paraspective/MAGI-v2/hardware/cad/README.md

# MAGI Quadruped 3D Print Models

3D manufacturing design files for the physical chassis of the 12-DOF quadruped.

---

## Assembly CAD File

* **[MAGI.3mf](file:///home/aki/Downloads/MAGI/model%20&miscellenious/MAGI.3mf/)**: Master 3D Manufacturing Format project. Contains print tray layouts, settings, and parts list for the full assembly including:
  * Central electronics enclosure (mounting plates for Raspberry Pi 4 and ESP32)
  * Battery compartment and chassis frames
  * 3-DOF leg links: Coxa (hip rotation), Femur (upper leg), and Tibia (lower leg)
  * Servomotor joint brackets scaled for MG996R standard servos
