paraspective/MAGI-v2/media/README.md

# 🎬 MAGI Media & Demonstrations

This directory contains media recordings and demonstration videos of the MAGI Quadruped Robot.

---

## 📹 Videos

* **`NERV_video_MAGI.mp4`**: Demonstration showing the Eva-inspired boot sequences, system telemetry, and physical gait coordination loops.
