paraspective/MAGI-v2/docs/research/README.md

# 🔬 Theoretical Foundations & Architectural Whitepapers

This directory contains research whitepapers and theoretical derivations of the MAGI quadruped robotics architecture.

---

## 📑 Documents

1. **[`MAGI_ Complete Architectural Context.pdf`](MAGI_%20Complete%20Architectural%20Context.pdf)**
   - Complete technical specification of the multi-process ZeroMQ operating system, core pinning strategies, POSIX shared memory ring buffers, and node lifecycle finite-state machines.

2. **[`MAGI_Project_Final__.pdf`](MAGI_Project_Final__.pdf)**
   - Comprehensive project report covering the problem formulation, mechanical linkage stress calculations, agricultural requirements, and experimental testing.

3. **[`leg_FK_IK_math_and_python.pdf`](leg_FK_IK_math_and_python.pdf)**
   - Analytical derivation of the 3-DOF forward and inverse kinematics equations, geometric transformations, and Python reference implementation.
