paraspective/MAGI-v2/archive/urdf_iterations/URDF_initial/debug/extraction_report.md

# Extraction Report: MAGI_Assembly_URDF v1

**Exported:** 2026-08-22T17:00:06.268843
**Exporter:** v3.1.0

## Summary

| Metric | Value |
|---|---|
| Occurrences | 28 |
| Subassemblies | 0 |
| Leaf components | 28 |
| Joints (total) | 27 |
| As-built joints | 0 |
| Regular joints | 27 |
| Max nesting depth | 0 |

## Assembly Hierarchy

```
[MAGI_Assembly_URDF]  (design root)
  ├── HQpod_Coxal_Left_v2  (265.7g)
  ├── HQpod_Coxal_Left_v2  (265.7g)
  ├── HQpod_Coxal_Right_v2  (265.9g)
  ├── HQpod_Coxal_Right_v2  (265.9g)
  ├── HQpod_Coxal_Right_v2  (265.9g)
  ├── HQpod_Femur  (175.9g)
  ├── HQpod_Femur  (175.9g)
  ├── HQpod_Femur  (175.9g)
  ├── HQpod_Femur  (175.9g)
  ├── HQpod_Tibia_Left  (0.0g)
  ├── HQpod_Tibia_Left  (0.0g)
  ├── HQpod_Tibia_Right  (0.0g)
  ├── HQpod_Tibia_Right  (0.0g)
  ├── HexapodV3Mid  (430.7g)
  ├── HexapodV3Top  (1329.1g)
  ├── MG996R_servo  (240.1g)
  ├── MG996R_servo  (240.1g)
  ├── MG996R_servo  (240.1g)
  ├── MG996R_servo  (240.1g)
  ├── MG996R_servo  (240.1g)
  ├── MG996R_servo  (240.1g)
  ├── MG996R_servo  (240.1g)
  ├── MG996R_servo  (240.1g)
  ├── MG996R_servo  (240.1g)
  ├── MG996R_servo  (240.1g)
  ├── MG996R_servo  (240.1g)
  ├── MG996R_servo  (240.1g)
  ├── base_link  (461.4g)
```

## Occurrences

### Depth 0

#### 🔧 COMPONENT: `HQpod_Coxal_Left_v2`

| Property | Value |
|---|---|
| Full path | `HQpod_Coxal_Left_v2 v2:2` |
| Component name | HQpod_Coxal_Left_v2 v2 |
| Depth | 0 |
| Path segments | HQpod_Coxal_Left_v2 |
| **Transforms** | |
| Global position (m) | (-0.404878, 0.654014, 0.791767) |
| Global position (mm) | (-404.88, 654.01, 791.77) |
| Local transform (m) | (-0.404878, 0.654014, 0.791767) |
| Assembly context depth | 0 |
| transform2 (m) | (-0.404878, 0.654014, 0.791767) |
| **Physical** | |
| Mass | 0.265679 kg (265.679 g) |
| Volume | 3.384446e-05 m³ |
| Density | 7850.0 kg/m³ |
| Surface area | 1.688216e-02 m² |
| Body count | 1 |
| CoM (component-local, m) | (0.654519, 0.530483, 0.143259) |
| CoM (global, m) | (0.249641, 1.184497, 0.935026) |
| CoM (global, mm) | (249.64, 1184.50, 935.03) |
| **Inertia at origin (kg·m²)** | |
| Ixx, Iyy, Izz | 8.034032e-02, 1.193965e-01, 1.887933e-01 |
| Ixy, Ixz, Iyz | -9.225148e-02, -2.491133e-02, -2.019216e-02 |
| **Inertia at CoM (kg·m²)** | |
| Ixx, Iyy, Izz | 1.224354e-04, 1.284590e-04, 2.124719e-04 |
| Ixy, Ixz, Iyz | -4.781184e-06, 2.049328e-07, -1.526211e-06 |
| Bounding box (m) | 0.0612 × 0.0743 × 0.0288 |
| Bounding box (mm) | 61.20 × 74.25 × 28.79 |
| **Material & Appearance** | |
| Material | Steel |
| Appearance | Steel_Satin |
| Color (RGB 0-1) | (0.627, 0.627, 0.627) |
| Color (RGB 0-255) | (160, 160, 160) |

#### 🔧 COMPONENT: `HQpod_Coxal_Left_v2`

| Property | Value |
|---|---|
| Full path | `HQpod_Coxal_Left_v2 v2:3` |
| Component name | HQpod_Coxal_Left_v2 v2 |
| Depth | 0 |
| Path segments | HQpod_Coxal_Left_v2 |
| **Transforms** | |
| Global position (m) | (0.781262, 1.371194, 0.791767) |
| Global position (mm) | (781.26, 1371.19, 791.77) |
| Local transform (m) | (0.781262, 1.371194, 0.791767) |
| Assembly context depth | 0 |
| transform2 (m) | (0.781262, 1.371194, 0.791767) |
| **Physical** | |
| Mass | 0.265679 kg (265.679 g) |
| Volume | 3.384446e-05 m³ |
| Density | 7850.0 kg/m³ |
| Surface area | 1.688216e-02 m² |
| Body count | 1 |
| CoM (component-local, m) | (0.654519, 0.530483, 0.143259) |
| CoM (global, m) | (1.435781, 1.901677, 0.935026) |
| CoM (global, mm) | (1435.78, 1901.68, 935.03) |
| **Inertia at origin (kg·m²)** | |
| Ixx, Iyy, Izz | 8.034032e-02, 1.193965e-01, 1.887933e-01 |
| Ixy, Ixz, Iyz | -9.225148e-02, -2.491133e-02, -2.019216e-02 |
| **Inertia at CoM (kg·m²)** | |
| Ixx, Iyy, Izz | 1.224354e-04, 1.284590e-04, 2.124719e-04 |
| Ixy, Ixz, Iyz | -4.781184e-06, 2.049328e-07, -1.526211e-06 |
| Bounding box (m) | 0.0612 × 0.0743 × 0.0288 |
| Bounding box (mm) | 61.20 × 74.25 × 28.79 |
| **Material & Appearance** | |
| Material | Steel |
| Appearance | Steel_Satin |
| Color (RGB 0-1) | (0.627, 0.627, 0.627) |
| Color (RGB 0-255) | (160, 160, 160) |

#### 🔧 COMPONENT: `HQpod_Coxal_Right_v2`

| Property | Value |
|---|---|
| Full path | `HQpod_Coxal_Right_v2 v2:1` |
| Component name | HQpod_Coxal_Right_v2 v2 |
| Depth | 0 |
| Path segments | HQpod_Coxal_Right_v2 |
| **Transforms** | |
| Global position (m) | (0.451506, 1.303633, 0.793772) |
| Global position (mm) | (451.51, 1303.63, 793.77) |
| Local transform (m) | (0.451506, 1.303633, 0.793772) |
| Assembly context depth | 0 |
| transform2 (m) | (0.451506, 1.303633, 0.793772) |
| **Physical** | |
| Mass | 0.265916 kg (265.916 g) |
| Volume | 3.387469e-05 m³ |
| Density | 7850.0 kg/m³ |
| Surface area | 1.687297e-02 m² |
| Body count | 1 |
| CoM (component-local, m) | (0.656485, -0.209995, 0.143258) |
| CoM (global, m) | (1.107991, 1.093638, 0.937030) |
| CoM (global, mm) | (1107.99, 1093.64, 937.03) |
| **Inertia at origin (kg·m²)** | |
| Ixx, Iyy, Izz | 1.730728e-02, 1.201908e-01, 1.265447e-01 |
| Ixy, Ixz, Iyz | 3.666486e-02, -2.500879e-02, 8.001501e-03 |
| **Inertia at CoM (kg·m²)** | |
| Ixx, Iyy, Izz | 1.236173e-04, 1.306979e-04, 2.156704e-04 |
| Ixy, Ixz, Iyz | 6.091416e-06, -2.158245e-07, 1.833670e-06 |
| Bounding box (m) | 0.0612 × 0.0743 × 0.0288 |
| Bounding box (mm) | 61.20 × 74.25 × 28.79 |
| **Material & Appearance** | |
| Material | Steel |
| Appearance | Steel_Satin |
| Color (RGB 0-1) | (0.627, 0.627, 0.627) |
| Color (RGB 0-255) | (160, 160, 160) |

#### 🔧 COMPONENT: `HQpod_Coxal_Right_v2`

| Property | Value |
|---|---|
| Full path | `HQpod_Coxal_Right_v2 v2:2` |
| Component name | HQpod_Coxal_Right_v2 v2 |
| Depth | 0 |
| Path segments | HQpod_Coxal_Right_v2 |
| **Transforms** | |
| Global position (m) | (0.551768, 0.878564, 0.793126) |
| Global position (mm) | (551.77, 878.56, 793.13) |
| Local transform (m) | (0.551768, 0.878564, 0.793126) |
| Assembly context depth | 0 |
| transform2 (m) | (0.551768, 0.878564, 0.793126) |
| **Physical** | |
| Mass | 0.265916 kg (265.916 g) |
| Volume | 3.387469e-05 m³ |
| Density | 7850.0 kg/m³ |
| Surface area | 1.687297e-02 m² |
| Body count | 1 |
| CoM (component-local, m) | (0.656485, -0.209995, 0.143258) |
| CoM (global, m) | (1.208253, 0.668570, 0.936384) |
| CoM (global, mm) | (1208.25, 668.57, 936.38) |
| **Inertia at origin (kg·m²)** | |
| Ixx, Iyy, Izz | 1.730728e-02, 1.201908e-01, 1.265447e-01 |
| Ixy, Ixz, Iyz | 3.666486e-02, -2.500879e-02, 8.001501e-03 |
| **Inertia at CoM (kg·m²)** | |
| Ixx, Iyy, Izz | 1.236173e-04, 1.306979e-04, 2.156704e-04 |
| Ixy, Ixz, Iyz | 6.091416e-06, -2.158245e-07, 1.833670e-06 |
| Bounding box (m) | 0.0612 × 0.0743 × 0.0288 |
| Bounding box (mm) | 61.20 × 74.25 × 28.79 |
| **Material & Appearance** | |
| Material | Steel |
| Appearance | Steel_Satin |
| Color (RGB 0-1) | (0.627, 0.627, 0.627) |
| Color (RGB 0-255) | (160, 160, 160) |

#### 🔧 COMPONENT: `HQpod_Coxal_Right_v2`

| Property | Value |
|---|---|
| Full path | `HQpod_Coxal_Right_v2 v2:3` |
| Component name | HQpod_Coxal_Right_v2 v2 |
| Depth | 0 |
| Path segments | HQpod_Coxal_Right_v2 |
| **Transforms** | |
| Global position (m) | (-0.175460, 1.146328, 0.793126) |
| Global position (mm) | (-175.46, 1146.33, 793.13) |
| Local transform (m) | (-0.175460, 1.146328, 0.793126) |
| Assembly context depth | 0 |
| transform2 (m) | (-0.175460, 1.146328, 0.793126) |
| **Physical** | |
| Mass | 0.265916 kg (265.916 g) |
| Volume | 3.387469e-05 m³ |
| Density | 7850.0 kg/m³ |
| Surface area | 1.687297e-02 m² |
| Body count | 1 |
| CoM (component-local, m) | (0.656485, -0.209995, 0.143258) |
| CoM (global, m) | (0.481025, 0.936334, 0.936384) |
| CoM (global, mm) | (481.02, 936.33, 936.38) |
| **Inertia at origin (kg·m²)** | |
| Ixx, Iyy, Izz | 1.730728e-02, 1.201908e-01, 1.265447e-01 |
| Ixy, Ixz, Iyz | 3.666486e-02, -2.500879e-02, 8.001501e-03 |
| **Inertia at CoM (kg·m²)** | |
| Ixx, Iyy, Izz | 1.236173e-04, 1.306979e-04, 2.156704e-04 |
| Ixy, Ixz, Iyz | 6.091416e-06, -2.158245e-07, 1.833670e-06 |
| Bounding box (m) | 0.0612 × 0.0743 × 0.0288 |
| Bounding box (mm) | 61.20 × 74.25 × 28.79 |
| **Material & Appearance** | |
| Material | Steel |
| Appearance | Steel_Satin |
| Color (RGB 0-1) | (0.627, 0.627, 0.627) |
| Color (RGB 0-255) | (160, 160, 160) |

#### 🔧 COMPONENT: `HQpod_Femur`

| Property | Value |
|---|---|
| Full path | `HQpod_Femur v3:1` |
| Component name | HQpod_Femur v3 |
| Depth | 0 |
| Path segments | HQpod_Femur |
| **Transforms** | |
| Global position (m) | (0.397256, 0.479610, 0.829249) |
| Global position (mm) | (397.26, 479.61, 829.25) |
| Local transform (m) | (0.397256, 0.479610, 0.829249) |
| Assembly context depth | 0 |
| transform2 (m) | (0.397256, 0.479610, 0.829249) |
| **Physical** | |
| Mass | 0.175899 kg (175.899 g) |
| Volume | 2.240754e-05 m³ |
| Density | 7850.0 kg/m³ |
| Surface area | 1.302929e-02 m² |
| Body count | 1 |
| CoM (component-local, m) | (-0.322334, 0.640897, 0.531177) |
| CoM (global, m) | (0.074922, 1.120507, 1.360426) |
| CoM (global, mm) | (74.92, 1120.51, 1360.43) |
| **Inertia at origin (kg·m²)** | |
| Ixx, Iyy, Izz | 1.219842e-01, 6.806643e-02, 9.060316e-02 |
| Ixy, Ixz, Iyz | 3.633776e-02, 3.011686e-02, -5.988123e-02 |
| **Inertia at CoM (kg·m²)** | |
| Ixx, Iyy, Izz | 1.041289e-04, 1.608826e-04, 7.700635e-05 |
| Ixy, Ixz, Iyz | -1.829894e-08, 1.747986e-08, 1.882122e-08 |
| Bounding box (m) | 0.0850 × 0.0260 × 0.0561 |
| Bounding box (mm) | 85.00 × 26.00 × 56.10 |
| **Material & Appearance** | |
| Material | Steel |
| Appearance | Steel_Satin |
| Color (RGB 0-1) | (0.627, 0.627, 0.627) |
| Color (RGB 0-255) | (160, 160, 160) |

#### 🔧 COMPONENT: `HQpod_Femur`

| Property | Value |
|---|---|
| Full path | `HQpod_Femur v3:2` |
| Component name | HQpod_Femur v3 |
| Depth | 0 |
| Path segments | HQpod_Femur |
| **Transforms** | |
| Global position (m) | (-0.080593, 1.488554, -0.603287) |
| Global position (mm) | (-80.59, 1488.55, -603.29) |
| Local transform (m) | (-0.080593, 1.488554, -0.603287) |
| Assembly context depth | 0 |
| transform2 (m) | (-0.080593, 1.488554, -0.603287) |
| **Physical** | |
| Mass | 0.175899 kg (175.899 g) |
| Volume | 2.240754e-05 m³ |
| Density | 7850.0 kg/m³ |
| Surface area | 1.302929e-02 m² |
| Body count | 1 |
| CoM (component-local, m) | (-0.322334, 0.640897, 0.531177) |
| CoM (global, m) | (-0.402928, 2.129450, -0.072110) |
| CoM (global, mm) | (-402.93, 2129.45, -72.11) |
| **Inertia at origin (kg·m²)** | |
| Ixx, Iyy, Izz | 1.219842e-01, 6.806643e-02, 9.060316e-02 |
| Ixy, Ixz, Iyz | 3.633776e-02, 3.011686e-02, -5.988123e-02 |
| **Inertia at CoM (kg·m²)** | |
| Ixx, Iyy, Izz | 1.041289e-04, 1.608826e-04, 7.700635e-05 |
| Ixy, Ixz, Iyz | -1.829894e-08, 1.747986e-08, 1.882122e-08 |
| Bounding box (m) | 0.0850 × 0.0260 × 0.0561 |
| Bounding box (mm) | 85.00 × 26.00 × 56.10 |
| **Material & Appearance** | |
| Material | Steel |
| Appearance | Steel_Satin |
| Color (RGB 0-1) | (0.627, 0.627, 0.627) |
| Color (RGB 0-255) | (160, 160, 160) |

#### 🔧 COMPONENT: `HQpod_Femur`

| Property | Value |
|---|---|
| Full path | `HQpod_Femur v3:3` |
| Component name | HQpod_Femur v3 |
| Depth | 0 |
| Path segments | HQpod_Femur |
| **Transforms** | |
| Global position (m) | (0.384606, 0.091160, 0.506403) |
| Global position (mm) | (384.61, 91.16, 506.40) |
| Local transform (m) | (0.384606, 0.091160, 0.506403) |
| Assembly context depth | 0 |
| transform2 (m) | (0.384606, 0.091160, 0.506403) |
| **Physical** | |
| Mass | 0.175899 kg (175.899 g) |
| Volume | 2.240754e-05 m³ |
| Density | 7850.0 kg/m³ |
| Surface area | 1.302929e-02 m² |
| Body count | 1 |
| CoM (component-local, m) | (-0.322334, 0.640897, 0.531177) |
| CoM (global, m) | (0.062272, 0.732057, 1.037580) |
| CoM (global, mm) | (62.27, 732.06, 1037.58) |
| **Inertia at origin (kg·m²)** | |
| Ixx, Iyy, Izz | 1.219842e-01, 6.806643e-02, 9.060316e-02 |
| Ixy, Ixz, Iyz | 3.633776e-02, 3.011686e-02, -5.988123e-02 |
| **Inertia at CoM (kg·m²)** | |
| Ixx, Iyy, Izz | 1.041289e-04, 1.608826e-04, 7.700635e-05 |
| Ixy, Ixz, Iyz | -1.829894e-08, 1.747986e-08, 1.882122e-08 |
| Bounding box (m) | 0.0850 × 0.0260 × 0.0561 |
| Bounding box (mm) | 85.00 × 26.00 × 56.10 |
| **Material & Appearance** | |
| Material | Steel |
| Appearance | Steel_Satin |
| Color (RGB 0-1) | (0.627, 0.627, 0.627) |
| Color (RGB 0-255) | (160, 160, 160) |

#### 🔧 COMPONENT: `HQpod_Femur`

| Property | Value |
|---|---|
| Full path | `HQpod_Femur v3:4` |
| Component name | HQpod_Femur v3 |
| Depth | 0 |
| Path segments | HQpod_Femur |
| **Transforms** | |
| Global position (m) | (-0.008310, 1.933742, 0.506368) |
| Global position (mm) | (-8.31, 1933.74, 506.37) |
| Local transform (m) | (-0.008310, 1.933742, 0.506368) |
| Assembly context depth | 0 |
| transform2 (m) | (-0.008310, 1.933742, 0.506368) |
| **Physical** | |
| Mass | 0.175899 kg (175.899 g) |
| Volume | 2.240754e-05 m³ |
| Density | 7850.0 kg/m³ |
| Surface area | 1.302929e-02 m² |
| Body count | 1 |
| CoM (component-local, m) | (-0.322334, 0.640897, 0.531177) |
| CoM (global, m) | (-0.330644, 2.574639, 1.037545) |
| CoM (global, mm) | (-330.64, 2574.64, 1037.55) |
| **Inertia at origin (kg·m²)** | |
| Ixx, Iyy, Izz | 1.219842e-01, 6.806643e-02, 9.060316e-02 |
| Ixy, Ixz, Iyz | 3.633776e-02, 3.011686e-02, -5.988123e-02 |
| **Inertia at CoM (kg·m²)** | |
| Ixx, Iyy, Izz | 1.041289e-04, 1.608826e-04, 7.700635e-05 |
| Ixy, Ixz, Iyz | -1.829894e-08, 1.747986e-08, 1.882122e-08 |
| Bounding box (m) | 0.0850 × 0.0260 × 0.0561 |
| Bounding box (mm) | 85.00 × 26.00 × 56.10 |
| **Material & Appearance** | |
| Material | Steel |
| Appearance | Steel_Satin |
| Color (RGB 0-1) | (0.627, 0.627, 0.627) |
| Color (RGB 0-255) | (160, 160, 160) |

#### 🔧 COMPONENT: `HQpod_Tibia_Left`

| Property | Value |
|---|---|
| Full path | `HQpod_Tibia_Left v3:1` |
| Component name | HQpod_Tibia_Left v3 |
| Depth | 0 |
| Path segments | HQpod_Tibia_Left |
| **Transforms** | |
| Global position (m) | (0.078693, 0.964779, 0.673691) |
| Global position (mm) | (78.69, 964.78, 673.69) |
| Local transform (m) | (0.078693, 0.964779, 0.673691) |
| Assembly context depth | 0 |
| transform2 (m) | (0.078693, 0.964779, 0.673691) |
| **Physical** | |
| Mass | 0.000000 kg (0.000 g) |
| Volume | 0.000000e+00 m³ |
| Density | 0.0 kg/m³ |
| Surface area | 1.569374e-02 m² |
| Body count | 1 |
| CoM (component-local, m) | (0.000000, 0.000000, 0.000000) |
| CoM (global, m) | (0.078693, 0.964779, 0.673691) |
| CoM (global, mm) | (78.69, 964.78, 673.69) |
| **Inertia at origin (kg·m²)** | |
| Ixx, Iyy, Izz | 0.000000e+00, 0.000000e+00, 0.000000e+00 |
| Ixy, Ixz, Iyz | 0.000000e+00, 0.000000e+00, 0.000000e+00 |
| **Inertia at CoM (kg·m²)** | |
| Ixx, Iyy, Izz | 0.000000e+00, 0.000000e+00, 0.000000e+00 |
| Ixy, Ixz, Iyz | 0.000000e+00, 0.000000e+00, 0.000000e+00 |
| Bounding box (m) | 0.1103 × 0.1045 × 0.0288 |
| Bounding box (mm) | 110.30 × 104.49 × 28.79 |
| **Material & Appearance** | |
| Material | Steel |
| Appearance | Steel_Satin |
| Color (RGB 0-1) | (0.627, 0.627, 0.627) |
| Color (RGB 0-255) | (160, 160, 160) |

#### 🔧 COMPONENT: `HQpod_Tibia_Left`

| Property | Value |
|---|---|
| Full path | `HQpod_Tibia_Left v3:2` |
| Component name | HQpod_Tibia_Left v3 |
| Depth | 0 |
| Path segments | HQpod_Tibia_Left |
| **Transforms** | |
| Global position (m) | (0.297362, 1.061010, 0.673593) |
| Global position (mm) | (297.36, 1061.01, 673.59) |
| Local transform (m) | (0.297362, 1.061010, 0.673593) |
| Assembly context depth | 0 |
| transform2 (m) | (0.297362, 1.061010, 0.673593) |
| **Physical** | |
| Mass | 0.000000 kg (0.000 g) |
| Volume | 0.000000e+00 m³ |
| Density | 0.0 kg/m³ |
| Surface area | 1.569374e-02 m² |
| Body count | 1 |
| CoM (component-local, m) | (0.000000, 0.000000, 0.000000) |
| CoM (global, m) | (0.297362, 1.061010, 0.673593) |
| CoM (global, mm) | (297.36, 1061.01, 673.59) |
| **Inertia at origin (kg·m²)** | |
| Ixx, Iyy, Izz | 0.000000e+00, 0.000000e+00, 0.000000e+00 |
| Ixy, Ixz, Iyz | 0.000000e+00, 0.000000e+00, 0.000000e+00 |
| **Inertia at CoM (kg·m²)** | |
| Ixx, Iyy, Izz | 0.000000e+00, 0.000000e+00, 0.000000e+00 |
| Ixy, Ixz, Iyz | 0.000000e+00, 0.000000e+00, 0.000000e+00 |
| Bounding box (m) | 0.1103 × 0.1045 × 0.0288 |
| Bounding box (mm) | 110.30 × 104.49 × 28.79 |
| **Material & Appearance** | |
| Material | Steel |
| Appearance | Steel_Satin |
| Color (RGB 0-1) | (0.627, 0.627, 0.627) |
| Color (RGB 0-255) | (160, 160, 160) |

#### 🔧 COMPONENT: `HQpod_Tibia_Right`

| Property | Value |
|---|---|
| Full path | `HQpod_Tibia_Right v4:1` |
| Component name | HQpod_Tibia_Right v4 |
| Depth | 0 |
| Path segments | HQpod_Tibia_Right |
| **Transforms** | |
| Global position (m) | (0.681661, 0.752503, 0.909144) |
| Global position (mm) | (681.66, 752.50, 909.14) |
| Local transform (m) | (0.681661, 0.752503, 0.909144) |
| Assembly context depth | 0 |
| transform2 (m) | (0.681661, 0.752503, 0.909144) |
| **Physical** | |
| Mass | 0.000000 kg (0.000 g) |
| Volume | 0.000000e+00 m³ |
| Density | 0.0 kg/m³ |
| Surface area | 1.565780e-02 m² |
| Body count | 1 |
| CoM (component-local, m) | (0.000000, 0.000000, 0.000000) |
| CoM (global, m) | (0.681661, 0.752503, 0.909144) |
| CoM (global, mm) | (681.66, 752.50, 909.14) |
| **Inertia at origin (kg·m²)** | |
| Ixx, Iyy, Izz | 0.000000e+00, 0.000000e+00, 0.000000e+00 |
| Ixy, Ixz, Iyz | 0.000000e+00, 0.000000e+00, 0.000000e+00 |
| **Inertia at CoM (kg·m²)** | |
| Ixx, Iyy, Izz | 0.000000e+00, 0.000000e+00, 0.000000e+00 |
| Ixy, Ixz, Iyz | 0.000000e+00, 0.000000e+00, 0.000000e+00 |
| Bounding box (m) | 0.1103 × 0.1045 × 0.0288 |
| Bounding box (mm) | 110.30 × 104.49 × 28.79 |
| **Material & Appearance** | |
| Material | Steel |
| Appearance | Steel_Satin |
| Color (RGB 0-1) | (0.627, 0.627, 0.627) |
| Color (RGB 0-255) | (160, 160, 160) |

#### 🔧 COMPONENT: `HQpod_Tibia_Right`

| Property | Value |
|---|---|
| Full path | `HQpod_Tibia_Right v4:2` |
| Component name | HQpod_Tibia_Right v4 |
| Depth | 0 |
| Path segments | HQpod_Tibia_Right |
| **Transforms** | |
| Global position (m) | (-0.305643, 1.272667, 0.908881) |
| Global position (mm) | (-305.64, 1272.67, 908.88) |
| Local transform (m) | (-0.305643, 1.272667, 0.908881) |
| Assembly context depth | 0 |
| transform2 (m) | (-0.305643, 1.272667, 0.908881) |
| **Physical** | |
| Mass | 0.000000 kg (0.000 g) |
| Volume | 0.000000e+00 m³ |
| Density | 0.0 kg/m³ |
| Surface area | 1.565780e-02 m² |
| Body count | 1 |
| CoM (component-local, m) | (0.000000, 0.000000, 0.000000) |
| CoM (global, m) | (-0.305643, 1.272667, 0.908881) |
| CoM (global, mm) | (-305.64, 1272.67, 908.88) |
| **Inertia at origin (kg·m²)** | |
| Ixx, Iyy, Izz | 0.000000e+00, 0.000000e+00, 0.000000e+00 |
| Ixy, Ixz, Iyz | 0.000000e+00, 0.000000e+00, 0.000000e+00 |
| **Inertia at CoM (kg·m²)** | |
| Ixx, Iyy, Izz | 0.000000e+00, 0.000000e+00, 0.000000e+00 |
| Ixy, Ixz, Iyz | 0.000000e+00, 0.000000e+00, 0.000000e+00 |
| Bounding box (m) | 0.1103 × 0.1045 × 0.0288 |
| Bounding box (mm) | 110.30 × 104.49 × 28.79 |
| **Material & Appearance** | |
| Material | Steel |
| Appearance | Steel_Satin |
| Color (RGB 0-1) | (0.627, 0.627, 0.627) |
| Color (RGB 0-255) | (160, 160, 160) |

#### 🔧 COMPONENT: `HexapodV3Mid`

| Property | Value |
|---|---|
| Full path | `HexapodV3Mid v5:1` |
| Component name | HexapodV3Mid v5 |
| Depth | 0 |
| Path segments | HexapodV3Mid |
| **Transforms** | |
| Global position (m) | (0.113207, 1.351156, -0.242000) |
| Global position (mm) | (113.21, 1351.16, -242.00) |
| Local transform (m) | (0.113207, 1.351156, -0.242000) |
| Assembly context depth | 0 |
| transform2 (m) | (0.113207, 1.351156, -0.242000) |
| **Physical** | |
| Mass | 0.430715 kg (430.715 g) |
| Volume | 5.486815e-05 m³ |
| Density | 7850.0 kg/m³ |
| Surface area | 4.293367e-02 m² |
| Body count | 1 |
| CoM (component-local, m) | (0.056935, -0.338657, 0.392833) |
| CoM (global, m) | (0.170142, 1.012498, 0.150833) |
| CoM (global, mm) | (170.14, 1012.50, 150.83) |
| **Inertia at origin (kg·m²)** | |
| Ixx, Iyy, Izz | 1.162344e-01, 6.948798e-02, 5.277708e-02 |
| Ixy, Ixz, Iyz | 8.305790e-03, -9.600812e-03, 5.730056e-02 |
| **Inertia at CoM (kg·m²)** | |
| Ixx, Iyy, Izz | 3.691505e-04, 1.624727e-03, 1.982639e-03 |
| Ixy, Ixz, Iyz | 9.189307e-07, 3.260568e-05, 1.642784e-08 |
| Bounding box (m) | 0.2205 × 0.1193 × 0.0250 |
| Bounding box (mm) | 220.46 × 119.29 × 25.00 |
| **Material & Appearance** | |
| Material | Steel |
| Appearance | Steel_Satin |
| Color (RGB 0-1) | (0.627, 0.627, 0.627) |
| Color (RGB 0-255) | (160, 160, 160) |

#### 🔧 COMPONENT: `HexapodV3Top`

| Property | Value |
|---|---|
| Full path | `HexapodV3Top v3:1` |
| Component name | HexapodV3Top v3 |
| Depth | 0 |
| Path segments | HexapodV3Top |
| **Transforms** | |
| Global position (m) | (0.038772, -1.500410, -0.089852) |
| Global position (mm) | (38.77, -1500.41, -89.85) |
| Local transform (m) | (0.038772, -1.500410, -0.089852) |
| Assembly context depth | 0 |
| transform2 (m) | (0.038772, -1.500410, -0.089852) |
| **Physical** | |
| Mass | 1.329055 kg (1329.055 g) |
| Volume | 1.693064e-04 m³ |
| Density | 7850.0 kg/m³ |
| Surface area | 8.391715e-02 m² |
| Body count | 1 |
| CoM (component-local, m) | (0.148577, 2.513000, 0.237965) |
| CoM (global, m) | (0.187350, 1.012589, 0.148113) |
| CoM (global, mm) | (187.35, 1012.59, 148.11) |
| **Inertia at origin (kg·m²)** | |
| Ixx, Iyy, Izz | 8.474005e+00, 1.110737e-01, 8.434363e+00 |
| Ixy, Ixz, Iyz | -4.962347e-01, -4.698214e-02, -7.947849e-01 |
| **Inertia at CoM (kg·m²)** | |
| Ixx, Iyy, Izz | 5.538158e-03, 6.473322e-03, 1.181787e-02 |
| Ixy, Ixz, Iyz | 1.518249e-06, 8.338057e-06, -5.310300e-07 |
| Bounding box (m) | 0.2400 × 0.1974 × 0.0288 |
| Bounding box (mm) | 240.00 × 197.41 × 28.79 |
| **Material & Appearance** | |
| Material | Steel |
| Appearance | Steel_Satin |
| Color (RGB 0-1) | (0.627, 0.627, 0.627) |
| Color (RGB 0-255) | (160, 160, 160) |

#### 🔧 COMPONENT: `MG996R_servo`

| Property | Value |
|---|---|
| Full path | `MG996R_servo v1:1` |
| Component name | MG996R_servo v1 |
| Depth | 0 |
| Path segments | MG996R_servo |
| **Transforms** | |
| Global position (m) | (0.093697, 0.936976, 0.121750) |
| Global position (mm) | (93.70, 936.98, 121.75) |
| Local transform (m) | (0.093697, 0.936976, 0.121750) |
| Assembly context depth | 0 |
| transform2 (m) | (0.093697, 0.936976, 0.121750) |
| **Physical** | |
| Mass | 0.240073 kg (240.073 g) |
| Volume | 3.058254e-05 m³ |
| Density | 7850.0 kg/m³ |
| Surface area | 7.545639e-03 m² |
| Body count | 2 |
| CoM (component-local, m) | (0.020183, 0.019509, 0.000018) |
| CoM (global, m) | (0.113880, 0.956485, 0.121768) |
| CoM (global, mm) | (113.88, 956.49, 121.77) |
| **Inertia at origin (kg·m²)** | |
| Ixx, Iyy, Izz | 1.274550e-04, 1.382840e-04, 2.503359e-04 |
| Ixy, Ixz, Iyz | -9.390388e-05, -3.854612e-08, -1.701040e-07 |
| **Inertia at CoM (kg·m²)** | |
| Ixx, Iyy, Izz | 3.608015e-05, 4.048873e-05, 6.116593e-05 |
| Ixy, Ixz, Iyz | 6.266312e-07, 4.838323e-08, -8.607661e-08 |
| Bounding box (m) | 0.0533 × 0.0435 × 0.0200 |
| Bounding box (mm) | 53.30 × 43.49 × 20.00 |
| **Material & Appearance** | |
| Material | Steel |
| Appearance | Opaque_76_76_76 |
| Color (RGB 0-1) | (0.298, 0.298, 0.298) |
| Color (RGB 0-255) | (76, 76, 76) |
| **Per-body breakdown** | |
| Body 0: Body1 | mass=237.031g, material=Steel, inertia_src=api |
| Body 1: Body2 | mass=3.041g, material=Steel, inertia_src=api |

#### 🔧 COMPONENT: `MG996R_servo`

| Property | Value |
|---|---|
| Full path | `MG996R_servo v1:10` |
| Component name | MG996R_servo v1 |
| Depth | 0 |
| Path segments | MG996R_servo |
| **Transforms** | |
| Global position (m) | (0.321864, 0.867988, 0.103058) |
| Global position (mm) | (321.86, 867.99, 103.06) |
| Local transform (m) | (0.321864, 0.867988, 0.103058) |
| Assembly context depth | 0 |
| transform2 (m) | (0.321864, 0.867988, 0.103058) |
| **Physical** | |
| Mass | 0.240073 kg (240.073 g) |
| Volume | 3.058254e-05 m³ |
| Density | 7850.0 kg/m³ |
| Surface area | 7.545639e-03 m² |
| Body count | 2 |
| CoM (component-local, m) | (0.020183, 0.019509, 0.000018) |
| CoM (global, m) | (0.342047, 0.887498, 0.103076) |
| CoM (global, mm) | (342.05, 887.50, 103.08) |
| **Inertia at origin (kg·m²)** | |
| Ixx, Iyy, Izz | 1.274550e-04, 1.382840e-04, 2.503359e-04 |
| Ixy, Ixz, Iyz | -9.390388e-05, -3.854612e-08, -1.701040e-07 |
| **Inertia at CoM (kg·m²)** | |
| Ixx, Iyy, Izz | 3.608015e-05, 4.048873e-05, 6.116593e-05 |
| Ixy, Ixz, Iyz | 6.266312e-07, 4.838323e-08, -8.607661e-08 |
| Bounding box (m) | 0.0533 × 0.0435 × 0.0200 |
| Bounding box (mm) | 53.30 × 43.49 × 20.00 |
| **Material & Appearance** | |
| Material | Steel |
| Appearance | Opaque_76_76_76 |
| Color (RGB 0-1) | (0.298, 0.298, 0.298) |
| Color (RGB 0-255) | (76, 76, 76) |
| **Per-body breakdown** | |
| Body 0: Body1 | mass=237.031g, material=Steel, inertia_src=api |
| Body 1: Body2 | mass=3.041g, material=Steel, inertia_src=api |

#### 🔧 COMPONENT: `MG996R_servo`

| Property | Value |
|---|---|
| Full path | `MG996R_servo v1:11` |
| Component name | MG996R_servo v1 |
| Depth | 0 |
| Path segments | MG996R_servo |
| **Transforms** | |
| Global position (m) | (0.054432, 1.156914, 0.103023) |
| Global position (mm) | (54.43, 1156.91, 103.02) |
| Local transform (m) | (0.054432, 1.156914, 0.103023) |
| Assembly context depth | 0 |
| transform2 (m) | (0.054432, 1.156914, 0.103023) |
| **Physical** | |
| Mass | 0.240073 kg (240.073 g) |
| Volume | 3.058254e-05 m³ |
| Density | 7850.0 kg/m³ |
| Surface area | 7.545639e-03 m² |
| Body count | 2 |
| CoM (component-local, m) | (0.020183, 0.019509, 0.000018) |
| CoM (global, m) | (0.074615, 1.176424, 0.103041) |
| CoM (global, mm) | (74.62, 1176.42, 103.04) |
| **Inertia at origin (kg·m²)** | |
| Ixx, Iyy, Izz | 1.274550e-04, 1.382840e-04, 2.503359e-04 |
| Ixy, Ixz, Iyz | -9.390388e-05, -3.854612e-08, -1.701040e-07 |
| **Inertia at CoM (kg·m²)** | |
| Ixx, Iyy, Izz | 3.608015e-05, 4.048873e-05, 6.116593e-05 |
| Ixy, Ixz, Iyz | 6.266312e-07, 4.838323e-08, -8.607661e-08 |
| Bounding box (m) | 0.0533 × 0.0435 × 0.0200 |
| Bounding box (mm) | 53.30 × 43.49 × 20.00 |
| **Material & Appearance** | |
| Material | Steel |
| Appearance | Opaque_76_76_76 |
| Color (RGB 0-1) | (0.298, 0.298, 0.298) |
| Color (RGB 0-255) | (76, 76, 76) |
| **Per-body breakdown** | |
| Body 0: Body1 | mass=237.031g, material=Steel, inertia_src=api |
| Body 1: Body2 | mass=3.041g, material=Steel, inertia_src=api |

#### 🔧 COMPONENT: `MG996R_servo`

| Property | Value |
|---|---|
| Full path | `MG996R_servo v1:12` |
| Component name | MG996R_servo v1 |
| Depth | 0 |
| Path segments | MG996R_servo |
| **Transforms** | |
| Global position (m) | (0.084555, 1.128003, 0.116664) |
| Global position (mm) | (84.55, 1128.00, 116.66) |
| Local transform (m) | (0.084555, 1.128003, 0.116664) |
| Assembly context depth | 0 |
| transform2 (m) | (0.084555, 1.128003, 0.116664) |
| **Physical** | |
| Mass | 0.240073 kg (240.073 g) |
| Volume | 3.058254e-05 m³ |
| Density | 7850.0 kg/m³ |
| Surface area | 7.545639e-03 m² |
| Body count | 2 |
| CoM (component-local, m) | (0.020183, 0.019509, 0.000018) |
| CoM (global, m) | (0.104738, 1.147512, 0.116682) |
| CoM (global, mm) | (104.74, 1147.51, 116.68) |
| **Inertia at origin (kg·m²)** | |
| Ixx, Iyy, Izz | 1.274550e-04, 1.382840e-04, 2.503359e-04 |
| Ixy, Ixz, Iyz | -9.390388e-05, -3.854612e-08, -1.701040e-07 |
| **Inertia at CoM (kg·m²)** | |
| Ixx, Iyy, Izz | 3.608015e-05, 4.048873e-05, 6.116593e-05 |
| Ixy, Ixz, Iyz | 6.266312e-07, 4.838323e-08, -8.607661e-08 |
| Bounding box (m) | 0.0533 × 0.0435 × 0.0200 |
| Bounding box (mm) | 53.30 × 43.49 × 20.00 |
| **Material & Appearance** | |
| Material | Steel |
| Appearance | Opaque_76_76_76 |
| Color (RGB 0-1) | (0.298, 0.298, 0.298) |
| Color (RGB 0-255) | (76, 76, 76) |
| **Per-body breakdown** | |
| Body 0: Body1 | mass=237.031g, material=Steel, inertia_src=api |
| Body 1: Body2 | mass=3.041g, material=Steel, inertia_src=api |

#### 🔧 COMPONENT: `MG996R_servo`

| Property | Value |
|---|---|
| Full path | `MG996R_servo v1:13` |
| Component name | MG996R_servo v1 |
| Depth | 0 |
| Path segments | MG996R_servo |
| **Transforms** | |
| Global position (m) | (0.093512, 1.088137, 0.121104) |
| Global position (mm) | (93.51, 1088.14, 121.10) |
| Local transform (m) | (0.093512, 1.088137, 0.121104) |
| Assembly context depth | 0 |
| transform2 (m) | (0.093512, 1.088137, 0.121104) |
| **Physical** | |
| Mass | 0.240073 kg (240.073 g) |
| Volume | 3.058254e-05 m³ |
| Density | 7850.0 kg/m³ |
| Surface area | 7.545639e-03 m² |
| Body count | 2 |
| CoM (component-local, m) | (0.020183, 0.019509, 0.000018) |
| CoM (global, m) | (0.113695, 1.107646, 0.121122) |
| CoM (global, mm) | (113.69, 1107.65, 121.12) |
| **Inertia at origin (kg·m²)** | |
| Ixx, Iyy, Izz | 1.274550e-04, 1.382840e-04, 2.503359e-04 |
| Ixy, Ixz, Iyz | -9.390388e-05, -3.854612e-08, -1.701040e-07 |
| **Inertia at CoM (kg·m²)** | |
| Ixx, Iyy, Izz | 3.608015e-05, 4.048873e-05, 6.116593e-05 |
| Ixy, Ixz, Iyz | 6.266312e-07, 4.838323e-08, -8.607661e-08 |
| Bounding box (m) | 0.0533 × 0.0435 × 0.0200 |
| Bounding box (mm) | 53.30 × 43.49 × 20.00 |
| **Material & Appearance** | |
| Material | Steel |
| Appearance | Opaque_76_76_76 |
| Color (RGB 0-1) | (0.298, 0.298, 0.298) |
| Color (RGB 0-255) | (76, 76, 76) |
| **Per-body breakdown** | |
| Body 0: Body1 | mass=237.031g, material=Steel, inertia_src=api |
| Body 1: Body2 | mass=3.041g, material=Steel, inertia_src=api |

#### 🔧 COMPONENT: `MG996R_servo`

| Property | Value |
|---|---|
| Full path | `MG996R_servo v1:2` |
| Component name | MG996R_servo v1 |
| Depth | 0 |
| Path segments | MG996R_servo |
| **Transforms** | |
| Global position (m) | (0.085017, 0.897030, 0.117344) |
| Global position (mm) | (85.02, 897.03, 117.34) |
| Local transform (m) | (0.085017, 0.897030, 0.117344) |
| Assembly context depth | 0 |
| transform2 (m) | (0.085017, 0.897030, 0.117344) |
| **Physical** | |
| Mass | 0.240073 kg (240.073 g) |
| Volume | 3.058254e-05 m³ |
| Density | 7850.0 kg/m³ |
| Surface area | 7.545639e-03 m² |
| Body count | 2 |
| CoM (component-local, m) | (0.020183, 0.019509, 0.000018) |
| CoM (global, m) | (0.105200, 0.916539, 0.117362) |
| CoM (global, mm) | (105.20, 916.54, 117.36) |
| **Inertia at origin (kg·m²)** | |
| Ixx, Iyy, Izz | 1.274550e-04, 1.382840e-04, 2.503359e-04 |
| Ixy, Ixz, Iyz | -9.390388e-05, -3.854612e-08, -1.701040e-07 |
| **Inertia at CoM (kg·m²)** | |
| Ixx, Iyy, Izz | 3.608015e-05, 4.048873e-05, 6.116593e-05 |
| Ixy, Ixz, Iyz | 6.266312e-07, 4.838323e-08, -8.607661e-08 |
| Bounding box (m) | 0.0533 × 0.0435 × 0.0200 |
| Bounding box (mm) | 53.30 × 43.49 × 20.00 |
| **Material & Appearance** | |
| Material | Steel |
| Appearance | Opaque_76_76_76 |
| Color (RGB 0-1) | (0.298, 0.298, 0.298) |
| Color (RGB 0-255) | (76, 76, 76) |
| **Per-body breakdown** | |
| Body 0: Body1 | mass=237.031g, material=Steel, inertia_src=api |
| Body 1: Body2 | mass=3.041g, material=Steel, inertia_src=api |

#### 🔧 COMPONENT: `MG996R_servo`

| Property | Value |
|---|---|
| Full path | `MG996R_servo v1:3` |
| Component name | MG996R_servo v1 |
| Depth | 0 |
| Path segments | MG996R_servo |
| **Transforms** | |
| Global position (m) | (0.055129, 0.868019, 0.103529) |
| Global position (mm) | (55.13, 868.02, 103.53) |
| Local transform (m) | (0.055129, 0.868019, 0.103529) |
| Assembly context depth | 0 |
| transform2 (m) | (0.055129, 0.868019, 0.103529) |
| **Physical** | |
| Mass | 0.240073 kg (240.073 g) |
| Volume | 3.058254e-05 m³ |
| Density | 7850.0 kg/m³ |
| Surface area | 7.545639e-03 m² |
| Body count | 2 |
| CoM (component-local, m) | (0.020183, 0.019509, 0.000018) |
| CoM (global, m) | (0.075312, 0.887528, 0.103547) |
| CoM (global, mm) | (75.31, 887.53, 103.55) |
| **Inertia at origin (kg·m²)** | |
| Ixx, Iyy, Izz | 1.274550e-04, 1.382840e-04, 2.503359e-04 |
| Ixy, Ixz, Iyz | -9.390388e-05, -3.854612e-08, -1.701040e-07 |
| **Inertia at CoM (kg·m²)** | |
| Ixx, Iyy, Izz | 3.608015e-05, 4.048873e-05, 6.116593e-05 |
| Ixy, Ixz, Iyz | 6.266312e-07, 4.838323e-08, -8.607661e-08 |
| Bounding box (m) | 0.0533 × 0.0435 × 0.0200 |
| Bounding box (mm) | 53.30 × 43.49 × 20.00 |
| **Material & Appearance** | |
| Material | Steel |
| Appearance | Opaque_76_76_76 |
| Color (RGB 0-1) | (0.298, 0.298, 0.298) |
| Color (RGB 0-255) | (76, 76, 76) |
| **Per-body breakdown** | |
| Body 0: Body1 | mass=237.031g, material=Steel, inertia_src=api |
| Body 1: Body2 | mass=3.041g, material=Steel, inertia_src=api |

#### 🔧 COMPONENT: `MG996R_servo`

| Property | Value |
|---|---|
| Full path | `MG996R_servo v1:4` |
| Component name | MG996R_servo v1 |
| Depth | 0 |
| Path segments | MG996R_servo |
| **Transforms** | |
| Global position (m) | (0.282688, 1.088232, 0.121750) |
| Global position (mm) | (282.69, 1088.23, 121.75) |
| Local transform (m) | (0.282688, 1.088232, 0.121750) |
| Assembly context depth | 0 |
| transform2 (m) | (0.282688, 1.088232, 0.121750) |
| **Physical** | |
| Mass | 0.240073 kg (240.073 g) |
| Volume | 3.058254e-05 m³ |
| Density | 7850.0 kg/m³ |
| Surface area | 7.545639e-03 m² |
| Body count | 2 |
| CoM (component-local, m) | (0.020183, 0.019509, 0.000018) |
| CoM (global, m) | (0.302871, 1.107741, 0.121768) |
| CoM (global, mm) | (302.87, 1107.74, 121.77) |
| **Inertia at origin (kg·m²)** | |
| Ixx, Iyy, Izz | 1.274550e-04, 1.382840e-04, 2.503359e-04 |
| Ixy, Ixz, Iyz | -9.390388e-05, -3.854612e-08, -1.701040e-07 |
| **Inertia at CoM (kg·m²)** | |
| Ixx, Iyy, Izz | 3.608015e-05, 4.048873e-05, 6.116593e-05 |
| Ixy, Ixz, Iyz | 6.266312e-07, 4.838323e-08, -8.607661e-08 |
| Bounding box (m) | 0.0533 × 0.0435 × 0.0200 |
| Bounding box (mm) | 53.30 × 43.49 × 20.00 |
| **Material & Appearance** | |
| Material | Steel |
| Appearance | Opaque_76_76_76 |
| Color (RGB 0-1) | (0.298, 0.298, 0.298) |
| Color (RGB 0-255) | (76, 76, 76) |
| **Per-body breakdown** | |
| Body 0: Body1 | mass=237.031g, material=Steel, inertia_src=api |
| Body 1: Body2 | mass=3.041g, material=Steel, inertia_src=api |

#### 🔧 COMPONENT: `MG996R_servo`

| Property | Value |
|---|---|
| Full path | `MG996R_servo v1:6` |
| Component name | MG996R_servo v1 |
| Depth | 0 |
| Path segments | MG996R_servo |
| **Transforms** | |
| Global position (m) | (0.291039, 1.128759, 0.117246) |
| Global position (mm) | (291.04, 1128.76, 117.25) |
| Local transform (m) | (0.291039, 1.128759, 0.117246) |
| Assembly context depth | 0 |
| transform2 (m) | (0.291039, 1.128759, 0.117246) |
| **Physical** | |
| Mass | 0.240073 kg (240.073 g) |
| Volume | 3.058254e-05 m³ |
| Density | 7850.0 kg/m³ |
| Surface area | 7.545639e-03 m² |
| Body count | 2 |
| CoM (component-local, m) | (0.020183, 0.019509, 0.000018) |
| CoM (global, m) | (0.311222, 1.148268, 0.117264) |
| CoM (global, mm) | (311.22, 1148.27, 117.26) |
| **Inertia at origin (kg·m²)** | |
| Ixx, Iyy, Izz | 1.274550e-04, 1.382840e-04, 2.503359e-04 |
| Ixy, Ixz, Iyz | -9.390388e-05, -3.854612e-08, -1.701040e-07 |
| **Inertia at CoM (kg·m²)** | |
| Ixx, Iyy, Izz | 3.608015e-05, 4.048873e-05, 6.116593e-05 |
| Ixy, Ixz, Iyz | 6.266312e-07, 4.838323e-08, -8.607661e-08 |
| Bounding box (m) | 0.0533 × 0.0435 × 0.0200 |
| Bounding box (mm) | 53.30 × 43.49 × 20.00 |
| **Material & Appearance** | |
| Material | Steel |
| Appearance | Opaque_76_76_76 |
| Color (RGB 0-1) | (0.298, 0.298, 0.298) |
| Color (RGB 0-255) | (76, 76, 76) |
| **Per-body breakdown** | |
| Body 0: Body1 | mass=237.031g, material=Steel, inertia_src=api |
| Body 1: Body2 | mass=3.041g, material=Steel, inertia_src=api |

#### 🔧 COMPONENT: `MG996R_servo`

| Property | Value |
|---|---|
| Full path | `MG996R_servo v1:7` |
| Component name | MG996R_servo v1 |
| Depth | 0 |
| Path segments | MG996R_servo |
| **Transforms** | |
| Global position (m) | (0.320926, 1.157770, 0.103431) |
| Global position (mm) | (320.93, 1157.77, 103.43) |
| Local transform (m) | (0.320926, 1.157770, 0.103431) |
| Assembly context depth | 0 |
| transform2 (m) | (0.320926, 1.157770, 0.103431) |
| **Physical** | |
| Mass | 0.240073 kg (240.073 g) |
| Volume | 3.058254e-05 m³ |
| Density | 7850.0 kg/m³ |
| Surface area | 7.545639e-03 m² |
| Body count | 2 |
| CoM (component-local, m) | (0.020183, 0.019509, 0.000018) |
| CoM (global, m) | (0.341110, 1.177279, 0.103449) |
| CoM (global, mm) | (341.11, 1177.28, 103.45) |
| **Inertia at origin (kg·m²)** | |
| Ixx, Iyy, Izz | 1.274550e-04, 1.382840e-04, 2.503359e-04 |
| Ixy, Ixz, Iyz | -9.390388e-05, -3.854612e-08, -1.701040e-07 |
| **Inertia at CoM (kg·m²)** | |
| Ixx, Iyy, Izz | 3.608015e-05, 4.048873e-05, 6.116593e-05 |
| Ixy, Ixz, Iyz | 6.266312e-07, 4.838323e-08, -8.607661e-08 |
| Bounding box (m) | 0.0533 × 0.0435 × 0.0200 |
| Bounding box (mm) | 53.30 × 43.49 × 20.00 |
| **Material & Appearance** | |
| Material | Steel |
| Appearance | Opaque_76_76_76 |
| Color (RGB 0-1) | (0.298, 0.298, 0.298) |
| Color (RGB 0-255) | (76, 76, 76) |
| **Per-body breakdown** | |
| Body 0: Body1 | mass=237.031g, material=Steel, inertia_src=api |
| Body 1: Body2 | mass=3.041g, material=Steel, inertia_src=api |

#### 🔧 COMPONENT: `MG996R_servo`

| Property | Value |
|---|---|
| Full path | `MG996R_servo v1:8` |
| Component name | MG996R_servo v1 |
| Depth | 0 |
| Path segments | MG996R_servo |
| **Transforms** | |
| Global position (m) | (0.282795, 0.936755, 0.121104) |
| Global position (mm) | (282.80, 936.76, 121.10) |
| Local transform (m) | (0.282795, 0.936755, 0.121104) |
| Assembly context depth | 0 |
| transform2 (m) | (0.282795, 0.936755, 0.121104) |
| **Physical** | |
| Mass | 0.240073 kg (240.073 g) |
| Volume | 3.058254e-05 m³ |
| Density | 7850.0 kg/m³ |
| Surface area | 7.545639e-03 m² |
| Body count | 2 |
| CoM (component-local, m) | (0.020183, 0.019509, 0.000018) |
| CoM (global, m) | (0.302978, 0.956265, 0.121122) |
| CoM (global, mm) | (302.98, 956.26, 121.12) |
| **Inertia at origin (kg·m²)** | |
| Ixx, Iyy, Izz | 1.274550e-04, 1.382840e-04, 2.503359e-04 |
| Ixy, Ixz, Iyz | -9.390388e-05, -3.854612e-08, -1.701040e-07 |
| **Inertia at CoM (kg·m²)** | |
| Ixx, Iyy, Izz | 3.608015e-05, 4.048873e-05, 6.116593e-05 |
| Ixy, Ixz, Iyz | 6.266312e-07, 4.838323e-08, -8.607661e-08 |
| Bounding box (m) | 0.0533 × 0.0435 × 0.0200 |
| Bounding box (mm) | 53.30 × 43.49 × 20.00 |
| **Material & Appearance** | |
| Material | Steel |
| Appearance | Opaque_76_76_76 |
| Color (RGB 0-1) | (0.298, 0.298, 0.298) |
| Color (RGB 0-255) | (76, 76, 76) |
| **Per-body breakdown** | |
| Body 0: Body1 | mass=237.031g, material=Steel, inertia_src=api |
| Body 1: Body2 | mass=3.041g, material=Steel, inertia_src=api |

#### 🔧 COMPONENT: `MG996R_servo`

| Property | Value |
|---|---|
| Full path | `MG996R_servo v1:9` |
| Component name | MG996R_servo v1 |
| Depth | 0 |
| Path segments | MG996R_servo |
| **Transforms** | |
| Global position (m) | (0.291741, 0.896900, 0.116699) |
| Global position (mm) | (291.74, 896.90, 116.70) |
| Local transform (m) | (0.291741, 0.896900, 0.116699) |
| Assembly context depth | 0 |
| transform2 (m) | (0.291741, 0.896900, 0.116699) |
| **Physical** | |
| Mass | 0.240073 kg (240.073 g) |
| Volume | 3.058254e-05 m³ |
| Density | 7850.0 kg/m³ |
| Surface area | 7.545639e-03 m² |
| Body count | 2 |
| CoM (component-local, m) | (0.020183, 0.019509, 0.000018) |
| CoM (global, m) | (0.311924, 0.916410, 0.116717) |
| CoM (global, mm) | (311.92, 916.41, 116.72) |
| **Inertia at origin (kg·m²)** | |
| Ixx, Iyy, Izz | 1.274550e-04, 1.382840e-04, 2.503359e-04 |
| Ixy, Ixz, Iyz | -9.390388e-05, -3.854612e-08, -1.701040e-07 |
| **Inertia at CoM (kg·m²)** | |
| Ixx, Iyy, Izz | 3.608015e-05, 4.048873e-05, 6.116593e-05 |
| Ixy, Ixz, Iyz | 6.266312e-07, 4.838323e-08, -8.607661e-08 |
| Bounding box (m) | 0.0533 × 0.0435 × 0.0200 |
| Bounding box (mm) | 53.30 × 43.49 × 20.00 |
| **Material & Appearance** | |
| Material | Steel |
| Appearance | Opaque_76_76_76 |
| Color (RGB 0-1) | (0.298, 0.298, 0.298) |
| Color (RGB 0-255) | (76, 76, 76) |
| **Per-body breakdown** | |
| Body 0: Body1 | mass=237.031g, material=Steel, inertia_src=api |
| Body 1: Body2 | mass=3.041g, material=Steel, inertia_src=api |

#### 🔧 COMPONENT: `base_link`

| Property | Value |
|---|---|
| Full path | `base_link v3:1` |
| Component name | base_link v3 |
| Depth | 0 |
| Path segments | base_link |
| **Transforms** | |
| Global position (m) | (0.000000, 0.000000, 0.000000) |
| Global position (mm) | (0.00, 0.00, 0.00) |
| Local transform (m) | (0.000000, 0.000000, 0.000000) |
| Assembly context depth | 0 |
| transform2 (m) | (0.000000, 0.000000, 0.000000) |
| **Physical** | |
| Mass | 0.461432 kg (461.432 g) |
| Volume | 5.878120e-05 m³ |
| Density | 7850.0 kg/m³ |
| Surface area | 4.620834e-02 m² |
| Body count | 1 |
| CoM (component-local, m) | (0.188950, 1.012566, 0.124814) |
| CoM (global, m) | (0.188950, 1.012566, 0.124814) |
| CoM (global, mm) | (188.95, 1012.57, 124.81) |
| **Inertia at origin (kg·m²)** | |
| Ixx, Iyy, Izz | 4.810833e-01, 2.548777e-02, 4.921769e-01 |
| Ixy, Ixz, Iyz | -8.828305e-02, -1.088082e-02, -5.831702e-02 |
| **Inertia at CoM (kg·m²)** | |
| Ixx, Iyy, Izz | 7.929840e-04, 1.825252e-03, 2.601024e-03 |
| Ixy, Ixz, Iyz | 8.295237e-08, 1.419208e-06, -2.865923e-08 |
| Bounding box (m) | 0.2195 × 0.1449 × 0.0270 |
| Bounding box (mm) | 219.50 × 144.90 × 27.00 |
| **Material & Appearance** | |
| Material | Steel |
| Appearance | Steel_Satin |
| Color (RGB 0-1) | (0.627, 0.627, 0.627) |
| Color (RGB 0-255) | (160, 160, 160) |

## Joints

#### 🔧 Joint: `Revolute_12` (regular)

| Property | Value |
|---|---|
| Defining component | MAGI_Assembly_URDF (MAGI_Assembly_URDF v1) |
| Suppressed | False |
| Motion type | revolute (enum=1) |
| Axis | (-0.0000, 0.0000, 1.0000) |
| **Connections** | |
| Parent (occ2) | `MG996R_servo` |
| Parent path | `MG996R_servo v1:4` |
| Child (occ1) | `HQpod_Coxal_Left_v2` |
| Child path | `HQpod_Coxal_Left_v2 v2:3` |
| **Geometry (all sources, raw cm)** | |
| geometryOrOriginOne | (27.5370, 108.0914, 16.1744) |
| geometryOrOriginTwo | (27.5370, 108.0914, 16.1744) |
| occ1.transform | (78.1262, 137.1194, 79.1767) ctx_depth=0 |
| occ1.global (assembled) | (78.1262, 137.1194, 79.1767) |
| occ2.transform | (28.2688, 108.8232, 12.1750) ctx_depth=0 |
| occ2.global (assembled) | (28.2688, 108.8232, 12.1750) |
| **Picked origin (m)** | (0.275370, 1.080914, 0.161744) via `geometryOrOriginOne` |
| Rotation limits (rad) | [-0.3840, 1.5708] |

#### 🔧 Joint: `Revolute_14` (regular)

| Property | Value |
|---|---|
| Defining component | MAGI_Assembly_URDF (MAGI_Assembly_URDF v1) |
| Suppressed | False |
| Motion type | revolute (enum=1) |
| Axis | (0.6965, -0.7176, -0.0000) |
| **Connections** | |
| Parent (occ2) | `MG996R_servo` |
| Parent path | `MG996R_servo v1:6` |
| Child (occ1) | `HQpod_Femur` |
| Child path | `HQpod_Femur v3:2` |
| **Geometry (all sources, raw cm)** | |
| geometryOrOriginOne | (31.8895, 110.0061, 12.7595) |
| geometryOrOriginTwo | (31.8895, 110.0061, 12.7595) |
| occ1.transform | (-8.0593, 148.8554, -60.3287) ctx_depth=0 |
| occ1.global (assembled) | (-8.0593, 148.8554, -60.3287) |
| occ2.transform | (29.1039, 112.8759, 11.7246) ctx_depth=0 |
| occ2.global (assembled) | (29.1039, 112.8759, 11.7246) |
| **Picked origin (m)** | (0.318895, 1.100061, 0.127595) via `geometryOrOriginOne` |
| Rotation limits (rad) | [-1.3963, 0.9599] |

#### 🔧 Joint: `Revolute_15` (regular)

| Property | Value |
|---|---|
| Defining component | MAGI_Assembly_URDF (MAGI_Assembly_URDF v1) |
| Suppressed | False |
| Motion type | revolute (enum=1) |
| Axis | (0.6965, -0.7176, -0.0000) |
| **Connections** | |
| Parent (occ2) | `HQpod_Femur` |
| Parent path | `HQpod_Femur v3:2` |
| Child (occ1) | `MG996R_servo` |
| Child path | `MG996R_servo v1:7` |
| **Geometry (all sources, raw cm)** | |
| geometryOrOriginOne | (35.5213, 113.5315, 9.8256) |
| geometryOrOriginTwo | (35.5213, 113.5315, 9.8256) |
| occ1.transform | (32.0926, 115.7770, 10.3431) ctx_depth=0 |
| occ1.global (assembled) | (32.0926, 115.7770, 10.3431) |
| occ2.transform | (-8.0593, 148.8554, -60.3287) ctx_depth=0 |
| occ2.global (assembled) | (-8.0593, 148.8554, -60.3287) |
| **Picked origin (m)** | (0.355213, 1.135315, 0.098256) via `geometryOrOriginOne` |
| Rotation limits (rad) | [-1.5708, 1.5708] |

#### 🔧 Joint: `Revolute_18` (regular)

| Property | Value |
|---|---|
| Defining component | MAGI_Assembly_URDF (MAGI_Assembly_URDF v1) |
| Suppressed | False |
| Motion type | revolute (enum=1) |
| Axis | (-0.0000, 0.0000, 1.0000) |
| **Connections** | |
| Parent (occ2) | `MG996R_servo` |
| Parent path | `MG996R_servo v1:8` |
| Child (occ1) | `HQpod_Coxal_Right_v2` |
| Child path | `HQpod_Coxal_Right_v2 v2:2` |
| **Geometry (all sources, raw cm)** | |
| geometryOrOriginOne | (27.5477, 94.4073, 16.1098) |
| geometryOrOriginTwo | (27.5477, 94.4073, 16.1098) |
| occ1.transform | (55.1768, 87.8564, 79.3126) ctx_depth=0 |
| occ1.global (assembled) | (55.1768, 87.8564, 79.3126) |
| occ2.transform | (28.2795, 93.6755, 12.1104) ctx_depth=0 |
| occ2.global (assembled) | (28.2795, 93.6755, 12.1104) |
| **Picked origin (m)** | (0.275477, 0.944073, 0.161098) via `geometryOrOriginOne` |
| Rotation limits (rad) | [-1.5708, 0.3840] |

#### 🔧 Joint: `Revolute_20` (regular)

| Property | Value |
|---|---|
| Defining component | MAGI_Assembly_URDF (MAGI_Assembly_URDF v1) |
| Suppressed | False |
| Motion type | revolute (enum=1) |
| Axis | (0.6925, 0.7215, -0.0000) |
| **Connections** | |
| Parent (occ2) | `MG996R_servo` |
| Parent path | `MG996R_servo v1:9` |
| Child (occ1) | `HQpod_Femur` |
| Child path | `HQpod_Femur v3:3` |
| **Geometry (all sources, raw cm)** | |
| geometryOrOriginOne | (31.9435, 92.5754, 12.7048) |
| geometryOrOriginTwo | (31.9435, 92.5754, 12.7048) |
| occ1.transform | (38.4606, 9.1160, 50.6403) ctx_depth=0 |
| occ1.global (assembled) | (38.4606, 9.1160, 50.6403) |
| occ2.transform | (29.1741, 89.6900, 11.6699) ctx_depth=0 |
| occ2.global (assembled) | (29.1741, 89.6900, 11.6699) |
| **Picked origin (m)** | (0.319435, 0.925754, 0.127048) via `geometryOrOriginOne` |
| Rotation limits (rad) | [-0.9599, 1.3963] |

#### 🔧 Joint: `Revolute_21` (regular)

| Property | Value |
|---|---|
| Defining component | MAGI_Assembly_URDF (MAGI_Assembly_URDF v1) |
| Suppressed | False |
| Motion type | revolute (enum=1) |
| Axis | (0.6925, 0.7215, -0.0000) |
| **Connections** | |
| Parent (occ2) | `HQpod_Femur` |
| Parent path | `HQpod_Femur v3:3` |
| Child (occ1) | `MG996R_servo` |
| Child path | `MG996R_servo v1:10` |
| **Geometry (all sources, raw cm)** | |
| geometryOrOriginOne | (35.6024, 89.0636, 9.7883) |
| geometryOrOriginTwo | (35.6024, 89.0636, 9.7883) |
| occ1.transform | (32.1864, 86.7988, 10.3058) ctx_depth=0 |
| occ1.global (assembled) | (32.1864, 86.7988, 10.3058) |
| occ2.transform | (38.4606, 9.1160, 50.6403) ctx_depth=0 |
| occ2.global (assembled) | (38.4606, 9.1160, 50.6403) |
| **Picked origin (m)** | (0.356024, 0.890636, 0.097883) via `geometryOrOriginOne` |
| Rotation limits (rad) | [-1.5708, 1.5708] |

#### 🔧 Joint: `Revolute_24` (regular)

| Property | Value |
|---|---|
| Defining component | MAGI_Assembly_URDF (MAGI_Assembly_URDF v1) |
| Suppressed | False |
| Motion type | revolute (enum=1) |
| Axis | (-0.0000, 0.0000, 1.0000) |
| **Connections** | |
| Parent (occ2) | `MG996R_servo` |
| Parent path | `MG996R_servo v1:13` |
| Child (occ1) | `HQpod_Coxal_Right_v2` |
| Child path | `HQpod_Coxal_Right_v2 v2:3` |
| **Geometry (all sources, raw cm)** | |
| geometryOrOriginOne | (10.0830, 108.0819, 16.1098) |
| geometryOrOriginTwo | (10.0830, 108.0819, 16.1098) |
| occ1.transform | (-17.5460, 114.6328, 79.3126) ctx_depth=0 |
| occ1.global (assembled) | (-17.5460, 114.6328, 79.3126) |
| occ2.transform | (9.3512, 108.8137, 12.1104) ctx_depth=0 |
| occ2.global (assembled) | (9.3512, 108.8137, 12.1104) |
| **Picked origin (m)** | (0.100830, 1.080819, 0.161098) via `geometryOrOriginOne` |
| Rotation limits (rad) | [-1.5708, 0.5934] |

#### 🔧 Joint: `Revolute_26` (regular)

| Property | Value |
|---|---|
| Defining component | MAGI_Assembly_URDF (MAGI_Assembly_URDF v1) |
| Suppressed | False |
| Motion type | revolute (enum=1) |
| Axis | (-0.6925, -0.7215, -0.0000) |
| **Connections** | |
| Parent (occ2) | `MG996R_servo` |
| Parent path | `MG996R_servo v1:12` |
| Child (occ1) | `HQpod_Femur` |
| Child path | `HQpod_Femur v3:4` |
| **Geometry (all sources, raw cm)** | |
| geometryOrOriginOne | (5.6861, 109.9148, 12.7013) |
| geometryOrOriginTwo | (5.6861, 109.9148, 12.7013) |
| occ1.transform | (-0.8310, 193.3742, 50.6368) ctx_depth=0 |
| occ1.global (assembled) | (-0.8310, 193.3742, 50.6368) |
| occ2.transform | (8.4555, 112.8003, 11.6664) ctx_depth=0 |
| occ2.global (assembled) | (8.4555, 112.8003, 11.6664) |
| **Picked origin (m)** | (0.056861, 1.099148, 0.127013) via `geometryOrOriginOne` |
| Rotation limits (rad) | [-0.9599, 1.3963] |

#### 🔧 Joint: `Revolute_27` (regular)

| Property | Value |
|---|---|
| Defining component | MAGI_Assembly_URDF (MAGI_Assembly_URDF v1) |
| Suppressed | False |
| Motion type | revolute (enum=1) |
| Axis | (-0.6925, -0.7215, -0.0000) |
| **Connections** | |
| Parent (occ2) | `HQpod_Femur` |
| Parent path | `HQpod_Femur v3:4` |
| Child (occ1) | `MG996R_servo` |
| Child path | `MG996R_servo v1:11` |
| **Geometry (all sources, raw cm)** | |
| geometryOrOriginOne | (2.0272, 113.4266, 9.7848) |
| geometryOrOriginTwo | (2.0272, 113.4266, 9.7848) |
| occ1.transform | (5.4432, 115.6914, 10.3023) ctx_depth=0 |
| occ1.global (assembled) | (5.4432, 115.6914, 10.3023) |
| occ2.transform | (-0.8310, 193.3742, 50.6368) ctx_depth=0 |
| occ2.global (assembled) | (-0.8310, 193.3742, 50.6368) |
| **Picked origin (m)** | (0.020272, 1.134266, 0.097848) via `geometryOrOriginOne` |
| Rotation limits (rad) | [-1.5708, 1.5708] |

#### 🔧 Joint: `Revolute_5` (regular)

| Property | Value |
|---|---|
| Defining component | MAGI_Assembly_URDF (MAGI_Assembly_URDF v1) |
| Suppressed | False |
| Motion type | revolute (enum=1) |
| Axis | (-0.0000, 0.0000, 1.0000) |
| **Connections** | |
| Parent (occ2) | `MG996R_servo` |
| Parent path | `MG996R_servo v1:1` |
| Child (occ1) | `HQpod_Coxal_Left_v2` |
| Child path | `HQpod_Coxal_Left_v2 v2:2` |
| **Geometry (all sources, raw cm)** | |
| geometryOrOriginOne | (10.1015, 94.4294, 16.1744) |
| geometryOrOriginTwo | (10.1015, 94.4294, 16.1744) |
| occ1.transform | (-40.4878, 65.4014, 79.1767) ctx_depth=0 |
| occ1.global (assembled) | (-40.4878, 65.4014, 79.1767) |
| occ2.transform | (9.3697, 93.6976, 12.1750) ctx_depth=0 |
| occ2.global (assembled) | (9.3697, 93.6976, 12.1750) |
| **Picked origin (m)** | (0.101015, 0.944294, 0.161744) via `geometryOrOriginOne` |
| Rotation limits (rad) | [-0.5934, 1.5708] |

#### 🔧 Joint: `Revolute_7` (regular)

| Property | Value |
|---|---|
| Defining component | MAGI_Assembly_URDF (MAGI_Assembly_URDF v1) |
| Suppressed | False |
| Motion type | revolute (enum=1) |
| Axis | (-0.6965, 0.7176, -0.0000) |
| **Connections** | |
| Parent (occ2) | `MG996R_servo` |
| Parent path | `MG996R_servo v1:2` |
| Child (occ1) | `HQpod_Femur` |
| Child path | `HQpod_Femur v3:1` |
| **Geometry (all sources, raw cm)** | |
| geometryOrOriginOne | (5.7161, 92.5728, 12.7693) |
| geometryOrOriginTwo | (5.7161, 92.5728, 12.7693) |
| occ1.transform | (39.7256, 47.9610, 82.9249) ctx_depth=0 |
| occ1.global (assembled) | (39.7256, 47.9610, 82.9249) |
| occ2.transform | (8.5017, 89.7030, 11.7344) ctx_depth=0 |
| occ2.global (assembled) | (8.5017, 89.7030, 11.7344) |
| **Picked origin (m)** | (0.057161, 0.925728, 0.127693) via `geometryOrOriginOne` |
| Rotation limits (rad) | [-1.3963, 0.9599] |

#### 🔧 Joint: `Revolute_8` (regular)

| Property | Value |
|---|---|
| Defining component | MAGI_Assembly_URDF (MAGI_Assembly_URDF v1) |
| Suppressed | False |
| Motion type | revolute (enum=1) |
| Axis | (-0.6965, 0.7176, -0.0000) |
| **Connections** | |
| Parent (occ2) | `HQpod_Femur` |
| Parent path | `HQpod_Femur v3:1` |
| Child (occ1) | `MG996R_servo` |
| Child path | `MG996R_servo v1:3` |
| **Geometry (all sources, raw cm)** | |
| geometryOrOriginOne | (2.0842, 89.0475, 9.8354) |
| geometryOrOriginTwo | (2.0842, 89.0475, 9.8354) |
| occ1.transform | (5.5129, 86.8019, 10.3529) ctx_depth=0 |
| occ1.global (assembled) | (5.5129, 86.8019, 10.3529) |
| occ2.transform | (39.7256, 47.9610, 82.9249) ctx_depth=0 |
| occ2.global (assembled) | (39.7256, 47.9610, 82.9249) |
| **Picked origin (m)** | (0.020842, 0.890475, 0.098354) via `geometryOrOriginOne` |
| Rotation limits (rad) | [-1.5708, 1.5708] |

#### 🔧 Joint: `Rigid_1` (regular)

| Property | Value |
|---|---|
| Defining component | MAGI_Assembly_URDF (MAGI_Assembly_URDF v1) |
| Suppressed | False |
| Motion type | rigid (enum=0) |
| Axis | (0.0000, 0.0000, 1.0000) |
| **Connections** | |
| Parent (occ2) | `base_link` |
| Parent path | `base_link v3:1` |
| Child (occ1) | `HexapodV3Mid` |
| Child path | `HexapodV3Mid v5:1` |
| **Geometry (all sources, raw cm)** | |
| geometryOrOriginOne | (9.7026, 105.3896, 14.8500) |
| geometryOrOriginTwo | (9.7026, 105.3896, 14.8500) |
| occ1.transform | (11.3207, 135.1156, -24.2000) ctx_depth=0 |
| occ1.global (assembled) | (11.3207, 135.1156, -24.2000) |
| occ2.transform | (0.0000, 0.0000, 0.0000) ctx_depth=0 |
| occ2.global (assembled) | (0.0000, 0.0000, 0.0000) |
| **Picked origin (m)** | (0.097026, 1.053896, 0.148500) via `geometryOrOriginOne` |

#### 🔧 Joint: `Rigid_10` (regular)

| Property | Value |
|---|---|
| Defining component | MAGI_Assembly_URDF (MAGI_Assembly_URDF v1) |
| Suppressed | False |
| Motion type | rigid (enum=0) |
| Axis | (0.0000, 0.0000, 1.0000) |
| **Connections** | |
| Parent (occ2) | `HexapodV3Top` |
| Parent path | `HexapodV3Top v3:1` |
| Child (occ1) | `MG996R_servo` |
| Child path | `MG996R_servo v1:4` |
| **Geometry (all sources, raw cm)** | |
| geometryOrOriginOne | (24.7686, 106.0302, 15.1498) |
| geometryOrOriginTwo | (24.7686, 106.0302, 15.1498) |
| occ1.transform | (28.2688, 108.8232, 12.1750) ctx_depth=0 |
| occ1.global (assembled) | (28.2688, 108.8232, 12.1750) |
| occ2.transform | (3.8772, -150.0410, -8.9852) ctx_depth=0 |
| occ2.global (assembled) | (3.8772, -150.0410, -8.9852) |
| **Picked origin (m)** | (0.247686, 1.060302, 0.151498) via `geometryOrOriginOne` |

#### 🔧 Joint: `Rigid_11` (regular)

| Property | Value |
|---|---|
| Defining component | MAGI_Assembly_URDF (MAGI_Assembly_URDF v1) |
| Suppressed | False |
| Motion type | rigid (enum=0) |
| Axis | (0.0000, 0.0000, 1.0000) |
| **Connections** | |
| Parent (occ2) | `MG996R_servo` |
| Parent path | `MG996R_servo v1:4` |
| Child (occ1) | `HQpod_Coxal_Right_v2` |
| Child path | `HQpod_Coxal_Right_v2 v2:1` |
| **Geometry (all sources, raw cm)** | |
| geometryOrOriginOne | (27.5370, 108.0914, 16.1744) |
| geometryOrOriginTwo | (27.5370, 108.0914, 16.1744) |
| occ1.transform | (45.1506, 130.3633, 79.3772) ctx_depth=0 |
| occ1.global (assembled) | (45.1506, 130.3633, 79.3772) |
| occ2.transform | (28.2688, 108.8232, 12.1750) ctx_depth=0 |
| occ2.global (assembled) | (28.2688, 108.8232, 12.1750) |
| **Picked origin (m)** | (0.275370, 1.080914, 0.161744) via `geometryOrOriginOne` |

#### 🔧 Joint: `Rigid_13` (regular)

| Property | Value |
|---|---|
| Defining component | MAGI_Assembly_URDF (MAGI_Assembly_URDF v1) |
| Suppressed | False |
| Motion type | rigid (enum=0) |
| Axis | (0.0000, 0.0000, 1.0000) |
| **Connections** | |
| Parent (occ2) | `HQpod_Coxal_Left_v2` |
| Parent path | `HQpod_Coxal_Left_v2 v2:3` |
| Child (occ1) | `MG996R_servo` |
| Child path | `MG996R_servo v1:6` |
| **Geometry (all sources, raw cm)** | |
| geometryOrOriginOne | (31.5796, 111.0432, 11.3445) |
| geometryOrOriginTwo | (31.5796, 111.0432, 11.3445) |
| occ1.transform | (29.1039, 112.8759, 11.7246) ctx_depth=0 |
| occ1.global (assembled) | (29.1039, 112.8759, 11.7246) |
| occ2.transform | (78.1262, 137.1194, 79.1767) ctx_depth=0 |
| occ2.global (assembled) | (78.1262, 137.1194, 79.1767) |
| **Picked origin (m)** | (0.315796, 1.110432, 0.113445) via `geometryOrOriginOne` |

#### 🔧 Joint: `Rigid_16` (regular)

| Property | Value |
|---|---|
| Defining component | MAGI_Assembly_URDF (MAGI_Assembly_URDF v1) |
| Suppressed | False |
| Motion type | rigid (enum=0) |
| Axis | (0.0000, 0.0000, 1.0000) |
| **Connections** | |
| Parent (occ2) | `MG996R_servo` |
| Parent path | `MG996R_servo v1:7` |
| Child (occ1) | `HQpod_Tibia_Left` |
| Child path | `HQpod_Tibia_Left v3:2` |
| **Geometry (all sources, raw cm)** | |
| geometryOrOriginOne | (36.7504, 116.1524, 7.6851) |
| geometryOrOriginTwo | (36.7504, 116.1524, 7.6851) |
| occ1.transform | (29.7362, 106.1010, 67.3593) ctx_depth=0 |
| occ1.global (assembled) | (29.7362, 106.1010, 67.3593) |
| occ2.transform | (32.0926, 115.7770, 10.3431) ctx_depth=0 |
| occ2.global (assembled) | (32.0926, 115.7770, 10.3431) |
| **Picked origin (m)** | (0.367504, 1.161524, 0.076851) via `geometryOrOriginOne` |

#### 🔧 Joint: `Rigid_17` (regular)

| Property | Value |
|---|---|
| Defining component | MAGI_Assembly_URDF (MAGI_Assembly_URDF v1) |
| Suppressed | False |
| Motion type | rigid (enum=0) |
| Axis | (0.0000, 0.0000, 1.0000) |
| **Connections** | |
| Parent (occ2) | `HexapodV3Top` |
| Parent path | `HexapodV3Top v3:1` |
| Child (occ1) | `MG996R_servo` |
| Child path | `MG996R_servo v1:8` |
| **Geometry (all sources, raw cm)** | |
| geometryOrOriginOne | (28.9019, 93.7603, 15.1498) |
| geometryOrOriginTwo | (28.9019, 93.7603, 15.1498) |
| occ1.transform | (28.2795, 93.6755, 12.1104) ctx_depth=0 |
| occ1.global (assembled) | (28.2795, 93.6755, 12.1104) |
| occ2.transform | (3.8772, -150.0410, -8.9852) ctx_depth=0 |
| occ2.global (assembled) | (3.8772, -150.0410, -8.9852) |
| **Picked origin (m)** | (0.289019, 0.937603, 0.151498) via `geometryOrOriginOne` |

#### 🔧 Joint: `Rigid_19` (regular)

| Property | Value |
|---|---|
| Defining component | MAGI_Assembly_URDF (MAGI_Assembly_URDF v1) |
| Suppressed | False |
| Motion type | rigid (enum=0) |
| Axis | (0.0000, 0.0000, 1.0000) |
| **Connections** | |
| Parent (occ2) | `HQpod_Coxal_Right_v2` |
| Parent path | `HQpod_Coxal_Right_v2 v2:2` |
| Child (occ1) | `MG996R_servo` |
| Child path | `MG996R_servo v1:9` |
| **Geometry (all sources, raw cm)** | |
| geometryOrOriginOne | (31.5948, 91.4900, 16.1198) |
| geometryOrOriginTwo | (31.5948, 91.4900, 16.1198) |
| occ1.transform | (29.1741, 89.6900, 11.6699) ctx_depth=0 |
| occ1.global (assembled) | (29.1741, 89.6900, 11.6699) |
| occ2.transform | (55.1768, 87.8564, 79.3126) ctx_depth=0 |
| occ2.global (assembled) | (55.1768, 87.8564, 79.3126) |
| **Picked origin (m)** | (0.315948, 0.914900, 0.161198) via `geometryOrOriginOne` |

#### 🔧 Joint: `Rigid_2` (regular)

| Property | Value |
|---|---|
| Defining component | MAGI_Assembly_URDF (MAGI_Assembly_URDF v1) |
| Suppressed | False |
| Motion type | rigid (enum=0) |
| Axis | (0.0000, 0.0000, 1.0000) |
| **Connections** | |
| Parent (occ2) | `HexapodV3Mid` |
| Parent path | `HexapodV3Mid v5:1` |
| Child (occ1) | `HexapodV3Top` |
| Child path | `HexapodV3Top v3:1` |
| **Geometry (all sources, raw cm)** | |
| geometryOrOriginOne | (9.7026, 97.1290, 15.1498) |
| geometryOrOriginTwo | (9.7026, 97.1290, 15.1498) |
| occ1.transform | (3.8772, -150.0410, -8.9852) ctx_depth=0 |
| occ1.global (assembled) | (3.8772, -150.0410, -8.9852) |
| occ2.transform | (11.3207, 135.1156, -24.2000) ctx_depth=0 |
| occ2.global (assembled) | (11.3207, 135.1156, -24.2000) |
| **Picked origin (m)** | (0.097026, 0.971290, 0.151498) via `geometryOrOriginOne` |

#### 🔧 Joint: `Rigid_22` (regular)

| Property | Value |
|---|---|
| Defining component | MAGI_Assembly_URDF (MAGI_Assembly_URDF v1) |
| Suppressed | False |
| Motion type | rigid (enum=0) |
| Axis | (0.0000, 0.0000, 1.0000) |
| **Connections** | |
| Parent (occ2) | `MG996R_servo` |
| Parent path | `MG996R_servo v1:10` |
| Child (occ1) | `HQpod_Tibia_Right` |
| Child path | `HQpod_Tibia_Right v4:1` |
| **Geometry (all sources, raw cm)** | |
| geometryOrOriginOne | (37.2070, 86.1034, 8.5138) |
| geometryOrOriginTwo | (37.2070, 86.1034, 8.5138) |
| occ1.transform | (68.1661, 75.2503, 90.9144) ctx_depth=0 |
| occ1.global (assembled) | (68.1661, 75.2503, 90.9144) |
| occ2.transform | (32.1864, 86.7988, 10.3058) ctx_depth=0 |
| occ2.global (assembled) | (32.1864, 86.7988, 10.3058) |
| **Picked origin (m)** | (0.372070, 0.861034, 0.085138) via `geometryOrOriginOne` |

#### 🔧 Joint: `Rigid_25` (regular)

| Property | Value |
|---|---|
| Defining component | MAGI_Assembly_URDF (MAGI_Assembly_URDF v1) |
| Suppressed | False |
| Motion type | rigid (enum=0) |
| Axis | (0.0000, 0.0000, 1.0000) |
| **Connections** | |
| Parent (occ2) | `HQpod_Coxal_Right_v2` |
| Parent path | `HQpod_Coxal_Right_v2 v2:3` |
| Child (occ1) | `MG996R_servo` |
| Child path | `MG996R_servo v1:12` |
| **Geometry (all sources, raw cm)** | |
| geometryOrOriginOne | (6.7563, 110.3078, 16.1163) |
| geometryOrOriginTwo | (6.7563, 110.3078, 16.1163) |
| occ1.transform | (8.4555, 112.8003, 11.6664) ctx_depth=0 |
| occ1.global (assembled) | (8.4555, 112.8003, 11.6664) |
| occ2.transform | (-17.5460, 114.6328, 79.3126) ctx_depth=0 |
| occ2.global (assembled) | (-17.5460, 114.6328, 79.3126) |
| **Picked origin (m)** | (0.067563, 1.103078, 0.161163) via `geometryOrOriginOne` |

#### 🔧 Joint: `Rigid_29` (regular)

| Property | Value |
|---|---|
| Defining component | MAGI_Assembly_URDF (MAGI_Assembly_URDF v1) |
| Suppressed | False |
| Motion type | rigid (enum=0) |
| Axis | (0.0000, 0.0000, 1.0000) |
| **Connections** | |
| Parent (occ2) | `HexapodV3Top` |
| Parent path | `HexapodV3Top v3:1` |
| Child (occ1) | `MG996R_servo` |
| Child path | `MG996R_servo v1:13` |
| **Geometry (all sources, raw cm)** | |
| geometryOrOriginOne | (9.4360, 109.4360, 15.1498) |
| geometryOrOriginTwo | (9.4360, 109.4360, 15.1498) |
| occ1.transform | (9.3512, 108.8137, 12.1104) ctx_depth=0 |
| occ1.global (assembled) | (9.3512, 108.8137, 12.1104) |
| occ2.transform | (3.8772, -150.0410, -8.9852) ctx_depth=0 |
| occ2.global (assembled) | (3.8772, -150.0410, -8.9852) |
| **Picked origin (m)** | (0.094360, 1.094360, 0.151498) via `geometryOrOriginOne` |

#### 🔧 Joint: `Rigid_30` (regular)

| Property | Value |
|---|---|
| Defining component | MAGI_Assembly_URDF (MAGI_Assembly_URDF v1) |
| Suppressed | False |
| Motion type | rigid (enum=0) |
| Axis | (0.0000, 0.0000, 1.0000) |
| **Connections** | |
| Parent (occ2) | `MG996R_servo` |
| Parent path | `MG996R_servo v1:11` |
| Child (occ1) | `HQpod_Tibia_Right` |
| Child path | `HQpod_Tibia_Right v4:2` |
| **Geometry (all sources, raw cm)** | |
| geometryOrOriginOne | (0.4851, 116.3269, 8.5603) |
| geometryOrOriginTwo | (0.4226, 116.3869, 8.5103) |
| occ1.transform | (-30.5643, 127.2667, 90.8881) ctx_depth=0 |
| occ1.global (assembled) | (-30.5643, 127.2667, 90.8881) |
| occ2.transform | (5.4432, 115.6914, 10.3023) ctx_depth=0 |
| occ2.global (assembled) | (5.4432, 115.6914, 10.3023) |
| **Picked origin (m)** | (0.004851, 1.163269, 0.085603) via `geometryOrOriginOne` |

#### 🔧 Joint: `Rigid_4` (regular)

| Property | Value |
|---|---|
| Defining component | MAGI_Assembly_URDF (MAGI_Assembly_URDF v1) |
| Suppressed | False |
| Motion type | rigid (enum=0) |
| Axis | (0.0000, 0.0000, 1.0000) |
| **Connections** | |
| Parent (occ2) | `HexapodV3Top` |
| Parent path | `HexapodV3Top v3:1` |
| Child (occ1) | `MG996R_servo` |
| Child path | `MG996R_servo v1:1` |
| **Geometry (all sources, raw cm)** | |
| geometryOrOriginOne | (12.8698, 96.4906, 15.1498) |
| geometryOrOriginTwo | (12.8698, 96.4906, 15.1498) |
| occ1.transform | (9.3697, 93.6976, 12.1750) ctx_depth=0 |
| occ1.global (assembled) | (9.3697, 93.6976, 12.1750) |
| occ2.transform | (3.8772, -150.0410, -8.9852) ctx_depth=0 |
| occ2.global (assembled) | (3.8772, -150.0410, -8.9852) |
| **Picked origin (m)** | (0.128698, 0.964906, 0.151498) via `geometryOrOriginOne` |

#### 🔧 Joint: `Rigid_6` (regular)

| Property | Value |
|---|---|
| Defining component | MAGI_Assembly_URDF (MAGI_Assembly_URDF v1) |
| Suppressed | False |
| Motion type | rigid (enum=0) |
| Axis | (0.0000, 0.0000, 1.0000) |
| **Connections** | |
| Parent (occ2) | `HQpod_Coxal_Left_v2` |
| Parent path | `HQpod_Coxal_Left_v2 v2:2` |
| Child (occ1) | `MG996R_servo` |
| Child path | `MG996R_servo v1:2` |
| **Geometry (all sources, raw cm)** | |
| geometryOrOriginOne | (6.0709, 91.4894, 16.1843) |
| geometryOrOriginTwo | (6.0709, 91.4894, 16.1843) |
| occ1.transform | (8.5017, 89.7030, 11.7344) ctx_depth=0 |
| occ1.global (assembled) | (8.5017, 89.7030, 11.7344) |
| occ2.transform | (-40.4878, 65.4014, 79.1767) ctx_depth=0 |
| occ2.global (assembled) | (-40.4878, 65.4014, 79.1767) |
| **Picked origin (m)** | (0.060709, 0.914894, 0.161843) via `geometryOrOriginOne` |

#### 🔧 Joint: `Rigid_9` (regular)

| Property | Value |
|---|---|
| Defining component | MAGI_Assembly_URDF (MAGI_Assembly_URDF v1) |
| Suppressed | False |
| Motion type | rigid (enum=0) |
| Axis | (0.0000, 0.0000, 1.0000) |
| **Connections** | |
| Parent (occ2) | `MG996R_servo` |
| Parent path | `MG996R_servo v1:3` |
| Child (occ1) | `HQpod_Tibia_Left` |
| Child path | `HQpod_Tibia_Left v3:1` |
| **Geometry (all sources, raw cm)** | |
| geometryOrOriginOne | (0.8551, 86.4265, 7.6949) |
| geometryOrOriginTwo | (0.8551, 86.4265, 7.6949) |
| occ1.transform | (7.8693, 96.4779, 67.3691) ctx_depth=0 |
| occ1.global (assembled) | (7.8693, 96.4779, 67.3691) |
| occ2.transform | (5.5129, 86.8019, 10.3529) ctx_depth=0 |
| occ2.global (assembled) | (5.5129, 86.8019, 10.3529) |
| **Picked origin (m)** | (0.008551, 0.864265, 0.076949) via `geometryOrOriginOne` |

## Quick Comparison Table

Compare these values with Fusion 360 Properties panel (right-click → Properties).

| Component | Mass (g) | World X,Y,Z (mm) | CoM X,Y,Z (mm) | Material |
|---|---|---|---|---|
| HQpod_Coxal_Left_v2 | 265.679 | (-404.88, 654.01, 791.77) | (249.64, 1184.50, 935.03) | Steel |
| HQpod_Coxal_Left_v2 | 265.679 | (781.26, 1371.19, 791.77) | (1435.78, 1901.68, 935.03) | Steel |
| HQpod_Coxal_Right_v2 | 265.916 | (451.51, 1303.63, 793.77) | (1107.99, 1093.64, 937.03) | Steel |
| HQpod_Coxal_Right_v2 | 265.916 | (551.77, 878.56, 793.13) | (1208.25, 668.57, 936.38) | Steel |
| HQpod_Coxal_Right_v2 | 265.916 | (-175.46, 1146.33, 793.13) | (481.02, 936.33, 936.38) | Steel |
| HQpod_Femur | 175.899 | (397.26, 479.61, 829.25) | (74.92, 1120.51, 1360.43) | Steel |
| HQpod_Femur | 175.899 | (-80.59, 1488.55, -603.29) | (-402.93, 2129.45, -72.11) | Steel |
| HQpod_Femur | 175.899 | (384.61, 91.16, 506.40) | (62.27, 732.06, 1037.58) | Steel |
| HQpod_Femur | 175.899 | (-8.31, 1933.74, 506.37) | (-330.64, 2574.64, 1037.55) | Steel |
| HQpod_Tibia_Left | 0.000 | (78.69, 964.78, 673.69) | (78.69, 964.78, 673.69) | Steel |
| HQpod_Tibia_Left | 0.000 | (297.36, 1061.01, 673.59) | (297.36, 1061.01, 673.59) | Steel |
| HQpod_Tibia_Right | 0.000 | (681.66, 752.50, 909.14) | (681.66, 752.50, 909.14) | Steel |
| HQpod_Tibia_Right | 0.000 | (-305.64, 1272.67, 908.88) | (-305.64, 1272.67, 908.88) | Steel |
| HexapodV3Mid | 430.715 | (113.21, 1351.16, -242.00) | (170.14, 1012.50, 150.83) | Steel |
| HexapodV3Top | 1329.055 | (38.77, -1500.41, -89.85) | (187.35, 1012.59, 148.11) | Steel |
| MG996R_servo | 240.073 | (93.70, 936.98, 121.75) | (113.88, 956.49, 121.77) | Steel |
| MG996R_servo | 240.073 | (321.86, 867.99, 103.06) | (342.05, 887.50, 103.08) | Steel |
| MG996R_servo | 240.073 | (54.43, 1156.91, 103.02) | (74.62, 1176.42, 103.04) | Steel |
| MG996R_servo | 240.073 | (84.55, 1128.00, 116.66) | (104.74, 1147.51, 116.68) | Steel |
| MG996R_servo | 240.073 | (93.51, 1088.14, 121.10) | (113.69, 1107.65, 121.12) | Steel |
| MG996R_servo | 240.073 | (85.02, 897.03, 117.34) | (105.20, 916.54, 117.36) | Steel |
| MG996R_servo | 240.073 | (55.13, 868.02, 103.53) | (75.31, 887.53, 103.55) | Steel |
| MG996R_servo | 240.073 | (282.69, 1088.23, 121.75) | (302.87, 1107.74, 121.77) | Steel |
| MG996R_servo | 240.073 | (291.04, 1128.76, 117.25) | (311.22, 1148.27, 117.26) | Steel |
| MG996R_servo | 240.073 | (320.93, 1157.77, 103.43) | (341.11, 1177.28, 103.45) | Steel |
| MG996R_servo | 240.073 | (282.80, 936.76, 121.10) | (302.98, 956.26, 121.12) | Steel |
| MG996R_servo | 240.073 | (291.74, 896.90, 116.70) | (311.92, 916.41, 116.72) | Steel |
| base_link | 461.432 | (0.00, 0.00, 0.00) | (188.95, 1012.57, 124.81) | Steel |

## Joint Origins Comparison

All origins shown in multiple coordinate systems for debugging.

| Joint | Source | Origin (cm, raw) | Origin (m, picked) | Motion | Axis |
|---|---|---|---|---|---|
| Revolute_12 | geometryOrOriginOne | goo1(27.54, 108.09, 16.17) | (0.2754, 1.0809, 0.1617) | revolute | (-0.0, 0.0, 1.0) |
| Revolute_14 | geometryOrOriginOne | goo1(31.89, 110.01, 12.76) | (0.3189, 1.1001, 0.1276) | revolute | (0.7, -0.7, -0.0) |
| Revolute_15 | geometryOrOriginOne | goo1(35.52, 113.53, 9.83) | (0.3552, 1.1353, 0.0983) | revolute | (0.7, -0.7, -0.0) |
| Revolute_18 | geometryOrOriginOne | goo1(27.55, 94.41, 16.11) | (0.2755, 0.9441, 0.1611) | revolute | (-0.0, 0.0, 1.0) |
| Revolute_20 | geometryOrOriginOne | goo1(31.94, 92.58, 12.70) | (0.3194, 0.9258, 0.1270) | revolute | (0.7, 0.7, -0.0) |
| Revolute_21 | geometryOrOriginOne | goo1(35.60, 89.06, 9.79) | (0.3560, 0.8906, 0.0979) | revolute | (0.7, 0.7, -0.0) |
| Revolute_24 | geometryOrOriginOne | goo1(10.08, 108.08, 16.11) | (0.1008, 1.0808, 0.1611) | revolute | (-0.0, 0.0, 1.0) |
| Revolute_26 | geometryOrOriginOne | goo1(5.69, 109.91, 12.70) | (0.0569, 1.0991, 0.1270) | revolute | (-0.7, -0.7, -0.0) |
| Revolute_27 | geometryOrOriginOne | goo1(2.03, 113.43, 9.78) | (0.0203, 1.1343, 0.0978) | revolute | (-0.7, -0.7, -0.0) |
| Revolute_5 | geometryOrOriginOne | goo1(10.10, 94.43, 16.17) | (0.1010, 0.9443, 0.1617) | revolute | (-0.0, 0.0, 1.0) |
| Revolute_7 | geometryOrOriginOne | goo1(5.72, 92.57, 12.77) | (0.0572, 0.9257, 0.1277) | revolute | (-0.7, 0.7, -0.0) |
| Revolute_8 | geometryOrOriginOne | goo1(2.08, 89.05, 9.84) | (0.0208, 0.8905, 0.0984) | revolute | (-0.7, 0.7, -0.0) |
| Rigid_1 | geometryOrOriginOne | goo1(9.70, 105.39, 14.85) | (0.0970, 1.0539, 0.1485) | rigid | (0.0, 0.0, 1.0) |
| Rigid_10 | geometryOrOriginOne | goo1(24.77, 106.03, 15.15) | (0.2477, 1.0603, 0.1515) | rigid | (0.0, 0.0, 1.0) |
| Rigid_11 | geometryOrOriginOne | goo1(27.54, 108.09, 16.17) | (0.2754, 1.0809, 0.1617) | rigid | (0.0, 0.0, 1.0) |
| Rigid_13 | geometryOrOriginOne | goo1(31.58, 111.04, 11.34) | (0.3158, 1.1104, 0.1134) | rigid | (0.0, 0.0, 1.0) |
| Rigid_16 | geometryOrOriginOne | goo1(36.75, 116.15, 7.69) | (0.3675, 1.1615, 0.0769) | rigid | (0.0, 0.0, 1.0) |
| Rigid_17 | geometryOrOriginOne | goo1(28.90, 93.76, 15.15) | (0.2890, 0.9376, 0.1515) | rigid | (0.0, 0.0, 1.0) |
| Rigid_19 | geometryOrOriginOne | goo1(31.59, 91.49, 16.12) | (0.3159, 0.9149, 0.1612) | rigid | (0.0, 0.0, 1.0) |
| Rigid_2 | geometryOrOriginOne | goo1(9.70, 97.13, 15.15) | (0.0970, 0.9713, 0.1515) | rigid | (0.0, 0.0, 1.0) |
| Rigid_22 | geometryOrOriginOne | goo1(37.21, 86.10, 8.51) | (0.3721, 0.8610, 0.0851) | rigid | (0.0, 0.0, 1.0) |
| Rigid_25 | geometryOrOriginOne | goo1(6.76, 110.31, 16.12) | (0.0676, 1.1031, 0.1612) | rigid | (0.0, 0.0, 1.0) |
| Rigid_29 | geometryOrOriginOne | goo1(9.44, 109.44, 15.15) | (0.0944, 1.0944, 0.1515) | rigid | (0.0, 0.0, 1.0) |
| Rigid_30 | geometryOrOriginOne | goo1(0.49, 116.33, 8.56) | (0.0049, 1.1633, 0.0856) | rigid | (0.0, 0.0, 1.0) |
| Rigid_4 | geometryOrOriginOne | goo1(12.87, 96.49, 15.15) | (0.1287, 0.9649, 0.1515) | rigid | (0.0, 0.0, 1.0) |
| Rigid_6 | geometryOrOriginOne | goo1(6.07, 91.49, 16.18) | (0.0607, 0.9149, 0.1618) | rigid | (0.0, 0.0, 1.0) |
| Rigid_9 | geometryOrOriginOne | goo1(0.86, 86.43, 7.69) | (0.0086, 0.8643, 0.0769) | rigid | (0.0, 0.0, 1.0) |
