paraspective/MAGI-v2/archive/references/Regis/Hardware/Battery Analysis.xlsx

 |  | Battery Analysis Spreadsheet
 | Current Battery |  | Batt # 1
Technology | Lithium-ion |  | LiFePO4
 | DC 12300 - DC12V Rechargeable 3000mAh lithium-ion Battery |  | NERMAK 12V 10Ah Lithium LiFePO4 Deep Cycle Battery, Built-in 10A BMS
Ah | 0.3 |  | 10
L | 3.465 |  | 5.94
W | 2.244 |  | 2.56
H | 0.827 |  | 3.7
Volume (in³) | 6.43030542 |  | 56.26368
Weight (g) | 200 |  | 1197.5
Weight(lbs) | 0.441 |  | 2.64
Peak Discharge | 2 |  | 20
Charge Density (Amps per Volume) | 0.04665408257 |  | 0.1777345527
Ah/kg | 1.5 |  | 8.350730689
Cost | $25.99 |  | $44.99
$$$/Ah | $86.63 |  | $4.50
