paraspective/MAGI-v2/archive/references/Regis/Hardware/Servo Motor & Controller/Robot Servo Analysis.xlsx

 | Servo Motor Comparison Chart
 |  |  |  |  |  |  |  |  |  |  |  | Stall Tq in Lbs / Arm Length (90°) |  | How much can we lift?
Servo Name | Model | Rotation | Weight (grams) | Idle Amps | Stall Torque (Min) | Stall Torque (Max) | Max Stall Tq in lbs | Volts | Stall Amps (Min) | Stall Amps (Max) |  |  | 2 cm | 3cm | 4cm | 5cm | 6cm | 7cm | 8cm | 9cm | 10cm
"9g servo" | MG90S | 180 | 13.4 | 0.01 | 1.8 | 2.2 | 4.850164 | 4.8 - 6.0 | 0.4 | 1 |  | 4.85 | 2.43 | 1.62 | 0.20 | 0.97 | 0.81 | 0.69 | 0.61 | 0.54 | 0.49
"Tower Pro 12kg" | MG996R | 180 | 55 | 0.02 | 9.4 | 11 | 24.25082 | 4.8 - 6.0 | 1.3 | 1.5 |  | 24.25 | 12.13 | 8.08 | 6.06 | 4.85 | 4.04 | 3.46 | 3.03 | 2.69 | 2.43
"Sun Founder 20kg" | SF3218MG | 270 | 56 | 0.05 | 20.5 | 22.8 | 50.265336 | 4.8 -7.2 | 1.5 | 2.7 |  | 50.27 | 25.13 | 16.76 | 12.57 | 10.05 | 8.38 | 7.18 | 6.28 | 5.59 | 5.03
"35kg" | DS3235 | 180 or 270 | 60 | 0.005 | 29 | 35 | 77.1617 | 5.0 -7.4 | 1.9 | 2.3 |  | 77.16 | 38.58 | 25.72 | 19.29 | 15.43 | 12.86 | 11.02 | 9.65 | 8.57 | 7.72
 | Power Consumption Of Servo Motors Graphs |  |  |  |  |  | Strength to Weight of Servo Motors Graph
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
