paraspective/MAGI-v2/hardware/urdf/MAGI_Assembly_URDF_description/config/frame_overrides.csv

link | parent_joint | joint_type | rule | original_roll_deg | original_pitch_deg | original_yaw_deg | post_roll_deg | post_pitch_deg | post_yaw_deg | role
HexapodV3Mid | Rigid_1 | fixed | keep | 0.000000 | 0.000000 | 0.000000 | 0.000000 | 0.000000 | 0.000000 | unchanged
HexapodV3Top | Rigid_2 | fixed | keep | 0.000000 | 0.000000 | 0.000000 | 0.000000 | 0.000000 | 0.000000 | unchanged
MAGI_Assembly_URDF_HQpod_Coxal_Left_v2 | Revolute_5 | revolute | auto | 30.853048 | 89.999234 | -15.000008 | 0.000000 | 0.000000 | 0.000000 | revolute_axis_z
MAGI_Assembly_URDF_HQpod_Coxal_Left_v2_2 | Revolute_12 | revolute | auto | 30.853063 | 89.999234 | 165.000008 | 0.000000 | 0.000000 | 0.000000 | revolute_axis_z
MAGI_Assembly_URDF_HQpod_Coxal_Right_v2 | Revolute_24 | revolute | auto | -66.175218 | 89.999790 | -20.000028 | 0.000000 | 0.000000 | 0.000000 | revolute_axis_z
MAGI_Assembly_URDF_HQpod_Coxal_Right_v2_2 | Revolute_31 | revolute | auto | -66.175163 | 89.999790 | 160.000026 | 0.000000 | 0.000000 | 0.000000 | revolute_axis_z
MAGI_Assembly_URDF_HQpod_Femur | Revolute_7 | revolute | auto | -90.000816 | -30.000393 | 44.147355 | -90.000707 | 0.000686 | 44.146947 | revolute_axis_z
MAGI_Assembly_URDF_HQpod_Femur_2 | Revolute_14 | revolute | auto | 90.000816 | 30.000393 | 44.147355 | 90.000707 | -0.000686 | 44.146947 | revolute_axis_z
MAGI_Assembly_URDF_HQpod_Femur_3 | Revolute_26 | revolute | auto | -90.000134 | 30.000192 | 136.175173 | 90.000116 | 0.000112 | -43.824759 | revolute_axis_z
MAGI_Assembly_URDF_HQpod_Femur_4 | Revolute_32 | revolute | auto | -90.000134 | 30.000192 | -43.824827 | -90.000116 | -0.000112 | -43.824759 | revolute_axis_z
MAGI_Assembly_URDF_HQpod_Tibia_Left | Rigid_9 | fixed | keep | 89.998586 | 59.999607 | 44.145722 | 89.998586 | 59.999607 | 44.145722 | unchanged
MAGI_Assembly_URDF_HQpod_Tibia_Left_2 | Rigid_16 | fixed | keep | 89.998586 | 59.999607 | -135.854278 | 89.998586 | 59.999607 | -135.854278 | unchanged
MAGI_Assembly_URDF_HQpod_Tibia_Right | Rigid_30 | fixed | keep | 89.999702 | -59.999808 | 136.175749 | 89.999702 | -59.999808 | 136.175749 | unchanged
MAGI_Assembly_URDF_HQpod_Tibia_Right_2 | Rigid_34 | fixed | keep | 89.999702 | -59.999808 | -43.824251 | 89.999702 | -59.999808 | -43.824251 | unchanged
MAGI_Assembly_URDF_MG996R_servo | Rigid_4 | fixed | keep | 90.000000 | 0.000000 | 45.000000 | 90.000000 | 0.000000 | 45.000000 | unchanged
MAGI_Assembly_URDF_MG996R_servo_10 | Rigid_13 | fixed | keep | -119.046957 | -89.999191 | -16.806096 | -119.046957 | -89.999191 | -16.806096 | unchanged
MAGI_Assembly_URDF_MG996R_servo_11 | Revolute_15 | revolute | auto | -179.999184 | 30.000393 | 44.147355 | 90.000707 | -0.000686 | 44.146947 | revolute_axis_z
MAGI_Assembly_URDF_MG996R_servo_12 | Rigid_17 | fixed | keep | 90.000000 | 0.000000 | 135.000000 | 90.000000 | 0.000000 | 135.000000 | unchanged
MAGI_Assembly_URDF_MG996R_servo_2 | Revolute_27 | revolute | auto | -0.000134 | 30.000192 | 136.175173 | 90.000116 | 0.000112 | -43.824759 | revolute_axis_z
MAGI_Assembly_URDF_MG996R_servo_3 | Rigid_25 | fixed | keep | -31.248481 | -89.999776 | 167.423721 | -31.248481 | -89.999776 | 167.423721 | unchanged
MAGI_Assembly_URDF_MG996R_servo_4 | Rigid_29 | fixed | keep | 90.000000 | 0.000000 | -45.000000 | 90.000000 | 0.000000 | -45.000000 | unchanged
MAGI_Assembly_URDF_MG996R_servo_5 | Rigid_35 | fixed | keep | -31.248534 | -89.999776 | -12.576226 | -31.248534 | -89.999776 | -12.576226 | unchanged
MAGI_Assembly_URDF_MG996R_servo_6 | Revolute_33 | revolute | auto | -0.000134 | 30.000192 | -43.824827 | -90.000116 | -0.000112 | -43.824759 | revolute_axis_z
MAGI_Assembly_URDF_MG996R_servo_7 | Rigid_6 | fixed | keep | -119.046942 | -89.999191 | 163.193889 | -119.046942 | -89.999191 | 163.193889 | unchanged
MAGI_Assembly_URDF_MG996R_servo_8 | Revolute_8 | revolute | auto | -179.999184 | 30.000393 | -135.852645 | -90.000707 | 0.000686 | 44.146947 | revolute_axis_z
MAGI_Assembly_URDF_MG996R_servo_9 | Rigid_10 | fixed | keep | 90.000000 | 0.000000 | -135.000000 | 90.000000 | 0.000000 | -135.000000 | unchanged
base_link |  | root | auto | 0.000000 | 0.000000 | 0.000000 | 0.000000 | 0.000000 | 0.000000 | root_x_forward_z_up
