paraspective/MAGI-v2/hardware/urdf/MAGI_Assembly_URDF_description/meshes/MAGI_Assembly_URDF/MAGI_Assembly_URDF_MG996R_servo_7_collision.stl

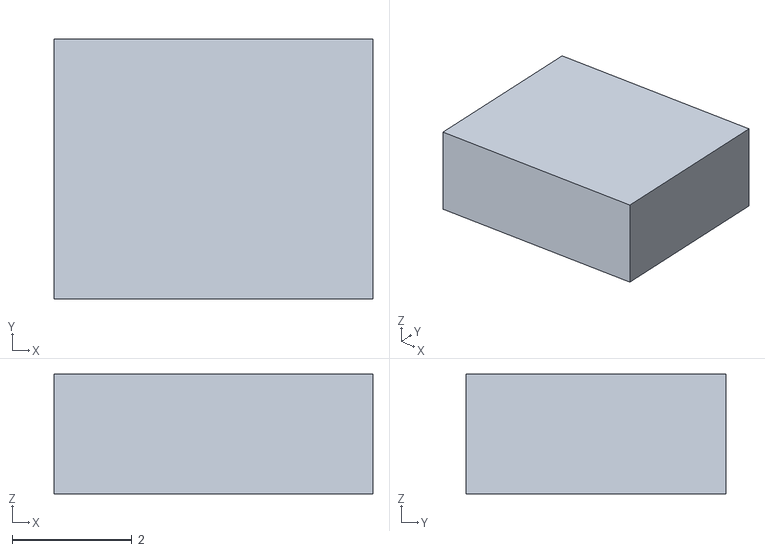
[picture p20: CAD file, 2026-10-24]
hardware/urdf/MAGI_Assembly_URDF_description/meshes/MAGI_Assembly_URDF/MAGI_Assembly_URDF_MG996R_servo_7_collision.stl
5.33 x 4.35 x 2.00
