paraspective/MAGI-v2/hardware/urdf/MAGI_Assembly_URDF_description/meshes/MAGI_Assembly_URDF/MAGI_Assembly_URDF_HQpod_Femur_4_collision.stl

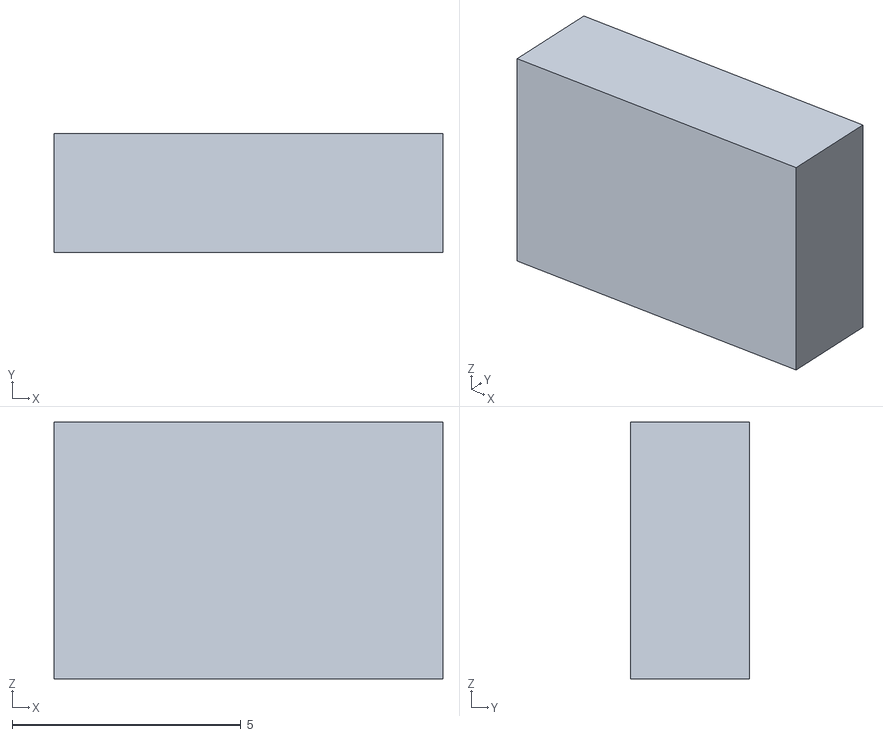
[picture p21: CAD file, 2026-10-24]
hardware/urdf/MAGI_Assembly_URDF_description/meshes/MAGI_Assembly_URDF/MAGI_Assembly_URDF_HQpod_Femur_4_collision.stl
8.50 x 2.60 x 5.61
