paraspective/MAGI-v2/hardware/urdf/MAGI_Assembly_URDF_description/meshes/MAGI_Assembly_URDF/MAGI_Assembly_URDF_HQpod_Coxal_Right_v2_2_collision.stl

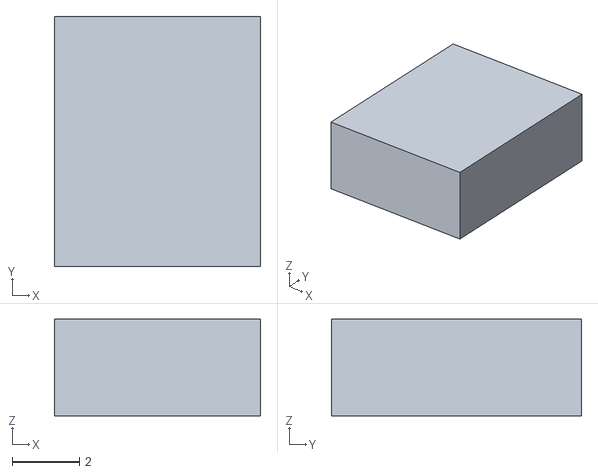
[picture p22: CAD file, 2026-10-24]
hardware/urdf/MAGI_Assembly_URDF_description/meshes/MAGI_Assembly_URDF/MAGI_Assembly_URDF_HQpod_Coxal_Right_v2_2_collision.stl
6.12 x 7.43 x 2.88
