paraspective/MAGI-v2/hardware/urdf/MAGI_Assembly_URDF_description/meshes/MAGI_Assembly_URDF/MAGI_Assembly_URDF_HQpod_Tibia_Left_collision.stl

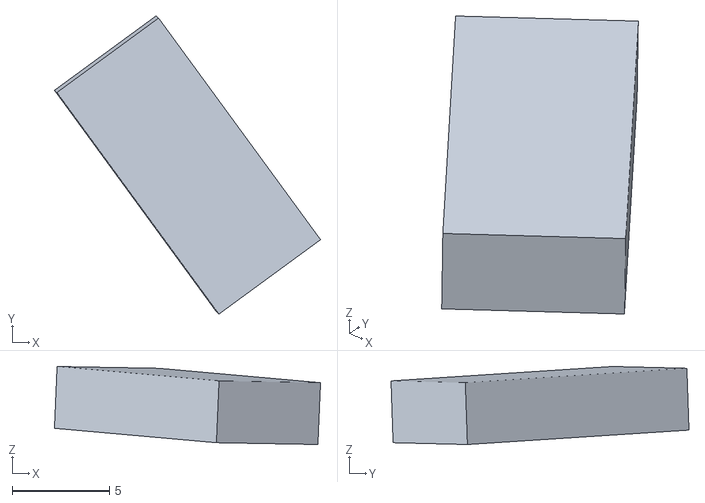
[picture p23: CAD file, 2026-10-24]
hardware/urdf/MAGI_Assembly_URDF_description/meshes/MAGI_Assembly_URDF/MAGI_Assembly_URDF_HQpod_Tibia_Left_collision.stl
13.6 x 15.3 x 4.00
