paraspective/MAGI-v2/hardware/urdf/MAGI_Assembly_URDF_description/meshes/MAGI_Assembly_URDF/MAGI_Assembly_URDF_HQpod_Tibia_Right_2_collision.stl

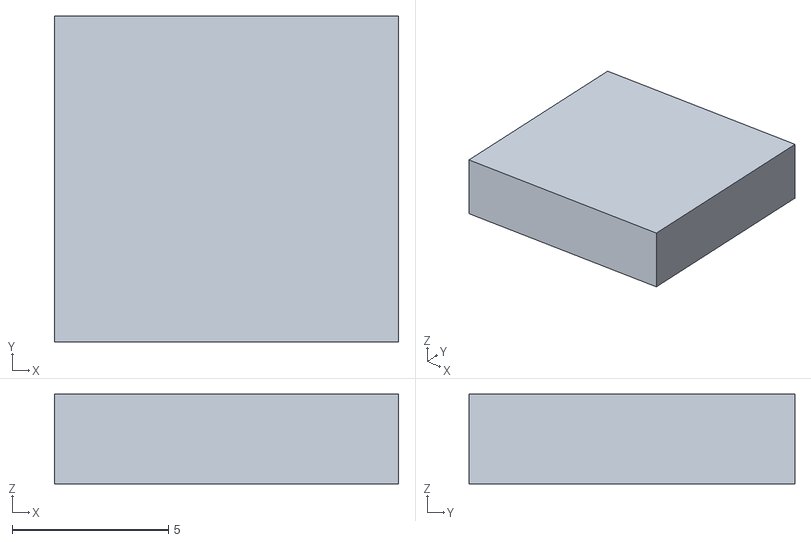
[picture p24: CAD file, 2026-10-24]
hardware/urdf/MAGI_Assembly_URDF_description/meshes/MAGI_Assembly_URDF/MAGI_Assembly_URDF_HQpod_Tibia_Right_2_collision.stl
11.0 x 10.4 x 2.88
