paraspective/MAGI-v2/hardware/cad/Ass servo.SLDPRT

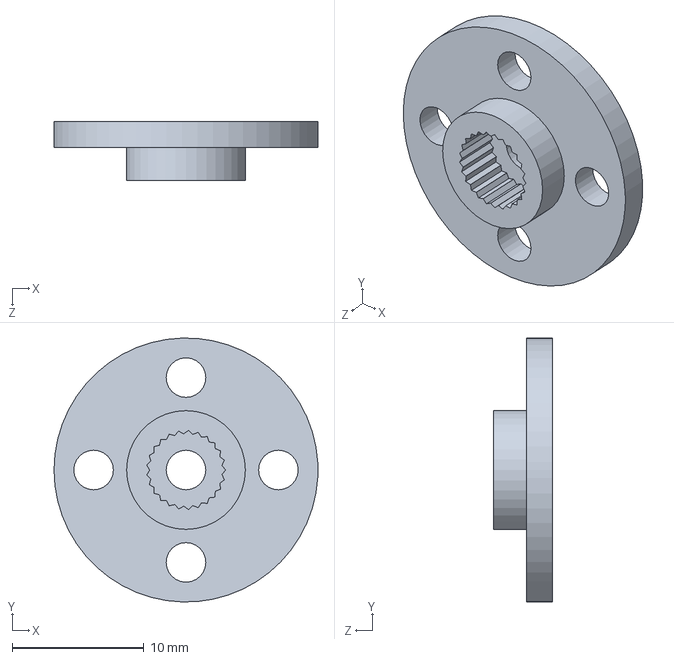
[picture p25: CAD file, 2026-10-24]
hardware/cad/Ass servo.SLDPRT
20.0 x 20.0 x 4.50 mm
