paraspective/MAGI-v2/hardware/stl/3ozjznhu8j9f-Bottom_Cover.stl

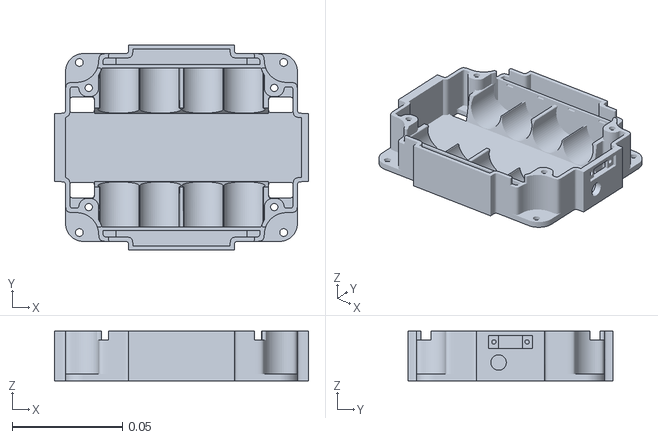
[picture p26: CAD file, 2026-10-24]
hardware/stl/3ozjznhu8j9f-Bottom_Cover.stl
0.115 x 0.093 x 0.0225
