paraspective/MAGI-v2/MAGI_iti3_urdf/MAGI_iteration3_description/meshes/HQpod_Femur__2__1.stl

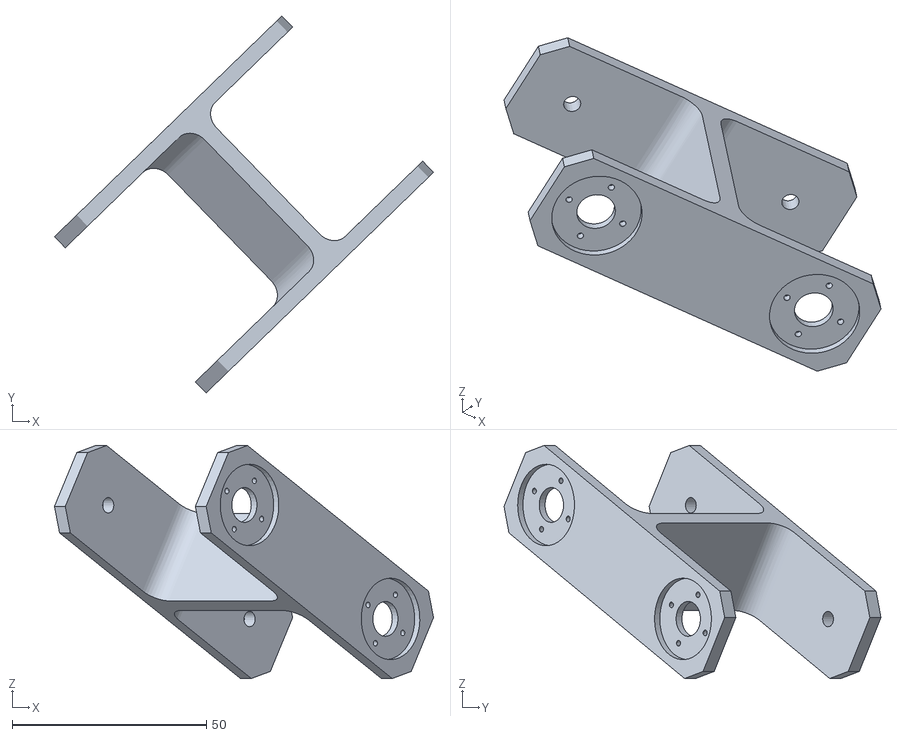
[picture p27: CAD file, 2026-10-27]
MAGI_iti3_urdf/MAGI_iteration3_description/meshes/HQpod_Femur__2__1.stl
97.6 x 97.1 x 60.0
