paraspective/MAGI-v2/MAGI_iti3_urdf/PowerCompartment_repaired.stl

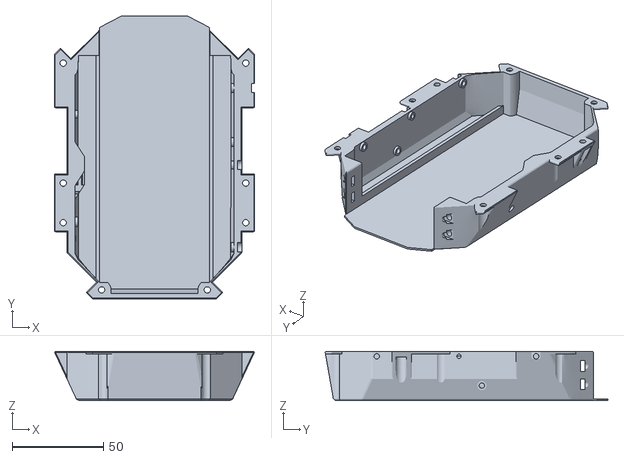
[picture p28: CAD file, 2026-10-27]
MAGI_iti3_urdf/PowerCompartment_repaired.stl
109.6 x 154.9 x 27.0
