paraspective/MAGI-v2/hardware/stl/gadc1auhphmw-CubeBot_Overview__4_.stl

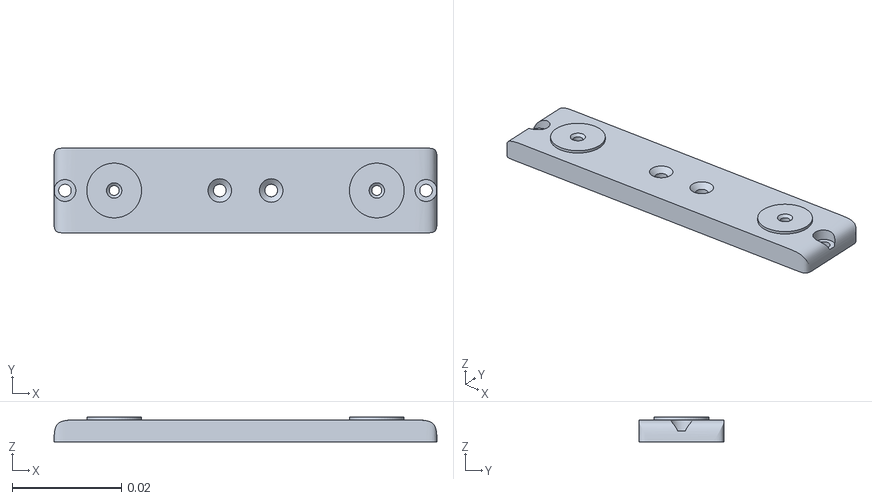
[picture p29: CAD file, 2026-10-24]
hardware/stl/gadc1auhphmw-CubeBot_Overview__4_.stl
0.07 x 0.0155 x 0.0045
