paraspective/MAGI-v2/MAGI_iti3_urdf/MAGI_iteration3_description/meshes/HQpod_Coxal_Servo_Plate_MG996R_pole_repositioned__3__1.stl

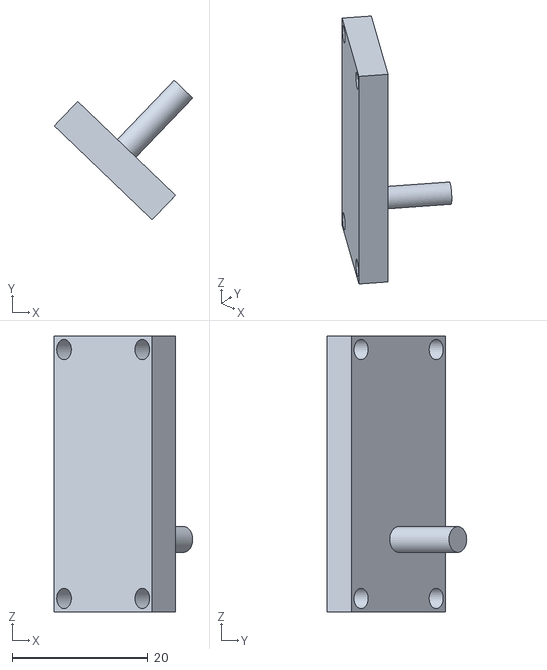
[picture p30: CAD file, 2026-10-27]
MAGI_iti3_urdf/MAGI_iteration3_description/meshes/HQpod_Coxal_Servo_Plate_MG996R_pole_repositioned__3__1.stl
20.4 x 20.6 x 40.7
