paraspective/MAGI-v2/hardware/stl/81e22so03fes-Leg-Body_Connector.stl

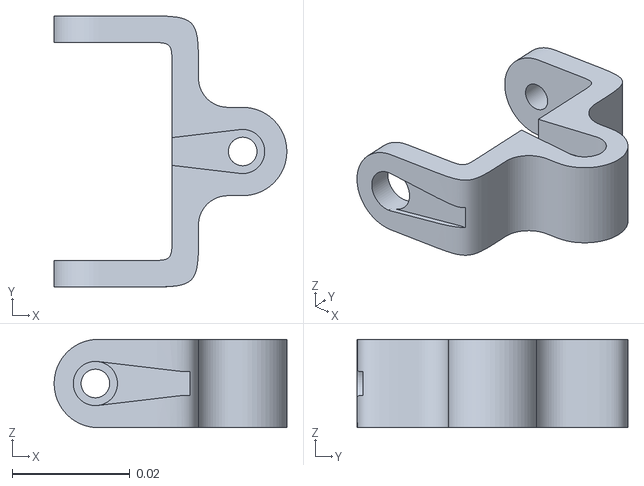
[picture p31: CAD file, 2026-10-24]
hardware/stl/81e22so03fes-Leg-Body_Connector.stl
0.0395 x 0.046 x 0.015
