paraspective/MAGI-v2/MAGI_iti3_urdf/MAGI_iteration3_description/meshes/HQpod_Coxal_Servo_Plate_MG996R_pole_repositioned__9__1.stl

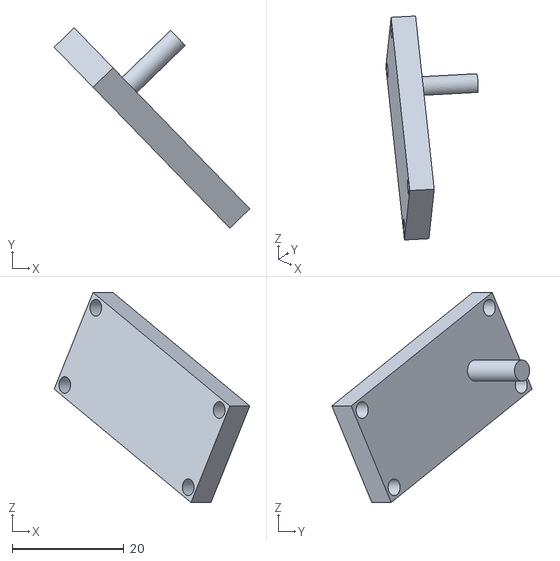
[picture p32: CAD file, 2026-10-27]
MAGI_iti3_urdf/MAGI_iteration3_description/meshes/HQpod_Coxal_Servo_Plate_MG996R_pole_repositioned__9__1.stl
35.1 x 35.9 x 37.7
