paraspective/MAGI-v2/hardware/stl/k2dg9youij02-CubeBot_Overview_Middle_Part.stl

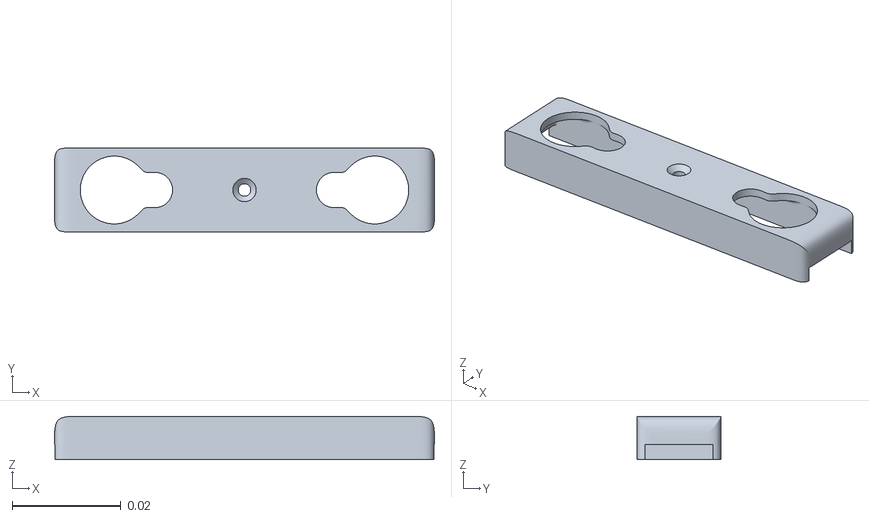
[picture p33: CAD file, 2026-10-24]
hardware/stl/k2dg9youij02-CubeBot_Overview_Middle_Part.stl
0.07 x 0.0155 x 0.008
