paraspective/MAGI-v2/MAGI_iti3_urdf/MAGI_iteration3_description/meshes/MG996R_servo__7__1.stl

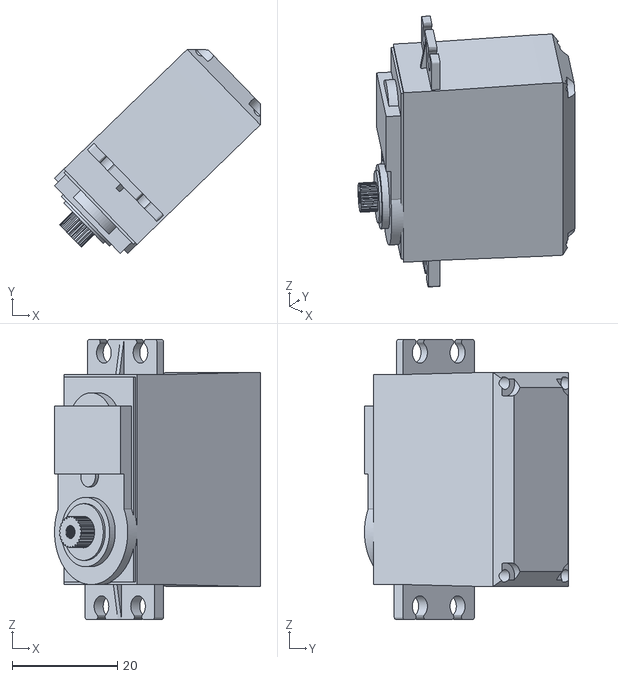
[picture p34: CAD file, 2026-10-27]
MAGI_iti3_urdf/MAGI_iteration3_description/meshes/MG996R_servo__7__1.stl
39.2 x 38.8 x 53.3
