paraspective/MAGI-v2/hardware/stl/42zlmowk6v3y-Body_Frame.stl

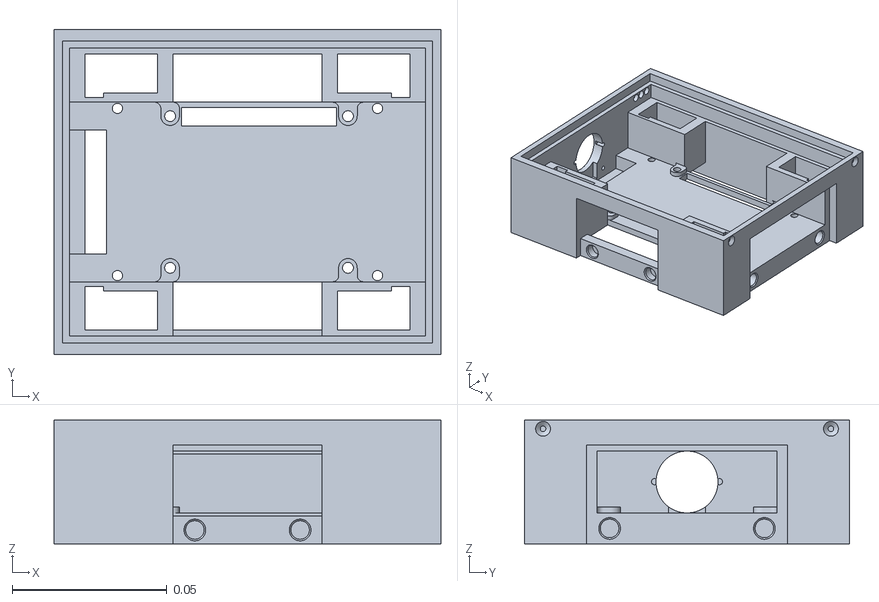
[picture p35: CAD file, 2026-10-24]
hardware/stl/42zlmowk6v3y-Body_Frame.stl
0.125 x 0.105 x 0.04
