paraspective/MAGI-v2/hardware/urdf/MAGI_Assembly_URDF_description/meshes/MAGI_Assembly_URDF/HexapodV3Top_collision.stl

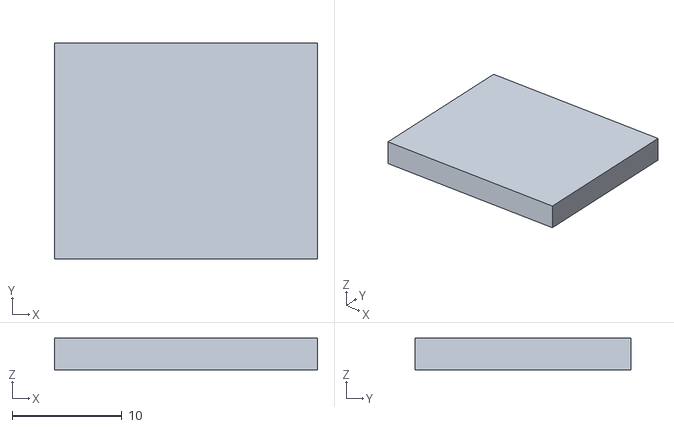
[picture p36: CAD file, 2026-10-24]
hardware/urdf/MAGI_Assembly_URDF_description/meshes/MAGI_Assembly_URDF/HexapodV3Top_collision.stl
24.0 x 19.7 x 2.88
