paraspective/MAGI-v2/hardware/stl/y3t8uh5qiyna-Camera_Cover.stl

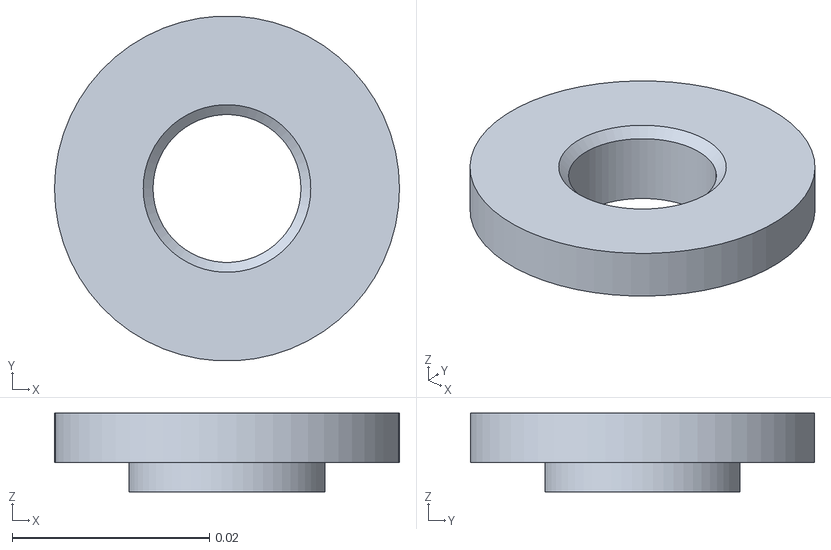
[picture p37: CAD file, 2026-10-24]
hardware/stl/y3t8uh5qiyna-Camera_Cover.stl
0.035 x 0.0349 x 0.008
