paraspective/MAGI-v2/hardware/stl/rj0o7epeozfy-CubeBot_Overview__3_.stl

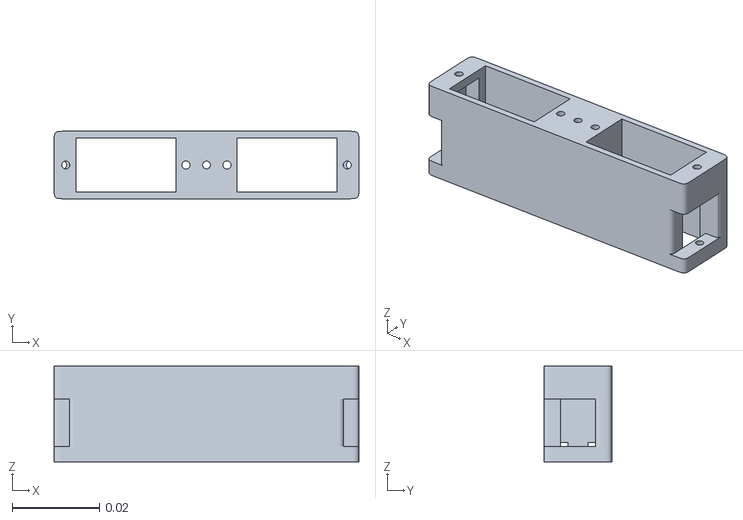
[picture p38: CAD file, 2026-10-24]
hardware/stl/rj0o7epeozfy-CubeBot_Overview__3_.stl
0.07 x 0.0155 x 0.022
