paraspective/MAGI-v2/MAGI_iti3_urdf/MAGI_iteration3_description/meshes/MG996R_servo__6__1.stl

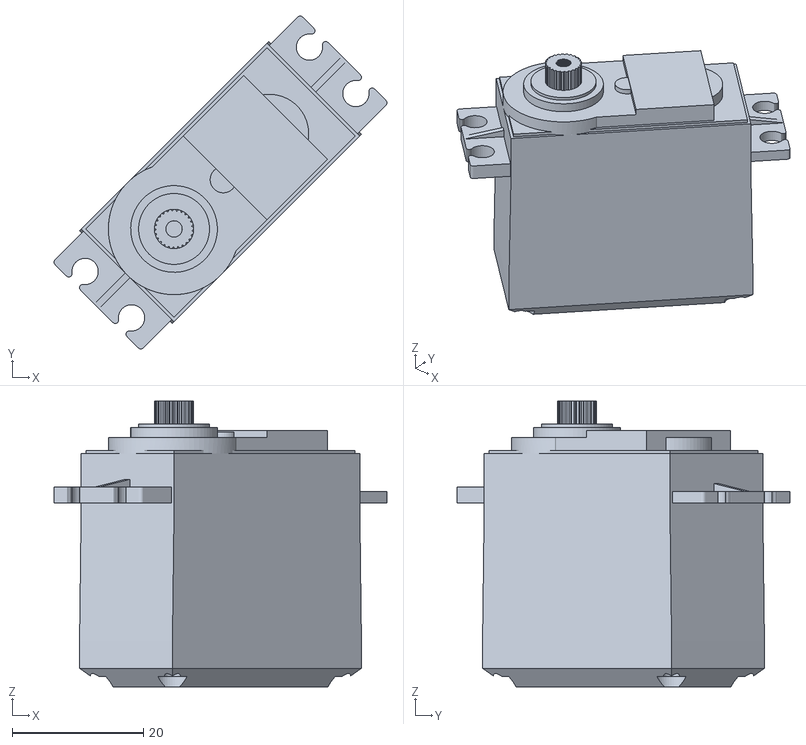
[picture p39: CAD file, 2026-10-27]
MAGI_iti3_urdf/MAGI_iteration3_description/meshes/MG996R_servo__6__1.stl
50.7 x 50.7 x 43.5
