paraspective/MAGI-v2/hardware/stl/u01tkdwts72r-Foot.stl

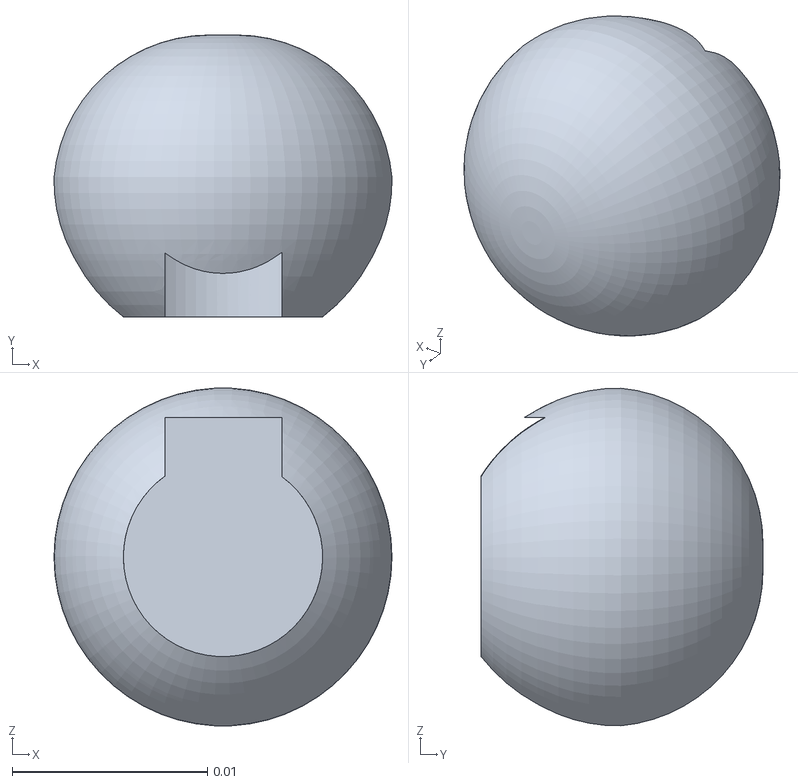
[picture p40: CAD file, 2026-10-24]
hardware/stl/u01tkdwts72r-Foot.stl
0.0173 x 0.0144 x 0.0173
