paraspective/MAGI-v2/hardware/stl/s4yj81t6fxf0-Top_Cover.stl

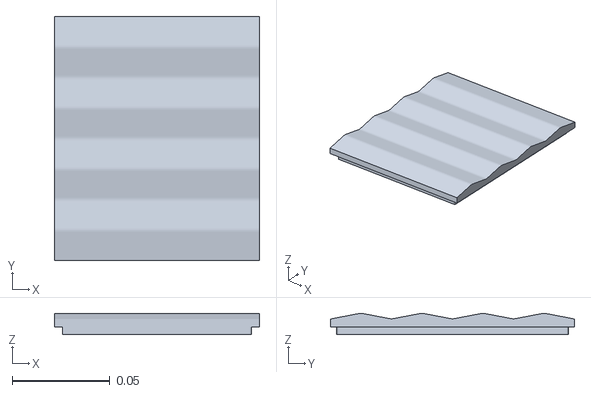
[picture p41: CAD file, 2026-10-24]
hardware/stl/s4yj81t6fxf0-Top_Cover.stl
0.105 x 0.125 x 0.0109
