paraspective/MAGI-v2/MAGI_iti3_urdf/MAGI_iteration3_description/meshes/ControllerPlate_1.stl

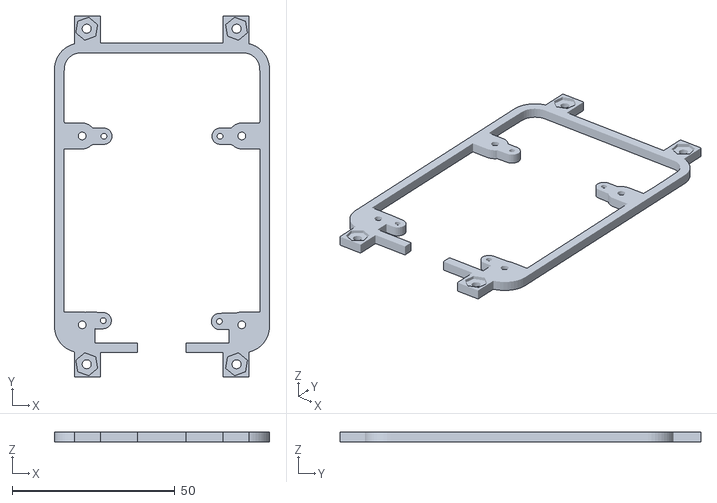
[picture p42: CAD file, 2026-10-27]
MAGI_iti3_urdf/MAGI_iteration3_description/meshes/ControllerPlate_1.stl
66.0 x 110.8 x 3.00
