paraspective/MAGI-v2/hardware/stl/3255p1l9eea4-Leg.stl

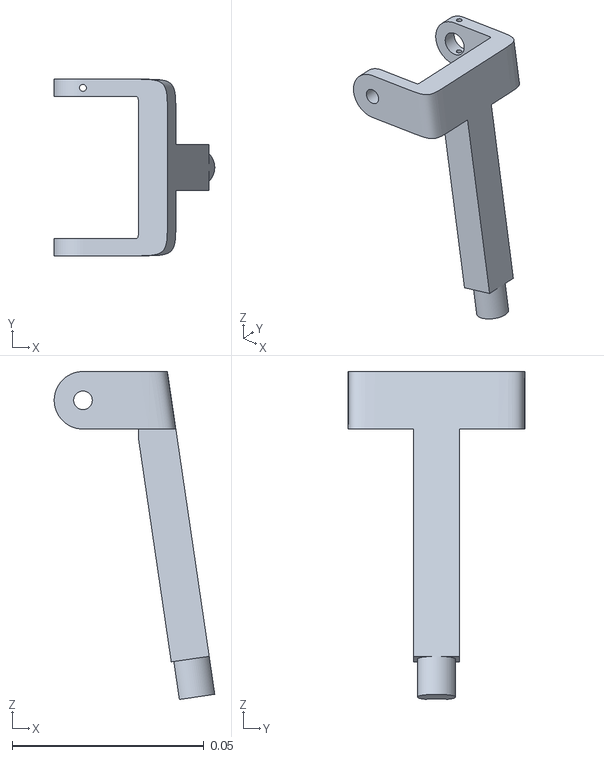
[picture p43: CAD file, 2026-10-24]
hardware/stl/3255p1l9eea4-Leg.stl
0.0418 x 0.046 x 0.0855
