paraspective/MAGI-v2/MAGI_iti3_urdf/MAGI_iteration3_description/meshes/HQpod_Tibia_Left_New__1__1.stl

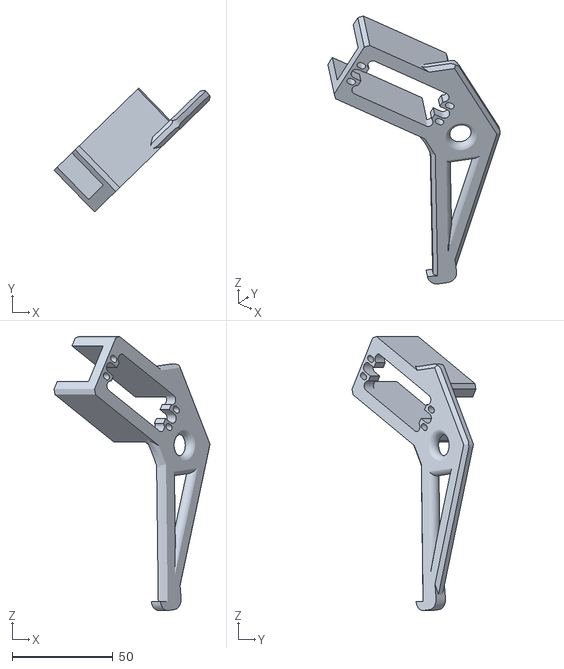
[picture p44: CAD file, 2026-10-27]
MAGI_iti3_urdf/MAGI_iteration3_description/meshes/HQpod_Tibia_Left_New__1__1.stl
77.2 x 61.4 x 135.7
