paraspective/MAGI-v2/hardware/urdf/MAGI_Assembly_URDF_description/meshes/MAGI_Assembly_URDF/HexapodV3Mid_collision.stl

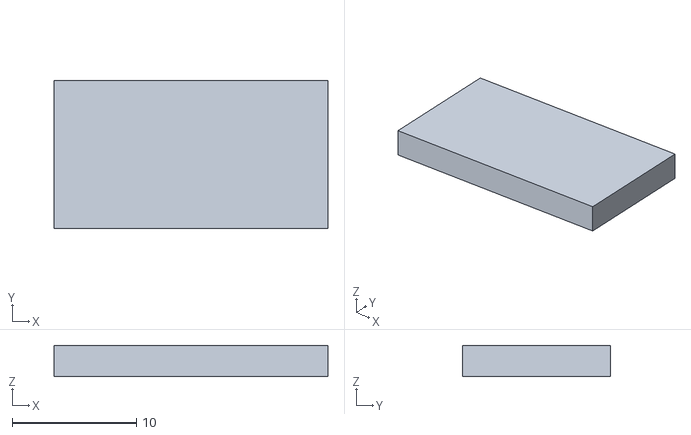
[picture p45: CAD file, 2026-10-24]
hardware/urdf/MAGI_Assembly_URDF_description/meshes/MAGI_Assembly_URDF/HexapodV3Mid_collision.stl
22.0 x 11.9 x 2.50
