paraspective/MAGI-v2/MAGI_iti3_urdf/MAGI_iteration3_description/meshes/HQpod_Coxal_Servo_Plate_MG996R_pole_repositioned__1__1.stl

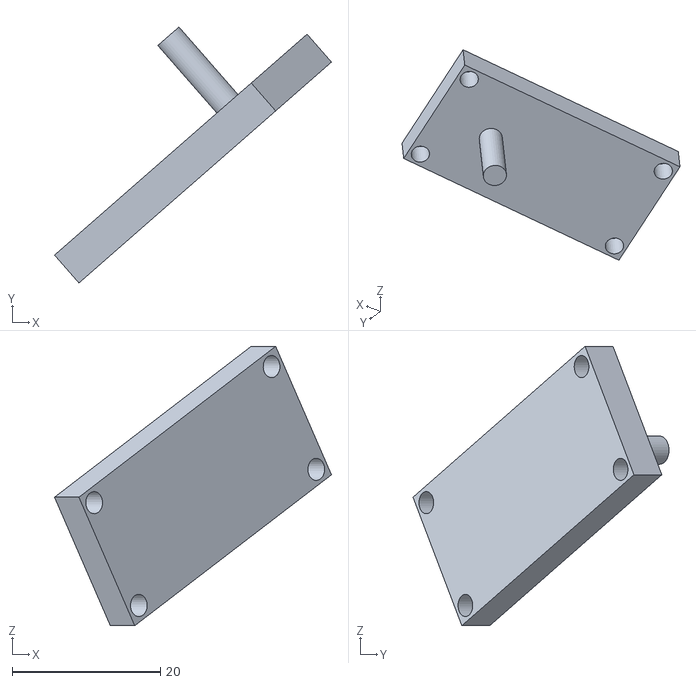
[picture p46: CAD file, 2026-10-27]
MAGI_iti3_urdf/MAGI_iteration3_description/meshes/HQpod_Coxal_Servo_Plate_MG996R_pole_repositioned__1__1.stl
37.3 x 34.5 x 37.7
