paraspective/MAGI-v2/MAGI_iti3_urdf/MAGI_iteration3_description/meshes/MG996R_servo__11__1.stl

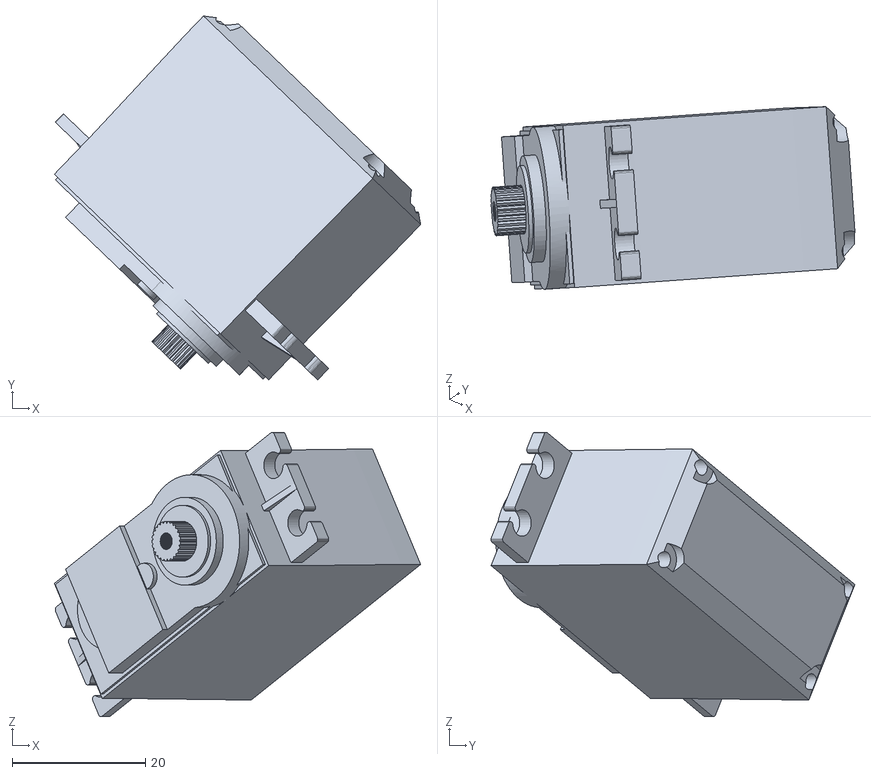
[picture p47: CAD file, 2026-10-27]
MAGI_iti3_urdf/MAGI_iteration3_description/meshes/MG996R_servo__11__1.stl
55.1 x 54.7 x 42.7
