paraspective/MAGI-v2/MAGI_iti3_urdf/MAGI_iteration3_description/meshes/FrameSideServoHolder__1__1.stl

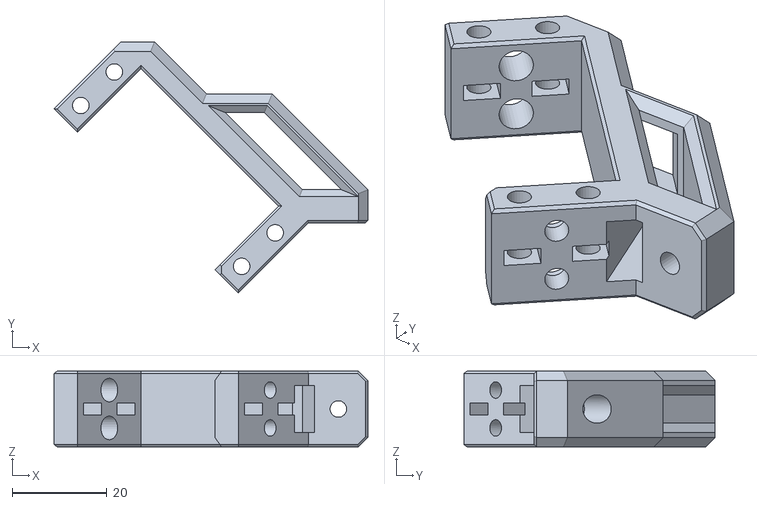
[picture p48: CAD file, 2026-10-27]
MAGI_iti3_urdf/MAGI_iteration3_description/meshes/FrameSideServoHolder__1__1.stl
66.3 x 53.0 x 16.0
