paraspective/MAGI-v2/MAGI_iti3_urdf/MAGI_iteration3_description/meshes/HQpod_Coxal_Right_v2_1.stl

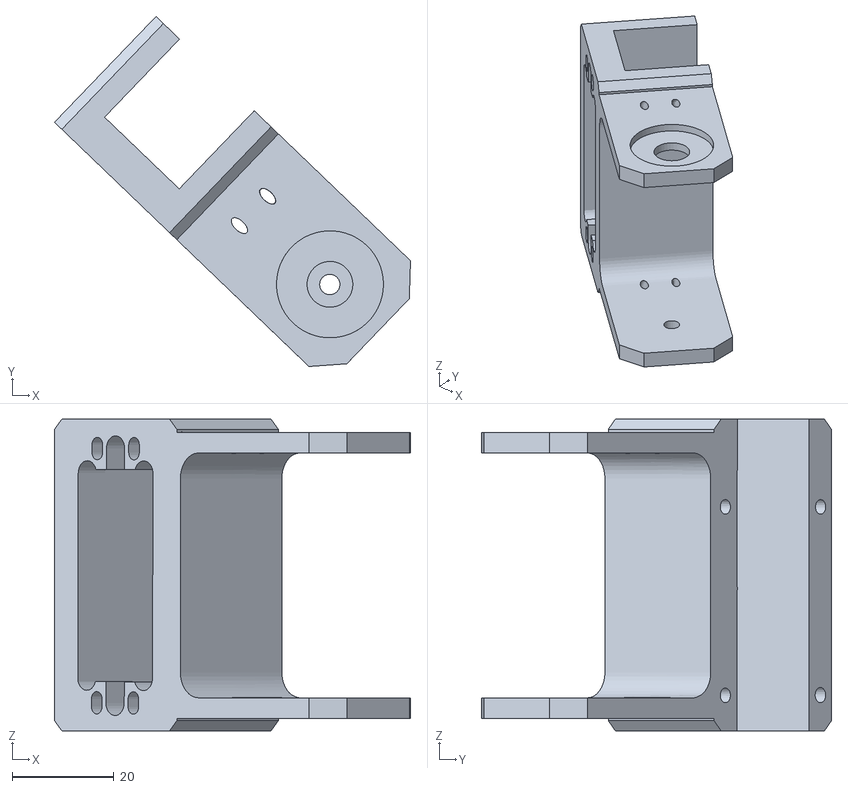
[picture p50: CAD file, 2026-10-27]
MAGI_iti3_urdf/MAGI_iteration3_description/meshes/HQpod_Coxal_Right_v2_1.stl
69.9 x 68.7 x 61.2
