paraspective/MAGI-v2/MAGI_iti3_urdf/MAGI_iteration3_description/meshes/MG996R_servo__5__1.stl

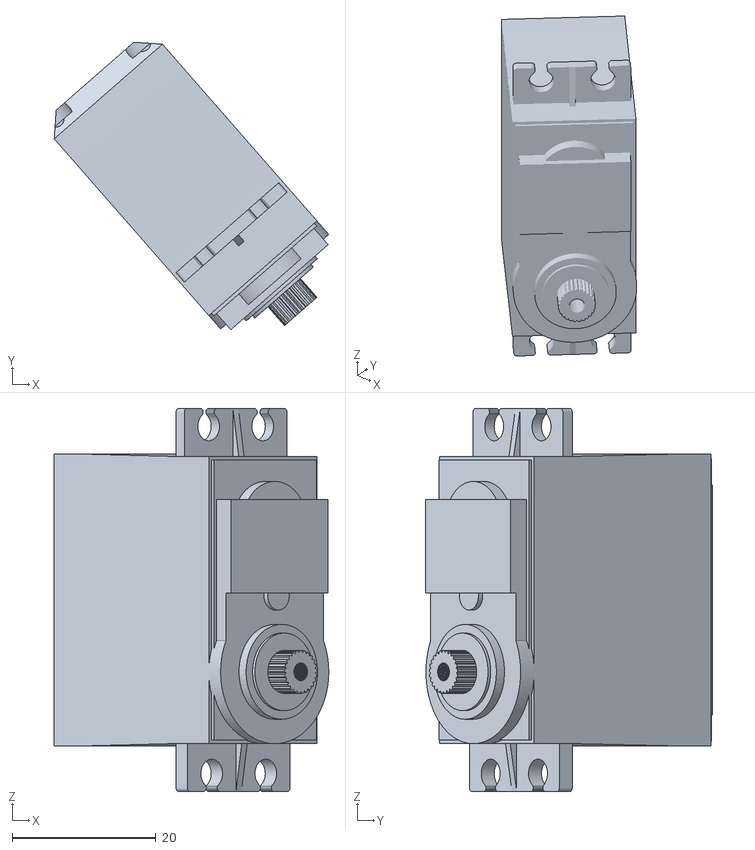
[picture p51: CAD file, 2026-10-27]
MAGI_iti3_urdf/MAGI_iteration3_description/meshes/MG996R_servo__5__1.stl
38.2 x 40.0 x 53.3
