paraspective/MAGI-v2/MAGI_iti3_urdf/MAGI_iteration3_description/meshes/PowerCompDoor_1.stl

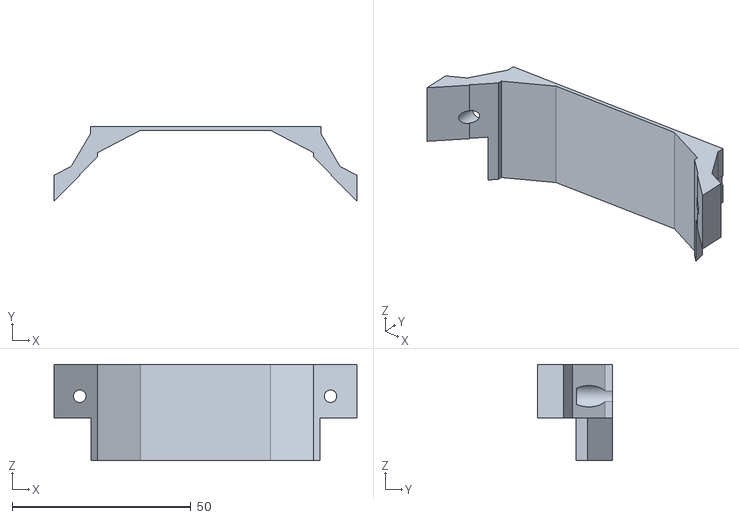
[picture p52: CAD file, 2026-10-27]
MAGI_iti3_urdf/MAGI_iteration3_description/meshes/PowerCompDoor_1.stl
84.8 x 20.9 x 27.0
