paraspective/MAGI-v2/MAGI_iti3_urdf/MAGI_iteration3_description/meshes/MG996R_servo__9__1.stl

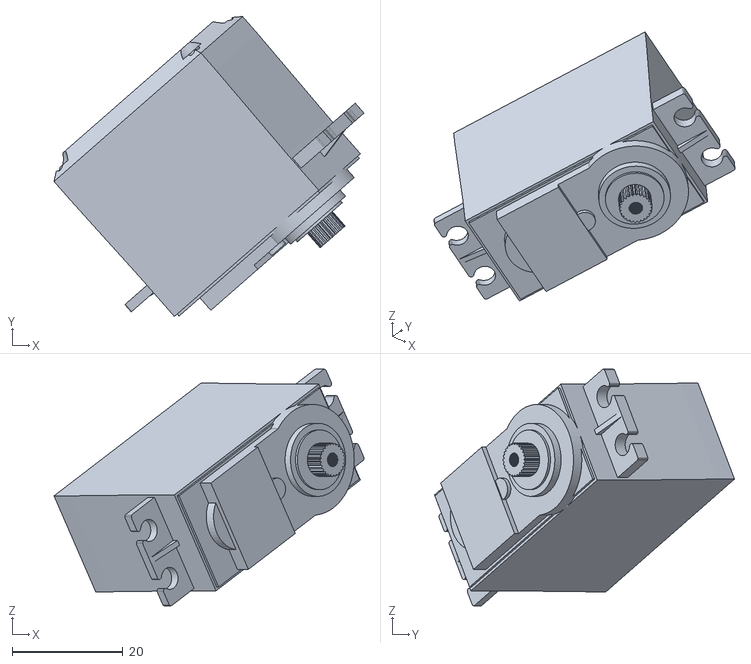
[picture p53: CAD file, 2026-10-27]
MAGI_iti3_urdf/MAGI_iteration3_description/meshes/MG996R_servo__9__1.stl
56.0 x 54.2 x 42.7
