paraspective/MAGI-v2/MAGI_iti3_urdf/MAGI_iteration3_description/meshes/HQpod_Tibia_Right_New__1__1.stl

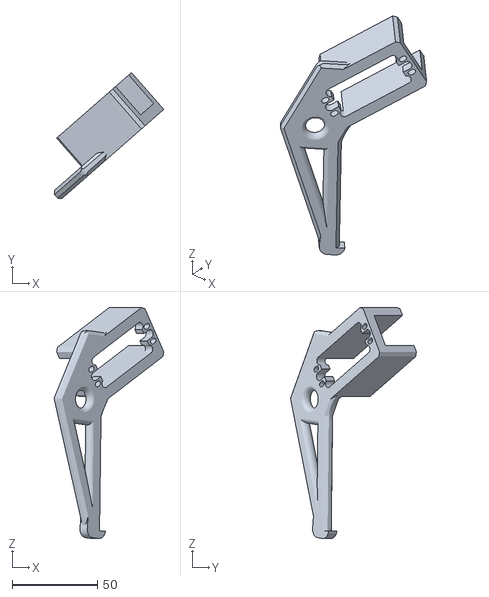
[picture p54: CAD file, 2026-10-27]
MAGI_iti3_urdf/MAGI_iteration3_description/meshes/HQpod_Tibia_Right_New__1__1.stl
64.4 x 74.0 x 135.7
