paraspective/MAGI-v2/MAGI_iti3_urdf/MAGI_iteration3_description/meshes/ElectronicsPlate_1.stl

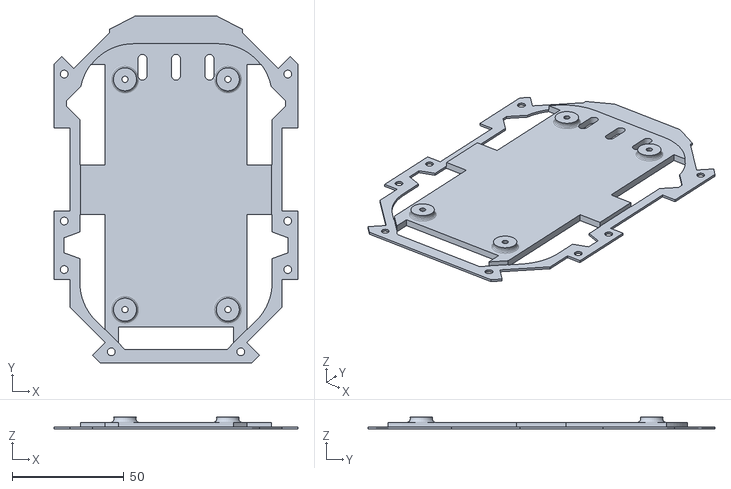
[picture p55: CAD file, 2026-10-27]
MAGI_iti3_urdf/MAGI_iteration3_description/meshes/ElectronicsPlate_1.stl
109.0 x 155.2 x 5.50
