paraspective/MAGI-v2/MAGI_iti3_urdf/MAGI_iteration3_description/meshes/HQpod_Coxal_Servo_Plate_MG996R_pole_repositioned__10__1.stl

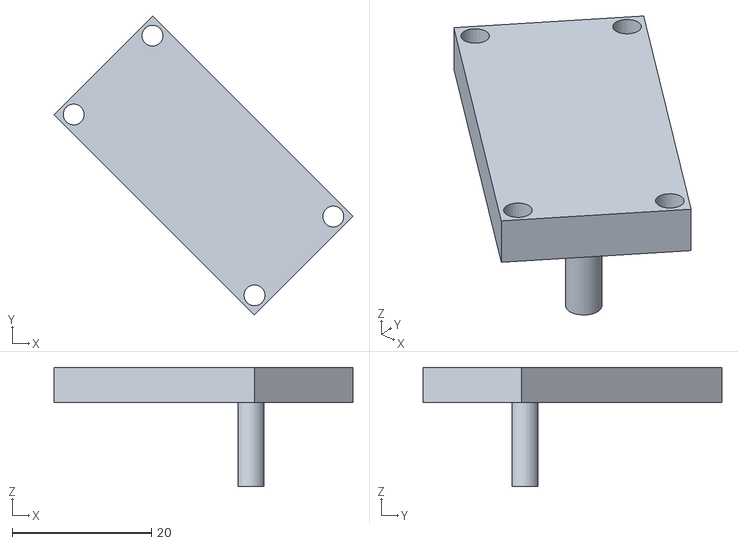
[picture p56: CAD file, 2026-10-27]
MAGI_iti3_urdf/MAGI_iteration3_description/meshes/HQpod_Coxal_Servo_Plate_MG996R_pole_repositioned__10__1.stl
42.9 x 42.9 x 17.1
