paraspective/MAGI-v2/MAGI_iti3_urdf/MAGI_iteration3_description/meshes/CarapaceFront_1.stl

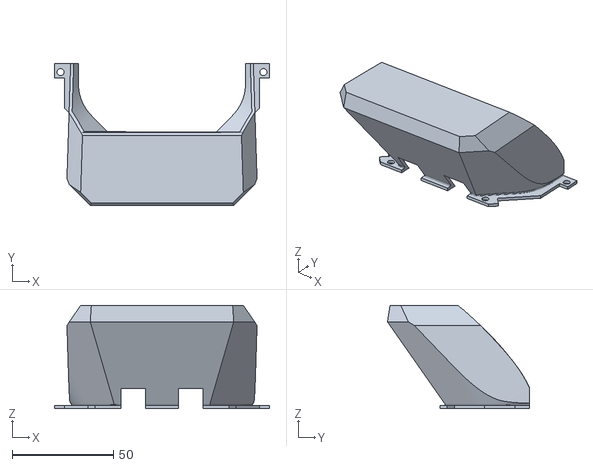
[picture p58: CAD file, 2026-10-27]
MAGI_iti3_urdf/MAGI_iteration3_description/meshes/CarapaceFront_1.stl
106.0 x 70.1 x 51.0
