paraspective/MAGI-v2/MAGI_iti3_urdf/MAGI_iteration3_description/meshes/CarapaceBack_1.stl

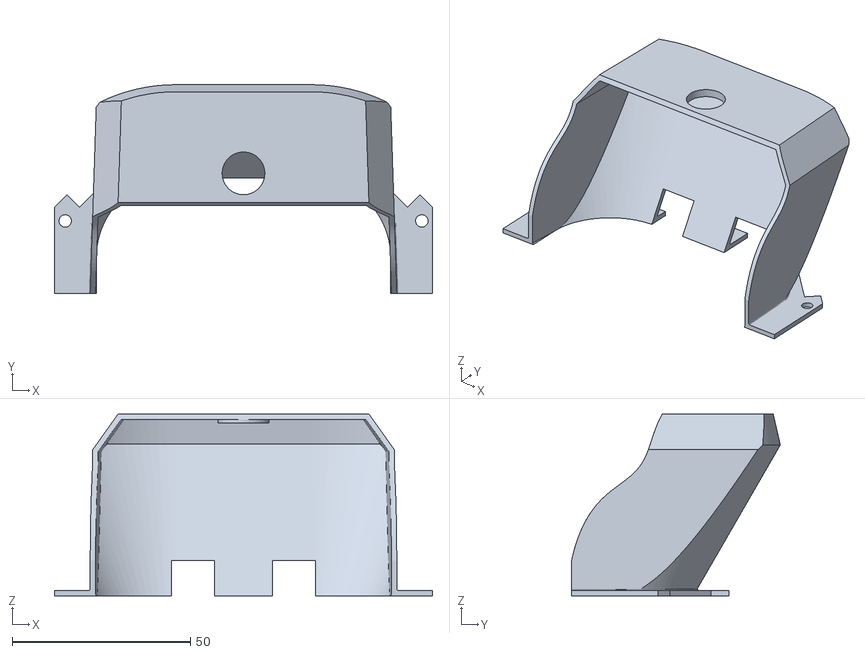
[picture p59: CAD file, 2026-10-27]
MAGI_iti3_urdf/MAGI_iteration3_description/meshes/CarapaceBack_1.stl
106.0 x 58.5 x 51.0
