paraspective/MAGI-v2/MAGI_iti3_urdf/MAGI_iteration3_description/meshes/base_link.stl

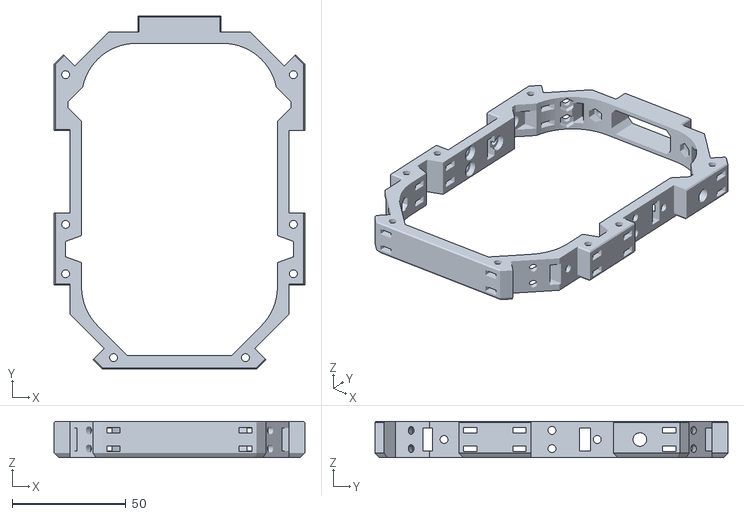
[picture p60: CAD file, 2026-10-27]
MAGI_iti3_urdf/MAGI_iteration3_description/meshes/base_link.stl
110.0 x 155.0 x 16.0
