paraspective/MAGI-v2/MAGI_iti3_urdf/MAGI_iteration3_description/meshes/CarapaceMid_1.stl

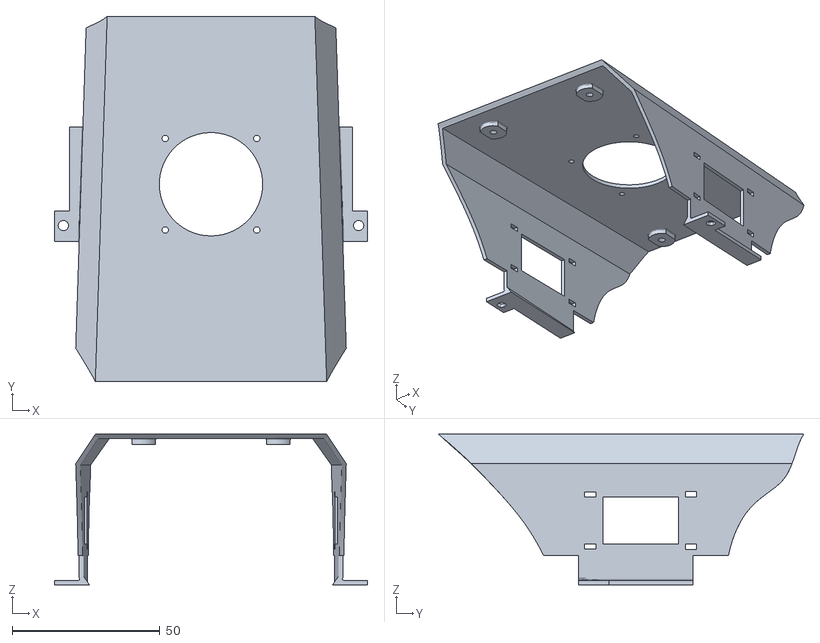
[picture p61: CAD file, 2026-10-27]
MAGI_iti3_urdf/MAGI_iteration3_description/meshes/CarapaceMid_1.stl
106.0 x 123.7 x 51.0
