paraspective/MAGI-v2/(list of files, cad)

Other CAD files:
hardware/urdf/MAGI_Assembly_URDF_description/meshes/MAGI_Assembly_URDF/MAGI_Assembly_URDF_HQpod_Coxal_Left_v2_2_collision.stl
MAGI_iti3_urdf/MAGI_iteration3_description/meshes/MG996R_servo__4__1.stl
MAGI_iti3_urdf/MAGI_iteration3_description/meshes/HQpod_Coxal_Servo_Plate_MG996R_pole_repositioned_1.stl
MAGI_iti3_urdf/MAGI_iteration3_description/meshes/MG996R_servo__10__1.stl
MAGI_iti3_urdf/MAGI_iteration3_description/meshes/MG996R_servo__2__1.stl
MAGI_iti3_urdf/MAGI_iteration3_description/meshes/FrameSideServoHolder__2__1.stl
MAGI_iti3_urdf/MAGI_iteration3_description/meshes/MG996R_servo_1.stl
MAGI_iti3_urdf/MAGI_iteration3_description/meshes/HQpod_Coxal_Servo_Plate_MG996R_pole_repositioned__7__1.stl
MAGI_iti3_urdf/MAGI_iteration3_description/meshes/HQpod_Coxal_Servo_Plate_MG996R_pole_repositioned__4__1.stl
MAGI_iti3_urdf/MAGI_iteration3_description/meshes/MG996R_servo__8__1.stl
MAGI_iti3_urdf/MAGI_iteration3_description/meshes/HQpod_Femur__1__1.stl
MAGI_iti3_urdf/MAGI_iteration3_description/meshes/HQpod_Coxal_Servo_Plate_MG996R_pole_repositioned__6__1.stl
MAGI_iti3_urdf/MAGI_iteration3_description/meshes/HQpod_Coxal_Servo_Plate_MG996R_pole_repositioned__11__1.stl
MAGI_iti3_urdf/MAGI_iteration3_description/meshes/HQpod_Coxal_Left_v2__1__1.stl
MAGI_iti3_urdf/MAGI_iteration3_description/meshes/MG996R_servo__1__1.stl
MAGI_iti3_urdf/MAGI_iteration3_description/meshes/HQpod_Tibia_Right_New_1.stl
MAGI_iti3_urdf/MAGI_iteration3_description/meshes/HQpod_Coxal_Servo_Plate_MG996R_pole_repositioned__5__1.stl
MAGI_iti3_urdf/MAGI_iteration3_description/meshes/FrameSideServoHolder_1 (2).stl
MAGI_iti3_urdf/MAGI_iteration3_description/meshes/MG996R_servo__3__1.stl
MAGI_iti3_urdf/MAGI_iteration3_description/meshes/FrameSideServoHolder__3__1.stl
MAGI_iti3_urdf/MAGI_iteration3_description/meshes/HQpod_Coxal_Servo_Plate_MG996R_pole_repositioned__2__1.stl
MAGI_iti3_urdf/MAGI_iteration3_description/meshes/HQpod_Tibia_Left_New_1.stl
MAGI_iti3_urdf/MAGI_iteration3_description/meshes/HQpod_Coxal_Servo_Plate_MG996R_pole_repositioned__8__1.stl
MAGI_iti3_urdf/MAGI_iteration3_description/meshes/FrameSideServoHolder_1__1__1.stl
MAGI_iti3_urdf/MAGI_iteration3_description/meshes/HQpod_Femur_1.stl
MAGI_iti3_urdf/MAGI_iteration3_description/meshes/HQpod_Coxal_Left_v2_1.stl
archive/cad_prototypes/HQpod_Coxal_Servo_Plate_40.7x20mm_with_3.8mm_pole (1).stl
archive/cad_prototypes/HQpod_Coxal_Servo_Plate_40.7x20mm_with_3.8mm_pole.stl
archive/cad_prototypes/HQpod_Coxal_Servo_Plate_MG996R_fit.stl
archive/cad_prototypes/HQpod_Coxal_Servo_Plate_MG996R_pole_repositioned.stl
archive/cad_prototypes/HQpod_Coxal_Servo_Plate_with_3.8mm_pole.stl
archive/cad_prototypes/MG996R_servo.f3d
archive/cad_prototypes/MG996R_servo.step
archive/cad_prototypes/mg996_arm_round.step
archive/references/Quadruped Hexapod MG996R - 2726435/files/HQ_Body_Servo_Plate.stl
archive/references/Quadruped Hexapod MG996R - 2726435/files/HQpod_Coxal_Left.stl
archive/references/Quadruped Hexapod MG996R - 2726435/files/HQpod_Coxal_Left_v2.stl
archive/references/Quadruped Hexapod MG996R - 2726435/files/HQpod_Coxal_Right.stl
archive/references/Quadruped Hexapod MG996R - 2726435/files/HQpod_Coxal_Right_v2.stl
archive/references/Quadruped Hexapod MG996R - 2726435/files/HQpod_Coxal_Servo_Plate.stl
archive/references/Quadruped Hexapod MG996R - 2726435/files/HQpod_Femur.stl
archive/references/Quadruped Hexapod MG996R - 2726435/files/HQpod_Tibia_Left.stl
archive/references/Quadruped Hexapod MG996R - 2726435/files/HQpod_Tibia_Right.stl
archive/references/Quadruped Hexapod MG996R - 2726435/files/HQpod_Tibia_Servo_Plate_.stl
archive/references/Quadruped Hexapod MG996R - 2726435/files/HexapodV3Bottom.stl
archive/references/Quadruped Hexapod MG996R - 2726435/files/HexapodV3Mid.stl
archive/references/Quadruped Hexapod MG996R - 2726435/files/HexapodV3Top.stl
archive/references/Regis/CAD & .stl files/Center Plate.stl
archive/references/Regis/CAD & .stl files/Face Lock Peg.stl
archive/references/Regis/CAD & .stl files/Face Plate.stl
archive/references/Regis/CAD & .stl files/Leg Hinge.stl
archive/references/Regis/CAD & .stl files/Neck Bracket.stl
archive/references/Regis/CAD & .stl files/Neck Motor Shaft.stl
archive/references/Regis/CAD & .stl files/Pi_4_Case_bottom.stl
archive/references/Regis/CAD & .stl files/Pi_4_Case_top.stl
archive/references/Regis/CAD & .stl files/Top Plate.stl
archive/references/Regis/CAD & .stl files/Version 0.0 8.25.2025.FCStd
archive/references/Regis/CAD & .stl files/coxa-b.stl
archive/references/Regis/CAD & .stl files/coxa-f.stl
archive/references/Regis/CAD & .stl files/femur.stl
archive/references/Regis/CAD & .stl files/tibia-b.stl
archive/references/Regis/CAD & .stl files/tibia-f.stl
archive/references/SpdrBot/spyderbot_minimal URDF/SpdrBot_description/meshes/arm_a_1_1.stl
archive/references/SpdrBot/spyderbot_minimal URDF/SpdrBot_description/meshes/arm_a_2_1.stl
archive/references/SpdrBot/spyderbot_minimal URDF/SpdrBot_description/meshes/arm_a_3_1.stl
archive/references/SpdrBot/spyderbot_minimal URDF/SpdrBot_description/meshes/arm_a_4_1.stl
archive/references/SpdrBot/spyderbot_minimal URDF/SpdrBot_description/meshes/arm_b_1_1.stl
archive/references/SpdrBot/spyderbot_minimal URDF/SpdrBot_description/meshes/arm_b_2_1.stl
archive/references/SpdrBot/spyderbot_minimal URDF/SpdrBot_description/meshes/arm_b_3_1.stl
archive/references/SpdrBot/spyderbot_minimal URDF/SpdrBot_description/meshes/arm_b_4_1.stl
archive/references/SpdrBot/spyderbot_minimal URDF/SpdrBot_description/meshes/arm_c_1_1.stl
archive/references/SpdrBot/spyderbot_minimal URDF/SpdrBot_description/meshes/arm_c_2_1.stl
archive/references/SpdrBot/spyderbot_minimal URDF/SpdrBot_description/meshes/arm_c_3_1.stl
archive/references/SpdrBot/spyderbot_minimal URDF/SpdrBot_description/meshes/arm_c_4_1.stl
archive/references/SpdrBot/spyderbot_minimal URDF/SpdrBot_description/meshes/base_link.stl
archive/references/Walking 3U CubeSat - 6395490/files/1x_Back_cover.stl
archive/references/Walking 3U CubeSat - 6395490/files/1x_Front_cover.stl
archive/references/Walking 3U CubeSat - 6395490/files/1x_Mount_Buck_Converters.stl
archive/references/Walking 3U CubeSat - 6395490/files/2x_Frame_large.stl
archive/references/Walking 3U CubeSat - 6395490/files/2x_Frame_small.stl
archive/references/Walking 3U CubeSat - 6395490/files/2x_Servo_mount_left.stl
archive/references/Walking 3U CubeSat - 6395490/files/2x_Servo_mount_right.stl
archive/references/Walking 3U CubeSat - 6395490/files/2x_Side_cover_1.stl
archive/references/Walking 3U CubeSat - 6395490/files/2x_Side_cover_2.stl
archive/references/Walking 3U CubeSat - 6395490/files/2x_Square_center.stl
archive/references/Walking 3U CubeSat - 6395490/files/2x_Square_front-back.stl
archive/references/Walking 3U CubeSat - 6395490/files/4x_COXA_1.stl
archive/references/Walking 3U CubeSat - 6395490/files/4x_COXA__2.stl
archive/references/Walking 3U CubeSat - 6395490/files/4x_Femur_2.stl
archive/references/Walking 3U CubeSat - 6395490/files/4x_Tibia_1.stl
archive/references/Walking 3U CubeSat - 6395490/files/4x_Tibia__2.stl
archive/references/hexapod_spiderbot_model-main/hexapod_spiderbot_model-main/stl/CarapaceBack.stl
archive/references/hexapod_spiderbot_model-main/hexapod_spiderbot_model-main/stl/CarapaceFront.stl
archive/references/hexapod_spiderbot_model-main/hexapod_spiderbot_model-main/stl/CarapaceMid.stl
archive/references/hexapod_spiderbot_model-main/hexapod_spiderbot_model-main/stl/Claw.stl
archive/references/hexapod_spiderbot_model-main/hexapod_spiderbot_model-main/stl/ControllerPlate.stl
archive/references/hexapod_spiderbot_model-main/hexapod_spiderbot_model-main/stl/CoxaSide1_625ZZ.stl
archive/references/hexapod_spiderbot_model-main/hexapod_spiderbot_model-main/stl/CoxaSide2_8holes.stl
archive/references/hexapod_spiderbot_model-main/hexapod_spiderbot_model-main/stl/ElectronicsPlate.stl
archive/references/hexapod_spiderbot_model-main/hexapod_spiderbot_model-main/stl/FemurSide1_625ZZ.stl
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
