paraspective/MAGI-v2/archive/urdf_iterations/URDF_initial/debug/export_log.md

# Export Log: MAGI_Assembly_URDF v1

**Generated:** 2026-08-22T17:02:23.148432

```
[17:00:06] fusion2URDF v3.1.0
[17:00:06] Time: 2026-08-22T17:00:06.231265
[17:00:06] Design: MAGI_Assembly_URDF v1
[17:00:06] Components: 10
[17:00:06] 
=== PHASE 1: EXTRACTION ===
[17:00:06]   Document unit: mm
[17:00:06] 
=== EXTRACTION: OCCURRENCES ===
[17:00:06]   [LEAF] d=0 base_link
[17:00:06]     path: base_link v3:1
[17:00:06]     global_pos: (0.000000, 0.000000, 0.000000) m
[17:00:06]     mass: 0.461432 kg, bodies: 1
[17:00:06]     com_global: (0.188950, 1.012566, 0.124814) m
[17:00:06]     com_component_local: (0.188950, 1.012566, 0.124814) m
[17:00:06]     inertia@origin: ixx=4.810833e-01 iyy=2.548777e-02 izz=4.921769e-01 kg·m²
[17:00:06]     inertia@com:    ixx=7.929840e-04 iyy=1.825252e-03 izz=2.601024e-03 kg·m²
[17:00:06]     material: Steel
[17:00:06]     color: RGB(0.63, 0.63, 0.63) [Steel_Satin]
[17:00:06]     bbox: (0.2195 x 0.1449 x 0.0270) m
[17:00:06]   [LEAF] d=0 HexapodV3Mid
[17:00:06]     path: HexapodV3Mid v5:1
[17:00:06]     global_pos: (0.113207, 1.351156, -0.242000) m
[17:00:06]     mass: 0.430715 kg, bodies: 1
[17:00:06]     com_global: (0.170142, 1.012498, 0.150833) m
[17:00:06]     com_component_local: (0.056935, -0.338657, 0.392833) m
[17:00:06]     inertia@origin: ixx=1.162344e-01 iyy=6.948798e-02 izz=5.277708e-02 kg·m²
[17:00:06]     inertia@com:    ixx=3.691505e-04 iyy=1.624727e-03 izz=1.982639e-03 kg·m²
[17:00:06]     material: Steel
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
[17:00:06]     com_component_local: (0.656485, -0.209995, 0.143258) m
[17:00:06]     inertia@origin: ixx=1.730728e-02 iyy=1.201908e-01 izz=1.265447e-01 kg·m²
[17:00:06]     inertia@com:    ixx=1.236173e-04 iyy=1.306979e-04 izz=2.156704e-04 kg·m²
[17:00:06]     material: Steel
[17:00:06]     color: RGB(0.63, 0.63, 0.63) [Steel_Satin]
[17:00:06]     bbox: (0.0612 x 0.0743 x 0.0288) m
[17:00:06]   Extracted 28 occurrences
[17:00:06] 
=== EXTRACTION: JOINTS ===
[17:00:06]   WARNING:   regular joint in component 'MAGI_Assembly_URDF v1': failed to read geometry: 'Joint' object has no attribute 'geometry'
[17:00:06]   [REGULAR in MAGI_Assembly_URDF] Rigid_1
[17:00:06]     parent(occ2): base_link path=base_link v3:1
[17:00:06]     child(occ1):  HexapodV3Mid path=HexapodV3Mid v5:1
[17:00:06]     geometryOrOriginOne: (9.7026, 105.3896, 14.8500) cm
[17:00:06]     geometryOrOriginTwo: (9.7026, 105.3896, 14.8500) cm
[17:00:06]     occ1.transform: (11.3207, 135.1156, -24.2000) cm (ctx_depth=0)
[17:00:06]     occ1.global:    (11.3207, 135.1156, -24.2000) cm
[17:00:06]     occ2.transform: (0.0000, 0.0000, 0.0000) cm (ctx_depth=0)
[17:00:06]     occ2.global:    (0.0000, 0.0000, 0.0000) cm
[17:00:06]  -> origin_global: (0.097026, 1.053896, 0.148500) m [via geometryOrOriginOne]
[17:00:06]     motion: rigid, axis: (0.000, 0.000, 1.000)
[17:00:06]   WARNING:   regular joint in component 'MAGI_Assembly_URDF v1': failed to read geometry: 'Joint' object has no attribute 'geometry'
[17:00:06]   [REGULAR in MAGI_Assembly_URDF] Rigid_2
[17:00:06]     parent(occ2): HexapodV3Mid path=HexapodV3Mid v5:1
[17:00:06]     child(occ1):  HexapodV3Top path=HexapodV3Top v3:1
[17:00:06]     geometryOrOriginOne: (9.7026, 97.1290, 15.1498) cm
[17:00:06]     geometryOrOriginTwo: (9.7026, 97.1290, 15.1498) cm
[17:00:06]     occ1.transform: (3.8772, -150.0410, -8.9852) cm (ctx_depth=0)
[17:00:06]     occ1.global:    (3.8772, -150.0410, -8.9852) cm
[17:00:06]     occ2.transform: (11.3207, 135.1156, -24.2000) cm (ctx_depth=0)
[17:00:06]     occ2.global:    (11.3207, 135.1156, -24.2000) cm
[17:00:06]  -> origin_global: (0.097026, 0.971290, 0.151498) m [via geometryOrOriginOne]
[17:00:06]     motion: rigid, axis: (0.000, 0.000, 1.000)
[17:00:06]   WARNING:   regular joint in component 'MAGI_Assembly_URDF v1': failed to read geometry: 'Joint' object has no attribute 'geometry'
[17:00:06]   [REGULAR in MAGI_Assembly_URDF] Rigid_4
[17:00:06]     parent(occ2): HexapodV3Top path=HexapodV3Top v3:1
[17:00:06]     child(occ1):  MG996R_servo path=MG996R_servo v1:1
[17:00:06]     geometryOrOriginOne: (12.8698, 96.4906, 15.1498) cm
[17:00:06]     geometryOrOriginTwo: (12.8698, 96.4906, 15.1498) cm
[17:00:06]     occ1.transform: (9.3697, 93.6976, 12.1750) cm (ctx_depth=0)
[17:00:06]     occ1.global:    (9.3697, 93.6976, 12.1750) cm
[17:00:06]     occ2.transform: (3.8772, -150.0410, -8.9852) cm (ctx_depth=0)
[17:00:06]     occ2.global:    (3.8772, -150.0410, -8.9852) cm
[17:00:06]  -> origin_global: (0.128698, 0.964906, 0.151498) m [via geometryOrOriginOne]
[17:00:06]     motion: rigid, axis: (0.000, 0.000, 1.000)
[17:00:06]   WARNING:   regular joint in component 'MAGI_Assembly_URDF v1': failed to read geometry: 'Joint' object has no attribute 'geometry'
[17:00:06]   [REGULAR in MAGI_Assembly_URDF] Revolute_5
[17:00:06]     parent(occ2): MG996R_servo path=MG996R_servo v1:1
[17:00:06]     child(occ1):  HQpod_Coxal_Left_v2 path=HQpod_Coxal_Left_v2 v2:2
[17:00:06]     geometryOrOriginOne: (10.1015, 94.4294, 16.1744) cm
[17:00:06]     geometryOrOriginTwo: (10.1015, 94.4294, 16.1744) cm
[17:00:06]     occ1.transform: (-40.4878, 65.4014, 79.1767) cm (ctx_depth=0)
[17:00:06]     occ1.global:    (-40.4878, 65.4014, 79.1767) cm
[17:00:06]     occ2.transform: (9.3697, 93.6976, 12.1750) cm (ctx_depth=0)
[17:00:06]     occ2.global:    (9.3697, 93.6976, 12.1750) cm
[17:00:06]  -> origin_global: (0.101015, 0.944294, 0.161744) m [via geometryOrOriginOne]
[17:00:06]     motion: revolute, axis: (-0.000, 0.000, 1.000)
[17:00:06]     rotation limits: [-0.5934, 1.5708] rad
[17:00:06]   WARNING:   regular joint in component 'MAGI_Assembly_URDF v1': failed to read geometry: 'Joint' object has no attribute 'geometry'
[17:00:06]   [REGULAR in MAGI_Assembly_URDF] Rigid_6
[17:00:06]     parent(occ2): HQpod_Coxal_Left_v2 path=HQpod_Coxal_Left_v2 v2:2
[17:00:06]     child(occ1):  MG996R_servo path=MG996R_servo v1:2
[17:00:06]     geometryOrOriginOne: (6.0709, 91.4894, 16.1843) cm
[17:00:06]     geometryOrOriginTwo: (6.0709, 91.4894, 16.1843) cm
[17:00:06]     occ1.transform: (8.5017, 89.7030, 11.7344) cm (ctx_depth=0)
[17:00:06]     occ1.global:    (8.5017, 89.7030, 11.7344) cm
[17:00:06]     occ2.transform: (-40.4878, 65.4014, 79.1767) cm (ctx_depth=0)
[17:00:06]     occ2.global:    (-40.4878, 65.4014, 79.1767) cm
[17:00:06]  -> origin_global: (0.060709, 0.914894, 0.161843) m [via geometryOrOriginOne]
[17:00:06]     motion: rigid, axis: (0.000, 0.000, 1.000)
[17:00:06]   WARNING:   regular joint in component 'MAGI_Assembly_URDF v1': failed to read geometry: 'Joint' object has no attribute 'geometry'
[17:00:06]   [REGULAR in MAGI_Assembly_URDF] Revolute_7
[17:00:06]     parent(occ2): MG996R_servo path=MG996R_servo v1:2
[17:00:06]     child(occ1):  HQpod_Femur path=HQpod_Femur v3:1
[17:00:06]     geometryOrOriginOne: (5.7161, 92.5728, 12.7693) cm
[17:00:06]     geometryOrOriginTwo: (5.7161, 92.5728, 12.7693) cm
[17:00:06]     occ1.transform: (39.7256, 47.9610, 82.9249) cm (ctx_depth=0)
[17:00:06]     occ1.global:    (39.7256, 47.9610, 82.9249) cm
[17:00:06]     occ2.transform: (8.5017, 89.7030, 11.7344) cm (ctx_depth=0)
[17:00:06]     occ2.global:    (8.5017, 89.7030, 11.7344) cm
[17:00:06]  -> origin_global: (0.057161, 0.925728, 0.127693) m [via geometryOrOriginOne]
[17:00:06]     motion: revolute, axis: (-0.697, 0.718, -0.000)
[17:00:06]     rotation limits: [-1.3963, 0.9599] rad
[17:00:06]   WARNING:   regular joint in component 'MAGI_Assembly_URDF v1': failed to read geometry: 'Joint' object has no attribute 'geometry'
[17:00:06]   [REGULAR in MAGI_Assembly_URDF] Revolute_8
[17:00:06]     parent(occ2): HQpod_Femur path=HQpod_Femur v3:1
[17:00:06]     child(occ1):  MG996R_servo path=MG996R_servo v1:3
[17:00:06]     geometryOrOriginOne: (2.0842, 89.0475, 9.8354) cm
[17:00:06]     geometryOrOriginTwo: (2.0842, 89.0475, 9.8354) cm
[17:00:06]     occ1.transform: (5.5129, 86.8019, 10.3529) cm (ctx_depth=0)
[17:00:06]     occ1.global:    (5.5129, 86.8019, 10.3529) cm
[17:00:06]     occ2.transform: (39.7256, 47.9610, 82.9249) cm (ctx_depth=0)
[17:00:06]     occ2.global:    (39.7256, 47.9610, 82.9249) cm
[17:00:06]  -> origin_global: (0.020842, 0.890475, 0.098354) m [via geometryOrOriginOne]
[17:00:06]     motion: revolute, axis: (-0.697, 0.718, -0.000)
[17:00:06]     rotation limits: [-1.5708, 1.5708] rad
[17:00:06]   WARNING:   regular joint in component 'MAGI_Assembly_URDF v1': failed to read geometry: 'Joint' object has no attribute 'geometry'
[17:00:06]   [REGULAR in MAGI_Assembly_URDF] Rigid_9
[17:00:06]     parent(occ2): MG996R_servo path=MG996R_servo v1:3
[17:00:06]     child(occ1):  HQpod_Tibia_Left path=HQpod_Tibia_Left v3:1
[17:00:06]     geometryOrOriginOne: (0.8551, 86.4265, 7.6949) cm
[17:00:06]     geometryOrOriginTwo: (0.8551, 86.4265, 7.6949) cm
[17:00:06]     occ1.transform: (7.8693, 96.4779, 67.3691) cm (ctx_depth=0)
[17:00:06]     occ1.global:    (7.8693, 96.4779, 67.3691) cm
[17:00:06]     occ2.transform: (5.5129, 86.8019, 10.3529) cm (ctx_depth=0)
[17:00:06]     occ2.global:    (5.5129, 86.8019, 10.3529) cm
[17:00:06]  -> origin_global: (0.008551, 0.864265, 0.076949) m [via geometryOrOriginOne]
[17:00:06]     motion: rigid, axis: (0.000, 0.000, 1.000)
[17:00:06]   WARNING:   regular joint in component 'MAGI_Assembly_URDF v1': failed to read geometry: 'Joint' object has no attribute 'geometry'
[17:00:06]   [REGULAR in MAGI_Assembly_URDF] Rigid_10
[17:00:06]     parent(occ2): HexapodV3Top path=HexapodV3Top v3:1
[17:00:06]     child(occ1):  MG996R_servo path=MG996R_servo v1:4
[17:00:06]     geometryOrOriginOne: (24.7686, 106.0302, 15.1498) cm
[17:00:06]     geometryOrOriginTwo: (24.7686, 106.0302, 15.1498) cm
[17:00:06]     occ1.transform: (28.2688, 108.8232, 12.1750) cm (ctx_depth=0)
[17:00:06]     occ1.global:    (28.2688, 108.8232, 12.1750) cm
[17:00:06]     occ2.transform: (3.8772, -150.0410, -8.9852) cm (ctx_depth=0)
[17:00:06]     occ2.global:    (3.8772, -150.0410, -8.9852) cm
[17:00:06]  -> origin_global: (0.247686, 1.060302, 0.151498) m [via geometryOrOriginOne]
[17:00:06]     motion: rigid, axis: (0.000, 0.000, 1.000)
[17:00:06]   WARNING:   regular joint in component 'MAGI_Assembly_URDF v1': failed to read geometry: 'Joint' object has no attribute 'geometry'
[17:00:06]   [REGULAR in MAGI_Assembly_URDF] Rigid_11
[17:00:06]     parent(occ2): MG996R_servo path=MG996R_servo v1:4
[17:00:06]     child(occ1):  HQpod_Coxal_Right_v2 path=HQpod_Coxal_Right_v2 v2:1
[17:00:06]     geometryOrOriginOne: (27.5370, 108.0914, 16.1744) cm
[17:00:06]     geometryOrOriginTwo: (27.5370, 108.0914, 16.1744) cm
[17:00:06]     occ1.transform: (45.1506, 130.3633, 79.3772) cm (ctx_depth=0)
[17:00:06]     occ1.global:    (45.1506, 130.3633, 79.3772) cm
[17:00:06]     occ2.transform: (28.2688, 108.8232, 12.1750) cm (ctx_depth=0)
[17:00:06]     occ2.global:    (28.2688, 108.8232, 12.1750) cm
[17:00:06]  -> origin_global: (0.275370, 1.080914, 0.161744) m [via geometryOrOriginOne]
[17:00:06]     motion: rigid, axis: (0.000, 0.000, 1.000)
[17:00:06]   WARNING:   regular joint in component 'MAGI_Assembly_URDF v1': failed to read geometry: 'Joint' object has no attribute 'geometry'
[17:00:06]   [REGULAR in MAGI_Assembly_URDF] Revolute_12
[17:00:06]     parent(occ2): MG996R_servo path=MG996R_servo v1:4
[17:00:06]     child(occ1):  HQpod_Coxal_Left_v2 path=HQpod_Coxal_Left_v2 v2:3
[17:00:06]     geometryOrOriginOne: (27.5370, 108.0914, 16.1744) cm
[17:00:06]     geometryOrOriginTwo: (27.5370, 108.0914, 16.1744) cm
[17:00:06]     occ1.transform: (78.1262, 137.1194, 79.1767) cm (ctx_depth=0)
[17:00:06]     occ1.global:    (78.1262, 137.1194, 79.1767) cm
[17:00:06]     occ2.transform: (28.2688, 108.8232, 12.1750) cm (ctx_depth=0)
[17:00:06]     occ2.global:    (28.2688, 108.8232, 12.1750) cm
[17:00:06]  -> origin_global: (0.275370, 1.080914, 0.161744) m [via geometryOrOriginOne]
[17:00:06]     motion: revolute, axis: (-0.000, 0.000, 1.000)
[17:00:06]     rotation limits: [-0.3840, 1.5708] rad
[17:00:06]   WARNING:   regular joint in component 'MAGI_Assembly_URDF v1': failed to read geometry: 'Joint' object has no attribute 'geometry'
[17:00:06]   [REGULAR in MAGI_Assembly_URDF] Rigid_13
[17:00:06]     parent(occ2): HQpod_Coxal_Left_v2 path=HQpod_Coxal_Left_v2 v2:3
[17:00:06]     child(occ1):  MG996R_servo path=MG996R_servo v1:6
[17:00:06]     geometryOrOriginOne: (31.5796, 111.0432, 11.3445) cm
[17:00:06]     geometryOrOriginTwo: (31.5796, 111.0432, 11.3445) cm
[17:00:06]     occ1.transform: (29.1039, 112.8759, 11.7246) cm (ctx_depth=0)
[17:00:06]     occ1.global:    (29.1039, 112.8759, 11.7246) cm
[17:00:06]     occ2.transform: (78.1262, 137.1194, 79.1767) cm (ctx_depth=0)
[17:00:06]     occ2.global:    (78.1262, 137.1194, 79.1767) cm
[17:00:06]  -> origin_global: (0.315796, 1.110432, 0.113445) m [via geometryOrOriginOne]
[17:00:06]     motion: rigid, axis: (0.000, 0.000, 1.000)
[17:00:06]   WARNING:   regular joint in component 'MAGI_Assembly_URDF v1': failed to read geometry: 'Joint' object has no attribute 'geometry'
[17:00:06]   [REGULAR in MAGI_Assembly_URDF] Revolute_14
[17:00:06]     parent(occ2): MG996R_servo path=MG996R_servo v1:6
[17:00:06]     child(occ1):  HQpod_Femur path=HQpod_Femur v3:2
[17:00:06]     geometryOrOriginOne: (31.8895, 110.0061, 12.7595) cm
[17:00:06]     geometryOrOriginTwo: (31.8895, 110.0061, 12.7595) cm
[17:00:06]     occ1.transform: (-8.0593, 148.8554, -60.3287) cm (ctx_depth=0)
[17:00:06]     occ1.global:    (-8.0593, 148.8554, -60.3287) cm
[17:00:06]     occ2.transform: (29.1039, 112.8759, 11.7246) cm (ctx_depth=0)
[17:00:06]     occ2.global:    (29.1039, 112.8759, 11.7246) cm
[17:00:06]  -> origin_global: (0.318895, 1.100061, 0.127595) m [via geometryOrOriginOne]
[17:00:06]     motion: revolute, axis: (0.697, -0.718, -0.000)
[17:00:06]     rotation limits: [-1.3963, 0.9599] rad
[17:00:06]   WARNING:   regular joint in component 'MAGI_Assembly_URDF v1': failed to read geometry: 'Joint' object has no attribute 'geometry'
[17:00:06]   [REGULAR in MAGI_Assembly_URDF] Revolute_15
[17:00:06]     parent(occ2): HQpod_Femur path=HQpod_Femur v3:2
[17:00:06]     child(occ1):  MG996R_servo path=MG996R_servo v1:7
[17:00:06]     geometryOrOriginOne: (35.5213, 113.5315, 9.8256) cm
[17:00:06]     geometryOrOriginTwo: (35.5213, 113.5315, 9.8256) cm
[17:00:06]     occ1.transform: (32.0926, 115.7770, 10.3431) cm (ctx_depth=0)
[17:00:06]     occ1.global:    (32.0926, 115.7770, 10.3431) cm
[17:00:06]     occ2.transform: (-8.0593, 148.8554, -60.3287) cm (ctx_depth=0)
[17:00:06]     occ2.global:    (-8.0593, 148.8554, -60.3287) cm
[17:00:06]  -> origin_global: (0.355213, 1.135315, 0.098256) m [via geometryOrOriginOne]
[17:00:06]     motion: revolute, axis: (0.697, -0.718, -0.000)
[17:00:06]     rotation limits: [-1.5708, 1.5708] rad
[17:00:06]   WARNING:   regular joint in component 'MAGI_Assembly_URDF v1': failed to read geometry: 'Joint' object has no attribute 'geometry'
[17:00:06]   [REGULAR in MAGI_Assembly_URDF] Rigid_16
[17:00:06]     parent(occ2): MG996R_servo path=MG996R_servo v1:7
[17:00:06]     child(occ1):  HQpod_Tibia_Left path=HQpod_Tibia_Left v3:2
[17:00:06]     geometryOrOriginOne: (36.7504, 116.1524, 7.6851) cm
[17:00:06]     geometryOrOriginTwo: (36.7504, 116.1524, 7.6851) cm
[17:00:06]     occ1.transform: (29.7362, 106.1010, 67.3593) cm (ctx_depth=0)
[17:00:06]     occ1.global:    (29.7362, 106.1010, 67.3593) cm
[17:00:06]     occ2.transform: (32.0926, 115.7770, 10.3431) cm (ctx_depth=0)
[17:00:06]     occ2.global:    (32.0926, 115.7770, 10.3431) cm
[17:00:06]  -> origin_global: (0.367504, 1.161524, 0.076851) m [via geometryOrOriginOne]
[17:00:06]     motion: rigid, axis: (0.000, 0.000, 1.000)
[17:00:06]   WARNING:   regular joint in component 'MAGI_Assembly_URDF v1': failed to read geometry: 'Joint' object has no attribute 'geometry'
[17:00:06]   [REGULAR in MAGI_Assembly_URDF] Rigid_17
[17:00:06]     parent(occ2): HexapodV3Top path=HexapodV3Top v3:1
[17:00:06]     child(occ1):  MG996R_servo path=MG996R_servo v1:8
[17:00:06]     geometryOrOriginOne: (28.9019, 93.7603, 15.1498) cm
[17:00:06]     geometryOrOriginTwo: (28.9019, 93.7603, 15.1498) cm
[17:00:06]     occ1.transform: (28.2795, 93.6755, 12.1104) cm (ctx_depth=0)
[17:00:06]     occ1.global:    (28.2795, 93.6755, 12.1104) cm
[17:00:06]     occ2.transform: (3.8772, -150.0410, -8.9852) cm (ctx_depth=0)
[17:00:06]     occ2.global:    (3.8772, -150.0410, -8.9852) cm
[17:00:06]  -> origin_global: (0.289019, 0.937603, 0.151498) m [via geometryOrOriginOne]
[17:00:06]     motion: rigid, axis: (0.000, 0.000, 1.000)
[17:00:06]   WARNING:   regular joint in component 'MAGI_Assembly_URDF v1': failed to read geometry: 'Joint' object has no attribute 'geometry'
[17:00:06]   [REGULAR in MAGI_Assembly_URDF] Revolute_18
[17:00:06]     parent(occ2): MG996R_servo path=MG996R_servo v1:8
[17:00:06]     child(occ1):  HQpod_Coxal_Right_v2 path=HQpod_Coxal_Right_v2 v2:2
[17:00:06]     geometryOrOriginOne: (27.5477, 94.4073, 16.1098) cm
[17:00:06]     geometryOrOriginTwo: (27.5477, 94.4073, 16.1098) cm
[17:00:06]     occ1.transform: (55.1768, 87.8564, 79.3126) cm (ctx_depth=0)
[17:00:06]     occ1.global:    (55.1768, 87.8564, 79.3126) cm
[17:00:06]     occ2.transform: (28.2795, 93.6755, 12.1104) cm (ctx_depth=0)
[17:00:06]     occ2.global:    (28.2795, 93.6755, 12.1104) cm
[17:00:06]  -> origin_global: (0.275477, 0.944073, 0.161098) m [via geometryOrOriginOne]
[17:00:06]     motion: revolute, axis: (-0.000, 0.000, 1.000)
[17:00:06]     rotation limits: [-1.5708, 0.3840] rad
[17:00:06]   WARNING:   regular joint in component 'MAGI_Assembly_URDF v1': failed to read geometry: 'Joint' object has no attribute 'geometry'
[17:00:06]   [REGULAR in MAGI_Assembly_URDF] Rigid_19
[17:00:06]     parent(occ2): HQpod_Coxal_Right_v2 path=HQpod_Coxal_Right_v2 v2:2
[17:00:06]     child(occ1):  MG996R_servo path=MG996R_servo v1:9
[17:00:06]     geometryOrOriginOne: (31.5948, 91.4900, 16.1198) cm
[17:00:06]     geometryOrOriginTwo: (31.5948, 91.4900, 16.1198) cm
[17:00:06]     occ1.transform: (29.1741, 89.6900, 11.6699) cm (ctx_depth=0)
[17:00:06]     occ1.global:    (29.1741, 89.6900, 11.6699) cm
[17:00:06]     occ2.transform: (55.1768, 87.8564, 79.3126) cm (ctx_depth=0)
[17:00:06]     occ2.global:    (55.1768, 87.8564, 79.3126) cm
[17:00:06]  -> origin_global: (0.315948, 0.914900, 0.161198) m [via geometryOrOriginOne]
[17:00:06]     motion: rigid, axis: (0.000, 0.000, 1.000)
[17:00:06]   WARNING:   regular joint in component 'MAGI_Assembly_URDF v1': failed to read geometry: 'Joint' object has no attribute 'geometry'
[17:00:06]   [REGULAR in MAGI_Assembly_URDF] Revolute_20
[17:00:06]     parent(occ2): MG996R_servo path=MG996R_servo v1:9
[17:00:06]     child(occ1):  HQpod_Femur path=HQpod_Femur v3:3
[17:00:06]     geometryOrOriginOne: (31.9435, 92.5754, 12.7048) cm
[17:00:06]     geometryOrOriginTwo: (31.9435, 92.5754, 12.7048) cm
[17:00:06]     occ1.transform: (38.4606, 9.1160, 50.6403) cm (ctx_depth=0)
[17:00:06]     occ1.global:    (38.4606, 9.1160, 50.6403) cm
[17:00:06]     occ2.transform: (29.1741, 89.6900, 11.6699) cm (ctx_depth=0)
[17:00:06]     occ2.global:    (29.1741, 89.6900, 11.6699) cm
[17:00:06]  -> origin_global: (0.319435, 0.925754, 0.127048) m [via geometryOrOriginOne]
[17:00:06]     motion: revolute, axis: (0.692, 0.721, -0.000)
[17:00:06]     rotation limits: [-0.9599, 1.3963] rad
[17:00:06]   WARNING:   regular joint in component 'MAGI_Assembly_URDF v1': failed to read geometry: 'Joint' object has no attribute 'geometry'
[17:00:06]   [REGULAR in MAGI_Assembly_URDF] Revolute_21
[17:00:06]     parent(occ2): HQpod_Femur path=HQpod_Femur v3:3
[17:00:06]     child(occ1):  MG996R_servo path=MG996R_servo v1:10
[17:00:06]     geometryOrOriginOne: (35.6024, 89.0636, 9.7883) cm
[17:00:06]     geometryOrOriginTwo: (35.6024, 89.0636, 9.7883) cm
[17:00:06]     occ1.transform: (32.1864, 86.7988, 10.3058) cm (ctx_depth=0)
[17:00:06]     occ1.global:    (32.1864, 86.7988, 10.3058) cm
[17:00:06]     occ2.transform: (38.4606, 9.1160, 50.6403) cm (ctx_depth=0)
[17:00:06]     occ2.global:    (38.4606, 9.1160, 50.6403) cm
[17:00:06]  -> origin_global: (0.356024, 0.890636, 0.097883) m [via geometryOrOriginOne]
[17:00:06]     motion: revolute, axis: (0.692, 0.721, -0.000)
[17:00:06]     rotation limits: [-1.5708, 1.5708] rad
[17:00:06]   WARNING:   regular joint in component 'MAGI_Assembly_URDF v1': failed to read geometry: 'Joint' object has no attribute 'geometry'
[17:00:06]   [REGULAR in MAGI_Assembly_URDF] Rigid_22
[17:00:06]     parent(occ2): MG996R_servo path=MG996R_servo v1:10
[17:00:06]     child(occ1):  HQpod_Tibia_Right path=HQpod_Tibia_Right v4:1
[17:00:06]     geometryOrOriginOne: (37.2070, 86.1034, 8.5138) cm
[17:00:06]     geometryOrOriginTwo: (37.2070, 86.1034, 8.5138) cm
[17:00:06]     occ1.transform: (68.1661, 75.2503, 90.9144) cm (ctx_depth=0)
[17:00:06]     occ1.global:    (68.1661, 75.2503, 90.9144) cm
[17:00:06]     occ2.transform: (32.1864, 86.7988, 10.3058) cm (ctx_depth=0)
[17:00:06]     occ2.global:    (32.1864, 86.7988, 10.3058) cm
[17:00:06]  -> origin_global: (0.372070, 0.861034, 0.085138) m [via geometryOrOriginOne]
[17:00:06]     motion: rigid, axis: (0.000, 0.000, 1.000)
[17:00:06]   WARNING:   regular joint in component 'MAGI_Assembly_URDF v1': failed to read geometry: 'Joint' object has no attribute 'geometry'
[17:00:06]   [REGULAR in MAGI_Assembly_URDF] Revolute_24
[17:00:06]     parent(occ2): MG996R_servo path=MG996R_servo v1:13
[17:00:06]     child(occ1):  HQpod_Coxal_Right_v2 path=HQpod_Coxal_Right_v2 v2:3
[17:00:06]     geometryOrOriginOne: (10.0830, 108.0819, 16.1098) cm
[17:00:06]     geometryOrOriginTwo: (10.0830, 108.0819, 16.1098) cm
[17:00:06]     occ1.transform: (-17.5460, 114.6328, 79.3126) cm (ctx_depth=0)
[17:00:06]     occ1.global:    (-17.5460, 114.6328, 79.3126) cm
[17:00:06]     occ2.transform: (9.3512, 108.8137, 12.1104) cm (ctx_depth=0)
[17:00:06]     occ2.global:    (9.3512, 108.8137, 12.1104) cm
[17:00:06]  -> origin_global: (0.100830, 1.080819, 0.161098) m [via geometryOrOriginOne]
[17:00:06]     motion: revolute, axis: (-0.000, 0.000, 1.000)
[17:00:06]     rotation limits: [-1.5708, 0.5934] rad
[17:00:06]   WARNING:   regular joint in component 'MAGI_Assembly_URDF v1': failed to read geometry: 'Joint' object has no attribute 'geometry'
[17:00:06]   [REGULAR in MAGI_Assembly_URDF] Rigid_25
[17:00:06]     parent(occ2): HQpod_Coxal_Right_v2 path=HQpod_Coxal_Right_v2 v2:3
[17:00:06]     child(occ1):  MG996R_servo path=MG996R_servo v1:12
[17:00:06]     geometryOrOriginOne: (6.7563, 110.3078, 16.1163) cm
[17:00:06]     geometryOrOriginTwo: (6.7563, 110.3078, 16.1163) cm
[17:00:06]     occ1.transform: (8.4555, 112.8003, 11.6664) cm (ctx_depth=0)
[17:00:06]     occ1.global:    (8.4555, 112.8003, 11.6664) cm
[17:00:06]     occ2.transform: (-17.5460, 114.6328, 79.3126) cm (ctx_depth=0)
[17:00:06]     occ2.global:    (-17.5460, 114.6328, 79.3126) cm
[17:00:06]  -> origin_global: (0.067563, 1.103078, 0.161163) m [via geometryOrOriginOne]
[17:00:06]     motion: rigid, axis: (0.000, 0.000, 1.000)
[17:00:06]   WARNING:   regular joint in component 'MAGI_Assembly_URDF v1': failed to read geometry: 'Joint' object has no attribute 'geometry'
[17:00:06]   [REGULAR in MAGI_Assembly_URDF] Revolute_26
[17:00:06]     parent(occ2): MG996R_servo path=MG996R_servo v1:12
[17:00:06]     child(occ1):  HQpod_Femur path=HQpod_Femur v3:4
[17:00:06]     geometryOrOriginOne: (5.6861, 109.9148, 12.7013) cm
[17:00:06]     geometryOrOriginTwo: (5.6861, 109.9148, 12.7013) cm
[17:00:06]     occ1.transform: (-0.8310, 193.3742, 50.6368) cm (ctx_depth=0)
[17:00:06]     occ1.global:    (-0.8310, 193.3742, 50.6368) cm
[17:00:06]     occ2.transform: (8.4555, 112.8003, 11.6664) cm (ctx_depth=0)
[17:00:06]     occ2.global:    (8.4555, 112.8003, 11.6664) cm
[17:00:06]  -> origin_global: (0.056861, 1.099148, 0.127013) m [via geometryOrOriginOne]
[17:00:06]     motion: revolute, axis: (-0.692, -0.721, -0.000)
[17:00:06]     rotation limits: [-0.9599, 1.3963] rad
[17:00:06]   WARNING:   regular joint in component 'MAGI_Assembly_URDF v1': failed to read geometry: 'Joint' object has no attribute 'geometry'
[17:00:06]   [REGULAR in MAGI_Assembly_URDF] Revolute_27
[17:00:06]     parent(occ2): HQpod_Femur path=HQpod_Femur v3:4
[17:00:06]     child(occ1):  MG996R_servo path=MG996R_servo v1:11
[17:00:06]     geometryOrOriginOne: (2.0272, 113.4266, 9.7848) cm
[17:00:06]     geometryOrOriginTwo: (2.0272, 113.4266, 9.7848) cm
[17:00:06]     occ1.transform: (5.4432, 115.6914, 10.3023) cm (ctx_depth=0)
[17:00:06]     occ1.global:    (5.4432, 115.6914, 10.3023) cm
[17:00:06]     occ2.transform: (-0.8310, 193.3742, 50.6368) cm (ctx_depth=0)
[17:00:06]     occ2.global:    (-0.8310, 193.3742, 50.6368) cm
[17:00:06]  -> origin_global: (0.020272, 1.134266, 0.097848) m [via geometryOrOriginOne]
[17:00:06]     motion: revolute, axis: (-0.692, -0.721, -0.000)
[17:00:06]     rotation limits: [-1.5708, 1.5708] rad
[17:00:06]   WARNING:   regular joint in component 'MAGI_Assembly_URDF v1': failed to read geometry: 'Joint' object has no attribute 'geometry'
[17:00:06]   [REGULAR in MAGI_Assembly_URDF] Rigid_29
[17:00:06]     parent(occ2): HexapodV3Top path=HexapodV3Top v3:1
[17:00:06]     child(occ1):  MG996R_servo path=MG996R_servo v1:13
[17:00:06]     geometryOrOriginOne: (9.4360, 109.4360, 15.1498) cm
[17:00:06]     geometryOrOriginTwo: (9.4360, 109.4360, 15.1498) cm
[17:00:06]     occ1.transform: (9.3512, 108.8137, 12.1104) cm (ctx_depth=0)
[17:00:06]     occ1.global:    (9.3512, 108.8137, 12.1104) cm
[17:00:06]     occ2.transform: (3.8772, -150.0410, -8.9852) cm (ctx_depth=0)
[17:00:06]     occ2.global:    (3.8772, -150.0410, -8.9852) cm
[17:00:06]  -> origin_global: (0.094360, 1.094360, 0.151498) m [via geometryOrOriginOne]
[17:00:06]     motion: rigid, axis: (0.000, 0.000, 1.000)
[17:00:06]   WARNING:   regular joint in component 'MAGI_Assembly_URDF v1': failed to read geometry: 'Joint' object has no attribute 'geometry'
[17:00:06]   [REGULAR in MAGI_Assembly_URDF] Rigid_30
[17:00:06]     parent(occ2): MG996R_servo path=MG996R_servo v1:11
[17:00:06]     child(occ1):  HQpod_Tibia_Right path=HQpod_Tibia_Right v4:2
[17:00:06]     geometryOrOriginOne: (0.4851, 116.3269, 8.5603) cm
[17:00:06]     geometryOrOriginTwo: (0.4226, 116.3869, 8.5103) cm
[17:00:06]     occ1.transform: (-30.5643, 127.2667, 90.8881) cm (ctx_depth=0)
[17:00:06]     occ1.global:    (-30.5643, 127.2667, 90.8881) cm
[17:00:06]     occ2.transform: (5.4432, 115.6914, 10.3023) cm (ctx_depth=0)
[17:00:06]     occ2.global:    (5.4432, 115.6914, 10.3023) cm
[17:00:06]  -> origin_global: (0.004851, 1.163269, 0.085603) m [via geometryOrOriginOne]
[17:00:06]     motion: rigid, axis: (0.000, 0.000, 1.000)
[17:00:06]   Extracted 27 unique joints
[17:00:06] 
=== EXTRACTION: RIGID GROUPS ===
[17:00:06]   Rigid Group 23: ['HQpod_Tibia_Right', 'MG996R_servo', 'MG996R_servo', 'HQpod_Coxal_Right_v2', 'MG996R_servo', 'HQpod_Femur']
[17:00:06]   Extracted 1 rigid groups
[17:00:06] 
=== EXTRACTION SUMMARY ===
[17:00:06]   Occurrences: 28 (0 subassemblies, 28 leaf components)
[17:00:06]   Joints: 27 (0 as-built, 27 regular)
[17:00:06]   Max nesting depth: 0
[17:00:36] 
=== PHASE 1: DEBUG DATA ===
[17:00:36]   extraction_report.md
[17:00:36]   snapshot.json
[17:00:36]   fusion_transforms.json
[17:00:36] 
=== PHASE 2: BUILD ROBOT MODEL ===
[17:00:36] 
=== MODEL: ASSEMBLY HIERARCHY ===
[17:00:36]   Assembly: MAGI_Assembly_URDF (synthetic root, wraps design-root leaves so phase 2 has a macro to xacro:include)
[17:00:36]   base_link → MAGI_Assembly_URDF
[17:00:36]   HexapodV3Mid → MAGI_Assembly_URDF
[17:00:36]   HexapodV3Top → MAGI_Assembly_URDF
[17:00:36]   MG996R_servo → MAGI_Assembly_URDF
[17:00:36]   HQpod_Coxal_Left_v2 → MAGI_Assembly_URDF
[17:00:36]   MG996R_servo → MAGI_Assembly_URDF
[17:00:36]   HQpod_Femur → MAGI_Assembly_URDF
[17:00:36]   MG996R_servo → MAGI_Assembly_URDF
[17:00:36]   HQpod_Tibia_Left → MAGI_Assembly_URDF
[17:00:36]   MG996R_servo → MAGI_Assembly_URDF
[17:00:36]   HQpod_Coxal_Left_v2 → MAGI_Assembly_URDF
[17:00:36]   MG996R_servo → MAGI_Assembly_URDF
[17:00:36]   HQpod_Femur → MAGI_Assembly_URDF
[17:00:36]   MG996R_servo → MAGI_Assembly_URDF
[17:00:36]   HQpod_Tibia_Left → MAGI_Assembly_URDF
[17:00:36]   MG996R_servo → MAGI_Assembly_URDF
[17:00:36]   HQpod_Coxal_Right_v2 → MAGI_Assembly_URDF
[17:00:36]   MG996R_servo → MAGI_Assembly_URDF
[17:00:36]   HQpod_Femur → MAGI_Assembly_URDF
[17:00:36]   MG996R_servo → MAGI_Assembly_URDF
[17:00:36]   HQpod_Tibia_Right → MAGI_Assembly_URDF
[17:00:36]   HQpod_Tibia_Right → MAGI_Assembly_URDF
[17:00:36]   MG996R_servo → MAGI_Assembly_URDF
[17:00:36]   HQpod_Femur → MAGI_Assembly_URDF
[17:00:36]   MG996R_servo → MAGI_Assembly_URDF
[17:00:36]   HQpod_Coxal_Right_v2 → MAGI_Assembly_URDF
[17:00:36]   MG996R_servo → MAGI_Assembly_URDF
[17:00:36]   HQpod_Coxal_Right_v2 → MAGI_Assembly_URDF
[17:00:36] 
=== MODEL: RIGID GROUP MERGE ===
[17:00:36]   Rigid Group 23: anchor=HQpod_Coxal_Right_v2 merged_name=HQpod_Coxal_Right_v2 members=6 mass=1162.03 g bbox=(186.0 × 218.8 × 56.1) mm
[17:00:36]   Rigid Group 23: dropped MAGI_Assembly_URDF/HQpod_Tibia_Right (HQpod_Tibia_Right v4:1) -> MAGI_Assembly_URDF/HQpod_Coxal_Right_v2
[17:00:36]   Rigid Group 23: dropped MAGI_Assembly_URDF/MG996R_servo (MG996R_servo v1:10) -> MAGI_Assembly_URDF/HQpod_Coxal_Right_v2
[17:00:36]   Rigid Group 23: dropped MAGI_Assembly_URDF/MG996R_servo (MG996R_servo v1:9) -> MAGI_Assembly_URDF/HQpod_Coxal_Right_v2
[17:00:36]   Rigid Group 23: dropped MAGI_Assembly_URDF/MG996R_servo (MG996R_servo v1:8) -> MAGI_Assembly_URDF/HQpod_Coxal_Right_v2
[17:00:36]   Rigid Group 23: dropped MAGI_Assembly_URDF/HQpod_Femur (HQpod_Femur v3:3) -> MAGI_Assembly_URDF/HQpod_Coxal_Right_v2
[17:00:36]   No auto rigid islands found
[17:00:36] 
=== MODEL: RESOLVE JOINT PATHS ===
[17:00:36]   Rigid_1              MAGI_Assembly_URDF/base_link → MAGI_Assembly_URDF/HexapodV3Mid  [rigid] internal
[17:00:36]   Rigid_2              MAGI_Assembly_URDF/HexapodV3Mid → MAGI_Assembly_URDF/HexapodV3Top  [rigid] internal
[17:00:36]   Rigid_4              MAGI_Assembly_URDF/HexapodV3Top → MAGI_Assembly_URDF/MG996R_servo  [rigid] internal
[17:00:36]   Revolute_5           MAGI_Assembly_URDF/MG996R_servo → MAGI_Assembly_URDF/HQpod_Coxal_Left_v2  [revolute] internal
[17:00:36]   Rigid_6              MAGI_Assembly_URDF/HQpod_Coxal_Left_v2 → MAGI_Assembly_URDF/MG996R_servo  [rigid] internal
[17:00:36]   Revolute_7           MAGI_Assembly_URDF/MG996R_servo → MAGI_Assembly_URDF/HQpod_Femur  [revolute] internal
[17:00:36]   Revolute_8           MAGI_Assembly_URDF/HQpod_Femur → MAGI_Assembly_URDF/MG996R_servo  [revolute] internal
[17:00:36]   Rigid_9              MAGI_Assembly_URDF/MG996R_servo → MAGI_Assembly_URDF/HQpod_Tibia_Left  [rigid] internal
[17:00:36]   Rigid_10             MAGI_Assembly_URDF/HexapodV3Top → MAGI_Assembly_URDF/MG996R_servo  [rigid] internal
[17:00:36]   Rigid_11             MAGI_Assembly_URDF/MG996R_servo → MAGI_Assembly_URDF/HQpod_Coxal_Right_v2  [rigid] internal
[17:00:36]   Revolute_12          MAGI_Assembly_URDF/MG996R_servo → MAGI_Assembly_URDF/HQpod_Coxal_Left_v2  [revolute] internal
[17:00:36]   Rigid_13             MAGI_Assembly_URDF/HQpod_Coxal_Left_v2 → MAGI_Assembly_URDF/MG996R_servo  [rigid] internal
[17:00:36]   Revolute_14          MAGI_Assembly_URDF/MG996R_servo → MAGI_Assembly_URDF/HQpod_Femur  [revolute] internal
[17:00:36]   Revolute_15          MAGI_Assembly_URDF/HQpod_Femur → MAGI_Assembly_URDF/MG996R_servo  [revolute] internal
[17:00:36]   Rigid_16             MAGI_Assembly_URDF/MG996R_servo → MAGI_Assembly_URDF/HQpod_Tibia_Left  [rigid] internal
[17:00:36]   Rigid_17             MAGI_Assembly_URDF/HexapodV3Top → MAGI_Assembly_URDF/HQpod_Coxal_Right_v2  [rigid] internal
[17:00:36]   WARNING:   Revolute_18: Joint 'Revolute_18' is internal to a rigid group (both endpoints → MAGI_Assembly_URDF/HQpod_Coxal_Right_v2).  Dropped — rigid groups represent one rigid body, joints between members are ignored.  Move this joint to assemble between rigid groups instead.
[17:00:36]   Rigid_19: internal rigid joint inside rigid group MAGI_Assembly_URDF/HQpod_Coxal_Right_v2; dropped as redundant
[17:00:36]   WARNING:   Revolute_20: Joint 'Revolute_20' is internal to a rigid group (both endpoints → MAGI_Assembly_URDF/HQpod_Coxal_Right_v2).  Dropped — rigid groups represent one rigid body, joints between members are ignored.  Move this joint to assemble between rigid groups instead.
[17:00:36]   WARNING:   Revolute_21: Joint 'Revolute_21' is internal to a rigid group (both endpoints → MAGI_Assembly_URDF/HQpod_Coxal_Right_v2).  Dropped — rigid groups represent one rigid body, joints between members are ignored.  Move this joint to assemble between rigid groups instead.
[17:00:36]   Rigid_22: internal rigid joint inside rigid group MAGI_Assembly_URDF/HQpod_Coxal_Right_v2; dropped as redundant
[17:00:36]   Revolute_24          MAGI_Assembly_URDF/MG996R_servo → MAGI_Assembly_URDF/HQpod_Coxal_Right_v2  [revolute] internal
[17:00:36]   Rigid_25             MAGI_Assembly_URDF/HQpod_Coxal_Right_v2 → MAGI_Assembly_URDF/MG996R_servo  [rigid] internal
[17:00:36]   Revolute_26          MAGI_Assembly_URDF/MG996R_servo → MAGI_Assembly_URDF/HQpod_Femur  [revolute] internal
[17:00:36]   Revolute_27          MAGI_Assembly_URDF/HQpod_Femur → MAGI_Assembly_URDF/MG996R_servo  [revolute] internal
[17:00:36]   Rigid_29             MAGI_Assembly_URDF/HexapodV3Top → MAGI_Assembly_URDF/MG996R_servo  [rigid] internal
[17:00:36]   Rigid_30             MAGI_Assembly_URDF/MG996R_servo → MAGI_Assembly_URDF/HQpod_Tibia_Right  [rigid] internal
[17:00:36] 
=== MODEL: DETECT ROOT ===
[17:00:36]   Parent-only nodes: 1
[17:00:36]     MAGI_Assembly_URDF/base_link
[17:00:36]   → Root: MAGI_Assembly_URDF/base_link
[17:00:36] 
=== MODEL: RESOLVE NAMES ===
[17:00:36]   Name collisions: {'MG996R_servo', 'HQpod_Coxal_Left_v2', 'HQpod_Femur', 'HQpod_Tibia_Left', 'HQpod_Coxal_Right_v2'}
[17:00:36]   HQpod_Coxal_Left_v2 (MAGI_Assembly_URDF) → MAGI_Assembly_URDF_HQpod_Coxal_Left_v2
[17:00:36]   HQpod_Coxal_Left_v2 (MAGI_Assembly_URDF) → MAGI_Assembly_URDF_HQpod_Coxal_Left_v2_2
[17:00:36]   HQpod_Coxal_Right_v2 (MAGI_Assembly_URDF) → MAGI_Assembly_URDF_HQpod_Coxal_Right_v2
[17:00:36]   HQpod_Coxal_Right_v2 (MAGI_Assembly_URDF) → MAGI_Assembly_URDF_HQpod_Coxal_Right_v2_2
[17:00:36]   HQpod_Coxal_Right_v2 (MAGI_Assembly_URDF) → MAGI_Assembly_URDF_HQpod_Coxal_Right_v2_3
[17:00:36]   HQpod_Femur (MAGI_Assembly_URDF) → MAGI_Assembly_URDF_HQpod_Femur
[17:00:36]   HQpod_Femur (MAGI_Assembly_URDF) → MAGI_Assembly_URDF_HQpod_Femur_2
[17:00:36]   HQpod_Femur (MAGI_Assembly_URDF) → MAGI_Assembly_URDF_HQpod_Femur_3
[17:00:36]   HQpod_Tibia_Left (MAGI_Assembly_URDF) → MAGI_Assembly_URDF_HQpod_Tibia_Left
[17:00:36]   HQpod_Tibia_Left (MAGI_Assembly_URDF) → MAGI_Assembly_URDF_HQpod_Tibia_Left_2
[17:00:36]   HQpod_Tibia_Right (MAGI_Assembly_URDF) → HQpod_Tibia_Right
[17:00:36]   HexapodV3Mid (MAGI_Assembly_URDF) → HexapodV3Mid
[17:00:36]   HexapodV3Top (MAGI_Assembly_URDF) → HexapodV3Top
[17:00:36]   MG996R_servo (MAGI_Assembly_URDF) → MAGI_Assembly_URDF_MG996R_servo
[17:00:36]   MG996R_servo (MAGI_Assembly_URDF) → MAGI_Assembly_URDF_MG996R_servo_2
[17:00:36]   MG996R_servo (MAGI_Assembly_URDF) → MAGI_Assembly_URDF_MG996R_servo_3
[17:00:36]   MG996R_servo (MAGI_Assembly_URDF) → MAGI_Assembly_URDF_MG996R_servo_4
[17:00:36]   MG996R_servo (MAGI_Assembly_URDF) → MAGI_Assembly_URDF_MG996R_servo_5
[17:00:36]   MG996R_servo (MAGI_Assembly_URDF) → MAGI_Assembly_URDF_MG996R_servo_6
[17:00:36]   MG996R_servo (MAGI_Assembly_URDF) → MAGI_Assembly_URDF_MG996R_servo_7
[17:00:36]   MG996R_servo (MAGI_Assembly_URDF) → MAGI_Assembly_URDF_MG996R_servo_8
[17:00:36]   MG996R_servo (MAGI_Assembly_URDF) → MAGI_Assembly_URDF_MG996R_servo_9
[17:00:36]   base_link (MAGI_Assembly_URDF) → base_link
[17:00:36]   Root link URDF name: base_link
[17:00:36] 
=== MODEL: BUILD LINKS ===
[17:00:36]   MAGI_Assembly_URDF_HQpod_Coxal_Right_v2_2: MERGED (6 members) mass=1162.03 g
[17:00:36]   Built 23 links
[17:00:36] 
=== MODEL: BUILD JOINTS ===
[17:00:36]   NOTE: joint origin rpy derived from child occurrence's transform2 rotation (was hardcoded 0,0,0 pre-2026-04-13)
[17:00:36]   Rigid_1: base_link → HexapodV3Mid [fixed]
[17:00:36]     origin_xyz: (0.113207, 1.351156, -0.242000) m [child_minus_parent]
[17:00:36]     origin_global: (0.210233, 2.405051, -0.093500) m
[17:00:36]   Rigid_2: HexapodV3Mid → HexapodV3Top [fixed]
[17:00:36]     origin_xyz: (-0.074434, -2.851566, 0.152148) m [child_minus_parent]
[17:00:36]     origin_global: (0.135798, -0.529120, 0.061646) m
[17:00:36]   Rigid_4: joint origin rpy = (1.570796, -0.000000, 0.785398) rad (+90.00°, -0.00°, +45.00°) [from child transform2 rotation]
[17:00:36]   Rigid_4: HexapodV3Top → MAGI_Assembly_URDF_MG996R_servo [fixed]
[17:00:36]     origin_xyz: (0.054925, 2.437386, 0.211602) m [child_minus_parent]
[17:00:36]     origin_global: (0.291826, 0.920854, 1.086656) m
[17:00:36]   Rigid_10: joint origin rpy = (1.570796, 0.000000, -2.356194) rad (+90.00°, +0.00°, -135.00°) [from child transform2 rotation]
[17:00:36]   Rigid_10: HexapodV3Top → MAGI_Assembly_URDF_MG996R_servo_7 [fixed]
[17:00:36]     origin_xyz: (0.243915, 2.588642, 0.211602) m [child_minus_parent]
[17:00:36]     origin_global: (0.000422, 1.020217, 1.182052) m
[17:00:36]   Rigid_17: joint origin rpy = (-1.154975, 1.570793, 2.792527) rad (-66.18°, +90.00°, +160.00°) [from child transform2 rotation]
[17:00:36]   Rigid_17: HexapodV3Top → MAGI_Assembly_URDF_HQpod_Coxal_Right_v2_2 [fixed]
[17:00:36]     origin_xyz: (0.512995, 2.378974, 0.882978) m [child_minus_parent]
[17:00:36]     origin_global: (1.123304, 0.120016, 0.504104) m
[17:00:36]   Rigid_29: joint origin rpy = (1.570796, -0.000000, -0.785398) rad (+90.00°, -0.00°, -45.00°) [from child transform2 rotation]
[17:00:36]   Rigid_29: HexapodV3Top → MAGI_Assembly_URDF_MG996R_servo_4 [fixed]
[17:00:36]     origin_xyz: (0.054739, 2.588547, 0.210956) m [child_minus_parent]
[17:00:36]     origin_global: (0.053109, 0.914289, 1.215464) m
[17:00:36]   Revolute_5: mesh bake offset = (-101.01, -944.29, -161.74) mm [child-local frame]
[17:00:36]   Revolute_5: joint origin rpy = (0.014889, -0.000012, -1.570790) rad (+0.85°, -0.00°, -90.00°) [from child transform2 rotation]
[17:00:36]   Revolute_5: origin_xyz rotated into parent-local frame: (0.291665, 0.258679, 0.569011) → (0.389152, 0.569011, 0.023325) m
[17:00:36]  Revolute_5: axis remapped world -> joint/child frame: (-0.000, 0.000, 1.000) -> (-1.000, 0.000, 0.000)
[17:00:36]   Revolute_5: MAGI_Assembly_URDF_MG996R_servo → MAGI_Assembly_URDF_HQpod_Coxal_Left_v2 [revolute]
[17:00:36]     origin_xyz: (0.389152, 0.569011, 0.023325) m [joint_minus_parent]
[17:00:36]     origin_global: (0.385362, 1.195655, 0.690761) m
[17:00:36]   Rigid_11: joint origin rpy = (-2.725771, 0.000000, -1.570793) rad (-156.18°, +0.00°, -90.00°) [from child transform2 rotation]
[17:00:36]   Rigid_11: origin_xyz rotated into parent-local frame: (0.168819, 0.215401, 0.672022) → (-0.271684, 0.672022, 0.032938) m
[17:00:36]   Rigid_11: MAGI_Assembly_URDF_MG996R_servo_7 → MAGI_Assembly_URDF_HQpod_Coxal_Right_v2 [fixed]
[17:00:36]     origin_xyz: (-0.271684, 0.672022, 0.032938) m [child_minus_parent]
[17:00:36]     origin_global: (1.517862, 1.543257, 0.518399) m
[17:00:36]   Revolute_12: mesh bake offset = (-275.37, -1080.91, -161.74) mm [child-local frame]
[17:00:36]   Revolute_12: joint origin rpy = (0.014889, -0.000012, -1.570790) rad (+0.85°, -0.00°, -90.00°) [from child transform2 rotation]
[17:00:36]   Revolute_12: origin_xyz rotated into parent-local frame: (-0.389700, -0.353834, 0.394657) → (0.525758, 0.394657, 0.025361) m
[17:00:36]  Revolute_12: axis remapped world -> joint/child frame: (-0.000, 0.000, 1.000) -> (-1.000, 0.000, 0.000)
[17:00:36]   Revolute_12: MAGI_Assembly_URDF_MG996R_servo_7 → MAGI_Assembly_URDF_HQpod_Coxal_Left_v2_2 [revolute]
[17:00:36]     origin_xyz: (0.525758, 0.394657, 0.025361) m [joint_minus_parent]
[17:00:36]     origin_global: (-0.107012, 0.734398, 0.516407) m
[17:00:36]   Revolute_24: mesh bake offset = (-100.83, -1080.82, -161.10) mm [child-local frame]
[17:00:36]   Revolute_24: joint origin rpy = (3.121082, 0.000002, -1.570793) rad (+178.82°, +0.00°, -90.00°) [from child transform2 rotation]
[17:00:36]   Revolute_24: origin_xyz rotated into parent-local frame: (-0.937187, 0.922836, 0.571189) → (-1.315235, 0.571189, 0.010147) m
[17:00:36]  Revolute_24: axis remapped world -> joint/child frame: (-0.000, 0.000, 1.000) -> (-1.000, -0.000, 0.000)
[17:00:36]   Revolute_24: MAGI_Assembly_URDF_MG996R_servo_4 → MAGI_Assembly_URDF_HQpod_Coxal_Right_v2_3 [revolute]
[17:00:36]     origin_xyz: (-1.315235, 0.571189, 0.010147) m [joint_minus_parent]
[17:00:36]     origin_global: (-0.843675, 2.010973, 0.692293) m
[17:00:36]   Rigid_6: parent bake correction += (-790.24, -541.64, 101.01) mm [world frame]
[17:00:36]   Rigid_6: joint origin rpy = (-1.570796, 0.000001, -3.141593) rad (-90.00°, +0.00°, -180.00°) [from child transform2 rotation]
[17:00:36]   Rigid_6: origin_xyz rotated into parent-local frame: (-0.300345, -0.298625, -0.573417) → (0.573414, -0.423511, 0.005083) m
[17:00:36]   Rigid_6: MAGI_Assembly_URDF_HQpod_Coxal_Left_v2 → MAGI_Assembly_URDF_MG996R_servo_5 [fixed]
[17:00:36]     origin_xyz: (0.573414, -0.423511, 0.005083) m [child_minus_parent]
[17:00:36]     origin_global: (-0.668339, 1.440794, 0.178041) m
[17:00:36]   Rigid_13: parent bake correction += (888.27, 636.80, 275.36) mm [world frame]
[17:00:36]   Rigid_13: joint origin rpy = (-1.570796, 0.000001, -3.141593) rad (-90.00°, +0.00°, -180.00°) [from child transform2 rotation]
[17:00:36]   Rigid_13: origin_xyz rotated into parent-local frame: (0.398051, 0.394361, -0.399161) → (0.399157, -0.560299, 0.005729) m
[17:00:36]   Rigid_13: MAGI_Assembly_URDF_HQpod_Coxal_Left_v2_2 → MAGI_Assembly_URDF_MG996R_servo_8 [fixed]
[17:00:36]     origin_xyz: (0.399157, -0.560299, 0.005729) m [child_minus_parent]
[17:00:36]     origin_global: (1.145863, 0.410975, 0.433028) m
[17:00:36]   Rigid_25: parent bake correction += (668.21, -864.64, 100.83) mm [world frame]
[17:00:36]   Rigid_25: joint origin rpy = (-1.570795, 0.000001, -3.141593) rad (-90.00°, +0.00°, -180.00°) [from child transform2 rotation]
[17:00:36]   Rigid_25: origin_xyz rotated into parent-local frame: (0.928230, -0.882970, -0.575629) → (0.575633, -1.281097, 0.005729) m
[17:00:36]   Rigid_25: MAGI_Assembly_URDF_HQpod_Coxal_Right_v2_3 → MAGI_Assembly_URDF_MG996R_servo_3 [fixed]
[17:00:36]     origin_xyz: (0.575633, -1.281097, 0.005729) m [child_minus_parent]
[17:00:36]     origin_global: (-0.563005, 0.220576, 0.184225) m
[17:00:36]   Revolute_7: mesh bake offset = (-57.16, -925.73, -127.69) mm [child-local frame]
[17:00:36]   Revolute_7: joint origin rpy = (-1.570796, 1.047198, 0.000000) rad (-90.00°, +60.00°, +0.00°) [from child transform2 rotation]
[17:00:36]   Revolute_7: origin_xyz rotated into parent-local frame: (0.590963, 0.031068, -0.061216) → (-0.061224, -0.389313, -0.445687) m
[17:00:36]  Revolute_7: axis remapped world -> joint/child frame: (-0.697, 0.718, -0.000) -> (-0.000, 0.000, 1.000)
[17:00:36]   Revolute_7: MAGI_Assembly_URDF_MG996R_servo_5 → MAGI_Assembly_URDF_HQpod_Femur [revolute]
[17:00:36]     origin_xyz: (-0.061224, -0.389313, -0.445687) m [joint_minus_parent]
[17:00:36]     origin_global: (0.675981, 0.928098, 0.056128) m
[17:00:36]   Revolute_14: mesh bake offset = (-318.89, -1100.06, -127.59) mm [child-local frame]
[17:00:36]   Revolute_14: joint origin rpy = (1.570796, -1.047198, 3.141593) rad (+90.00°, -60.00°, +180.00°) [from child transform2 rotation]
[17:00:36]   Revolute_14: origin_xyz rotated into parent-local frame: (0.310094, 0.843685, 0.072694) → (0.072694, -0.389411, 0.810137) m
[17:00:36]  Revolute_14: axis remapped world -> joint/child frame: (0.697, -0.718, -0.000) -> (0.000, -0.000, 1.000)
[17:00:36]   Revolute_14: MAGI_Assembly_URDF_MG996R_servo_8 → MAGI_Assembly_URDF_HQpod_Femur_2 [revolute]
[17:00:36]     origin_xyz: (0.072694, -0.389411, 0.810137) m [joint_minus_parent]
[17:00:36]     origin_global: (0.601133, 1.972444, 0.189940) m
[17:00:36]   Revolute_26: mesh bake offset = (-56.86, -1099.15, -127.01) mm [child-local frame]
[17:00:36]   Revolute_26: joint origin rpy = (1.570796, 1.047198, -3.141593) rad (+90.00°, +60.00°, -180.00°) [from child transform2 rotation]
[17:00:36]   Revolute_26: origin_xyz rotated into parent-local frame: (0.180158, 0.367647, -0.590615) → (-0.590615, -0.389993, -0.124604) m
[17:00:36]  Revolute_26: axis remapped world -> joint/child frame: (-0.692, -0.721, -0.000) -> (-0.000, -0.000, 1.000)
[17:00:36]   Revolute_26: MAGI_Assembly_URDF_MG996R_servo_3 → MAGI_Assembly_URDF_HQpod_Femur_3 [revolute]
[17:00:36]     origin_xyz: (-0.590615, -0.389993, -0.124604) m [joint_minus_parent]
[17:00:36]     origin_global: (0.264713, 1.495650, -0.473951) m
[17:00:36]   Revolute_8: mesh bake offset = (-20.84, -890.47, -98.35) mm [child-local frame]
[17:00:36]   Revolute_8: parent bake correction += (-278.72, -448.49, 773.12) mm [world frame]
[17:00:36]   Revolute_8: joint origin rpy = (1.570796, 0.000000, -3.141593) rad (+90.00°, +0.00°, -180.00°) [from child transform2 rotation]
[17:00:36]   Revolute_8: origin_xyz rotated into parent-local frame: (-1.218731, 0.600566, -0.048208) → (-0.419186, -0.186374, 1.279788) m
[17:00:36]  Revolute_8: axis remapped world -> joint/child frame: (-0.697, 0.718, -0.000) -> (-0.000, 1.000, 0.000)
[17:00:36]   Revolute_8: MAGI_Assembly_URDF_HQpod_Femur → MAGI_Assembly_URDF_MG996R_servo_6 [revolute]
[17:00:36]     origin_xyz: (-0.419186, -0.186374, 1.279788) m [joint_minus_parent]
[17:00:36]     origin_global: (-0.542750, 1.528664, 0.007920) m
[17:00:36]   Revolute_15: mesh bake offset = (-355.21, -1135.31, -98.26) mm [child-local frame]
[17:00:36]   Revolute_15: parent bake correction += (-681.73, -483.89, -793.23) mm [world frame]
[17:00:36]   Revolute_15: joint origin rpy = (1.570796, -0.000000, -0.000000) rad (+90.00°, -0.00°, -0.00°) [from child transform2 rotation]
[17:00:36]   Revolute_15: origin_xyz rotated into parent-local frame: (0.696023, -1.449282, -0.349223) → (-0.267059, -0.557417, 1.524726) m
[17:00:36]  Revolute_15: axis remapped world -> joint/child frame: (0.697, -0.718, -0.000) -> (0.000, 1.000, 0.000)
[17:00:36]   Revolute_15: MAGI_Assembly_URDF_HQpod_Femur_2 → MAGI_Assembly_URDF_MG996R_servo_9 [revolute]
[17:00:36]     origin_xyz: (-0.267059, -0.557417, 1.524726) m [joint_minus_parent]
[17:00:36]     origin_global: (1.297156, 0.523162, -0.159284) m
[17:00:36]   Revolute_27: mesh bake offset = (-20.27, -1134.27, -97.85) mm [child-local frame]
[17:00:36]   Revolute_27: parent bake correction += (-273.02, 438.09, 980.32) mm [world frame]
[17:00:36]   Revolute_27: joint origin rpy = (1.570796, -0.000000, 0.000000) rad (+90.00°, -0.00°, +0.00°) [from child transform2 rotation]
[17:00:36]   Revolute_27: origin_xyz rotated into parent-local frame: (-1.043672, -1.111030, 0.651574) → (-0.339967, -0.556097, 1.524259) m
[17:00:36]  Revolute_27: axis remapped world -> joint/child frame: (-0.692, -0.721, -0.000) -> (0.000, 1.000, -0.000)
[17:00:36]   Revolute_27: MAGI_Assembly_URDF_HQpod_Femur_3 → MAGI_Assembly_URDF_MG996R_servo_2 [revolute]
[17:00:36]     origin_xyz: (-0.339967, -0.556097, 1.524259) m [joint_minus_parent]
[17:00:36]     origin_global: (-0.778959, 0.384620, 0.177623) m
[17:00:36]   Rigid_9: parent bake correction += (597.88, -660.64, 95.61) mm [world frame]
[17:00:36]   Rigid_9: joint origin rpy = (1.570796, -1.570796, 0.000000) rad (+90.00°, -90.00°, +0.00°) [from child transform2 rotation]
[17:00:36]   Rigid_9: origin_xyz rotated into parent-local frame: (0.621444, -0.563885, 0.665771) → (-0.378934, -0.837464, -0.549976) m
[17:00:36]   Rigid_9: MAGI_Assembly_URDF_MG996R_servo_6 → MAGI_Assembly_URDF_HQpod_Tibia_Left [fixed]
[17:00:36]     origin_xyz: (-0.378934, -0.837464, -0.549976) m [child_minus_parent]
[17:00:36]     origin_global: (0.672424, 1.433857, 1.098424) m
[17:00:36]   Rigid_16: parent bake correction += (-976.23, 634.61, 262.71) mm [world frame]
[17:00:36]   Rigid_16: joint origin rpy = (1.570796, -1.570796, 0.000000) rad (+90.00°, -90.00°, +0.00°) [from child transform2 rotation]
[17:00:36]   Rigid_16: origin_xyz rotated into parent-local frame: (-0.999793, 0.537848, 0.832876) → (-0.713305, -1.082304, -0.549878) m
[17:00:36]   Rigid_16: MAGI_Assembly_URDF_MG996R_servo_9 → MAGI_Assembly_URDF_HQpod_Tibia_Left_2 [fixed]
[17:00:36]     origin_xyz: (-0.713305, -1.082304, -0.549878) m [child_minus_parent]
[17:00:36]     origin_global: (-0.609810, 0.287554, 0.936096) m
[17:00:36]   Rigid_30: parent bake correction += (833.39, 772.29, -74.60) mm [world frame]
[17:00:36]   Rigid_30: joint origin rpy = (0.000003, -1.570794, 1.570796) rad (+0.00°, -90.00°, +90.00°) [from child transform2 rotation]
[17:00:36]   Rigid_30: origin_xyz rotated into parent-local frame: (0.473316, 0.888047, 0.731258) → (-0.128813, -0.968443, 0.770012) m
[17:00:36]   Rigid_30: MAGI_Assembly_URDF_MG996R_servo_2 → HQpod_Tibia_Right [fixed]
[17:00:36]     origin_xyz: (-0.128813, -0.968443, 0.770012) m [child_minus_parent]
[17:00:36]     origin_global: (0.478698, 0.638516, 1.494720) m
[17:00:36]   Built 22 joints
[17:00:36] 
=== MODEL: VALIDATE ===
[17:00:36]   WARNING: Zero-mass links: ['MAGI_Assembly_URDF_HQpod_Tibia_Left', 'MAGI_Assembly_URDF_HQpod_Tibia_Left_2', 'HQpod_Tibia_Right']
[17:00:36]   Validation passed (4 warnings)
[17:00:36] 
[17:00:36] Kinematic tree:
[17:00:36]   base_link (461g)
[17:00:36]     ─── Rigid_1 [fixed]
[17:00:36]       HexapodV3Mid (431g)
[17:00:36]         ─── Rigid_2 [fixed]
[17:00:36]           HexapodV3Top (1329g)
[17:00:36]             ─── Rigid_4 [fixed]
[17:00:36]               MAGI_Assembly_URDF_MG996R_servo (240g)
[17:00:36]                 ─⟳─ Revolute_5 [revolute]
[17:00:36]                   MAGI_Assembly_URDF_HQpod_Coxal_Left_v2 (266g)
[17:00:36]                     ─── Rigid_6 [fixed]
[17:00:36]                       MAGI_Assembly_URDF_MG996R_servo_5 (240g)
[17:00:36]                         ─⟳─ Revolute_7 [revolute]
[17:00:36]                           MAGI_Assembly_URDF_HQpod_Femur (176g)
[17:00:36]                             ─⟳─ Revolute_8 [revolute]
[17:00:36]                               MAGI_Assembly_URDF_MG996R_servo_6 (240g)
[17:00:36]                                 ─── Rigid_9 [fixed]
[17:00:36]                                   MAGI_Assembly_URDF_HQpod_Tibia_Left (0g)
[17:00:36]             ─── Rigid_10 [fixed]
[17:00:36]               MAGI_Assembly_URDF_MG996R_servo_7 (240g)
[17:00:36]                 ─── Rigid_11 [fixed]
[17:00:36]                   MAGI_Assembly_URDF_HQpod_Coxal_Right_v2 (266g)
[17:00:36]                 ─⟳─ Revolute_12 [revolute]
[17:00:36]                   MAGI_Assembly_URDF_HQpod_Coxal_Left_v2_2 (266g)
[17:00:36]                     ─── Rigid_13 [fixed]
[17:00:36]                       MAGI_Assembly_URDF_MG996R_servo_8 (240g)
[17:00:36]                         ─⟳─ Revolute_14 [revolute]
[17:00:36]                           MAGI_Assembly_URDF_HQpod_Femur_2 (176g)
[17:00:36]                             ─⟳─ Revolute_15 [revolute]
[17:00:36]                               MAGI_Assembly_URDF_MG996R_servo_9 (240g)
[17:00:36]                                 ─── Rigid_16 [fixed]
[17:00:36]                                   MAGI_Assembly_URDF_HQpod_Tibia_Left_2 (0g)
[17:00:36]             ─── Rigid_17 [fixed]
[17:00:36]               MAGI_Assembly_URDF_HQpod_Coxal_Right_v2_2 (1162g) [MERGED]
[17:00:36]             ─── Rigid_29 [fixed]
[17:00:36]               MAGI_Assembly_URDF_MG996R_servo_4 (240g)
[17:00:36]                 ─⟳─ Revolute_24 [revolute]
[17:00:36]                   MAGI_Assembly_URDF_HQpod_Coxal_Right_v2_3 (266g)
[17:00:36]                     ─── Rigid_25 [fixed]
[17:00:36]                       MAGI_Assembly_URDF_MG996R_servo_3 (240g)
[17:00:36]                         ─⟳─ Revolute_26 [revolute]
[17:00:36]                           MAGI_Assembly_URDF_HQpod_Femur_3 (176g)
[17:00:36]                             ─⟳─ Revolute_27 [revolute]
[17:00:36]                               MAGI_Assembly_URDF_MG996R_servo_2 (240g)
[17:00:36]                                 ─── Rigid_30 [fixed]
[17:00:36]                                   HQpod_Tibia_Right (0g)
[17:00:36] 
=== MODEL SUMMARY ===
[17:00:36]   Robot: MAGI_Assembly_URDF
[17:00:36]   Root link: base_link
[17:00:36]   Links: 23
[17:00:36]   Joints: 22
[17:00:36]   Assemblies: 1
[17:00:36]   Warnings: 4
[17:00:36]   Errors: 0
[17:02:08] 
=== MESH EXPORT ===
[17:02:08]   base_link:
[17:02:08]     OBJ exported (297898 bytes)
[17:02:08]     MTL preserved from Fusion (multi-material)
[17:02:09]     DAE written → meshes/MAGI_Assembly_URDF/base_link.dae (OBJ retained for collision fit)
[17:02:09]   HexapodV3Mid:
[17:02:09]     OBJ exported (579702 bytes)
[17:02:09]     MTL preserved from Fusion (multi-material)
[17:02:09]     DAE written → meshes/MAGI_Assembly_URDF/HexapodV3Mid.dae (OBJ retained for collision fit)
[17:02:09]   HexapodV3Top:
[17:02:10]     OBJ exported (2912889 bytes)
[17:02:10]     MTL preserved from Fusion (multi-material)
[17:02:10]     DAE written → meshes/MAGI_Assembly_URDF/HexapodV3Top.dae (OBJ retained for collision fit)
[17:02:10]   MAGI_Assembly_URDF_MG996R_servo:
[17:02:11]     OBJ exported (2515770 bytes)
[17:02:11]     MTL preserved from Fusion (multi-material)
[17:02:11]     DAE written → meshes/MAGI_Assembly_URDF/MAGI_Assembly_URDF_MG996R_servo.dae (OBJ retained for collision fit)
[17:02:11]   MAGI_Assembly_URDF_HQpod_Coxal_Left_v2:
[17:02:11]     OBJ exported (1125355 bytes)
[17:02:11]     MTL preserved from Fusion (multi-material)
[17:02:11]     DAE written → meshes/MAGI_Assembly_URDF/MAGI_Assembly_URDF_HQpod_Coxal_Left_v2.dae (OBJ retained for collision fit)
[17:02:11]   MAGI_Assembly_URDF_MG996R_servo_5:
[17:02:12]     OBJ exported (2515772 bytes)
[17:02:12]     MTL preserved from Fusion (multi-material)
[17:02:12]     DAE written → meshes/MAGI_Assembly_URDF/MAGI_Assembly_URDF_MG996R_servo_5.dae (OBJ retained for collision fit)
[17:02:12]   MAGI_Assembly_URDF_HQpod_Femur:
[17:02:12]     OBJ exported (153937 bytes)
[17:02:12]     MTL preserved from Fusion (multi-material)
[17:02:12]     DAE written → meshes/MAGI_Assembly_URDF/MAGI_Assembly_URDF_HQpod_Femur.dae (OBJ retained for collision fit)
[17:02:12]   MAGI_Assembly_URDF_MG996R_servo_6:
[17:02:12]     OBJ exported (2515772 bytes)
[17:02:13]     MTL preserved from Fusion (multi-material)
[17:02:13]     DAE written → meshes/MAGI_Assembly_URDF/MAGI_Assembly_URDF_MG996R_servo_6.dae (OBJ retained for collision fit)
[17:02:13]   MAGI_Assembly_URDF_HQpod_Tibia_Left:
[17:02:13]     OBJ exported (514840 bytes)
[17:02:13]     MTL preserved from Fusion (multi-material)
[17:02:13]     DAE written → meshes/MAGI_Assembly_URDF/MAGI_Assembly_URDF_HQpod_Tibia_Left.dae (OBJ retained for collision fit)
[17:02:13]   MAGI_Assembly_URDF_MG996R_servo_7:
[17:02:13]     OBJ exported (2515772 bytes)
[17:02:13]     MTL preserved from Fusion (multi-material)
[17:02:14]     DAE written → meshes/MAGI_Assembly_URDF/MAGI_Assembly_URDF_MG996R_servo_7.dae (OBJ retained for collision fit)
[17:02:14]   MAGI_Assembly_URDF_HQpod_Coxal_Left_v2_2:
[17:02:14]     OBJ exported (1125357 bytes)
[17:02:14]     MTL preserved from Fusion (multi-material)
[17:02:14]     DAE written → meshes/MAGI_Assembly_URDF/MAGI_Assembly_URDF_HQpod_Coxal_Left_v2_2.dae (OBJ retained for collision fit)
[17:02:14]   MAGI_Assembly_URDF_MG996R_servo_8:
[17:02:14]     OBJ exported (2515772 bytes)
[17:02:14]     MTL preserved from Fusion (multi-material)
[17:02:14]     DAE written → meshes/MAGI_Assembly_URDF/MAGI_Assembly_URDF_MG996R_servo_8.dae (OBJ retained for collision fit)
[17:02:14]   MAGI_Assembly_URDF_HQpod_Femur_2:
[17:02:15]     OBJ exported (153939 bytes)
[17:02:15]     MTL preserved from Fusion (multi-material)
[17:02:15]     DAE written → meshes/MAGI_Assembly_URDF/MAGI_Assembly_URDF_HQpod_Femur_2.dae (OBJ retained for collision fit)
[17:02:15]   MAGI_Assembly_URDF_MG996R_servo_9:
[17:02:15]     OBJ exported (2515772 bytes)
[17:02:15]     MTL preserved from Fusion (multi-material)
[17:02:15]     DAE written → meshes/MAGI_Assembly_URDF/MAGI_Assembly_URDF_MG996R_servo_9.dae (OBJ retained for collision fit)
[17:02:15]   MAGI_Assembly_URDF_HQpod_Tibia_Left_2:
[17:02:15]     OBJ exported (514842 bytes)
[17:02:15]     MTL preserved from Fusion (multi-material)
[17:02:15]     DAE written → meshes/MAGI_Assembly_URDF/MAGI_Assembly_URDF_HQpod_Tibia_Left_2.dae (OBJ retained for collision fit)
[17:02:15]   MAGI_Assembly_URDF_HQpod_Coxal_Right_v2_2:
[17:02:15]     MAGI_Assembly_URDF_HQpod_Coxal_Right_v2_2: rigid group has shared-component member(s) — using per-member export to avoid sibling-geometry leak
[17:02:18]     Merged rigid group (6 members, 40763 verts, 81576 faces)
[17:02:19]     DAE written → meshes/MAGI_Assembly_URDF/MAGI_Assembly_URDF_HQpod_Coxal_Right_v2_2.dae (OBJ retained for collision fit)
[17:02:19]   HQpod_Tibia_Right:
[17:02:19]     OBJ exported (958549 bytes)
[17:02:19]     MTL preserved from Fusion (multi-material)
[17:02:19]     DAE written → meshes/MAGI_Assembly_URDF/HQpod_Tibia_Right.dae (OBJ retained for collision fit)
[17:02:19]   MAGI_Assembly_URDF_MG996R_servo_2:
[17:02:19]     OBJ exported (2515772 bytes)
[17:02:19]     MTL preserved from Fusion (multi-material)
[17:02:20]     DAE written → meshes/MAGI_Assembly_URDF/MAGI_Assembly_URDF_MG996R_servo_2.dae (OBJ retained for collision fit)
[17:02:20]   MAGI_Assembly_URDF_HQpod_Femur_3:
[17:02:20]     OBJ exported (153939 bytes)
[17:02:20]     MTL preserved from Fusion (multi-material)
[17:02:20]     DAE written → meshes/MAGI_Assembly_URDF/MAGI_Assembly_URDF_HQpod_Femur_3.dae (OBJ retained for collision fit)
[17:02:20]   MAGI_Assembly_URDF_MG996R_servo_3:
[17:02:20]     OBJ exported (2515772 bytes)
[17:02:20]     MTL preserved from Fusion (multi-material)
[17:02:20]     DAE written → meshes/MAGI_Assembly_URDF/MAGI_Assembly_URDF_MG996R_servo_3.dae (OBJ retained for collision fit)
[17:02:20]   MAGI_Assembly_URDF_HQpod_Coxal_Right_v2_3:
[17:02:20]     OBJ exported (988073 bytes)
[17:02:20]     MTL preserved from Fusion (multi-material)
[17:02:21]     DAE written → meshes/MAGI_Assembly_URDF/MAGI_Assembly_URDF_HQpod_Coxal_Right_v2_3.dae (OBJ retained for collision fit)
[17:02:21]   MAGI_Assembly_URDF_MG996R_servo_4:
[17:02:21]     OBJ exported (2515772 bytes)
[17:02:21]     MTL preserved from Fusion (multi-material)
[17:02:21]     DAE written → meshes/MAGI_Assembly_URDF/MAGI_Assembly_URDF_MG996R_servo_4.dae (OBJ retained for collision fit)
[17:02:21]   MAGI_Assembly_URDF_HQpod_Coxal_Right_v2:
[17:02:21]     OBJ exported (988071 bytes)
[17:02:21]     MTL preserved from Fusion (multi-material)
[17:02:21]     DAE written → meshes/MAGI_Assembly_URDF/MAGI_Assembly_URDF_HQpod_Coxal_Right_v2.dae (OBJ retained for collision fit)
[17:02:21] 
  Mesh export summary:
[17:02:21]     Visual (OBJ+MTL):              23
[17:02:21]     Collision sub-component (STL):  0
[17:02:21]     Collision body + warning (STL): 0
[17:02:21]     Skipped (no Fusion ref):        0
[17:02:21] 
=== PHASE 3: SCREENSHOT ===
[17:02:22]   → images/robot.png
[17:02:22] 
=== PACKAGE: GENERATE ===
[17:02:22]   Package: MAGI_Assembly_URDF_description
[17:02:22]   Output:  D:/Paras/MAGI/URDF\MAGI_Assembly_URDF_description
[17:02:22] 
=== COLLISION: RESOLVE ===
[17:02:22]   base_link: primitive (box [219.5 x 144.9 x 27.0] mm)
[17:02:22]   HexapodV3Mid: primitive (box [220.5 x 119.3 x 25.0] mm)
[17:02:22]   HexapodV3Top: primitive (box [240.0 x 197.4 x 28.8] mm)
[17:02:22]   MAGI_Assembly_URDF_MG996R_servo: primitive (box [53.3 x 43.5 x 20.0] mm)
[17:02:22]   MAGI_Assembly_URDF_HQpod_Coxal_Left_v2: primitive (box [61.2 x 74.3 x 28.8] mm)
[17:02:22]   MAGI_Assembly_URDF_MG996R_servo_5: primitive (box [53.3 x 43.5 x 20.0] mm)
[17:02:22]   MAGI_Assembly_URDF_HQpod_Femur: primitive (box [85.0 x 26.0 x 56.1] mm)
[17:02:22]   MAGI_Assembly_URDF_MG996R_servo_6: primitive (box [53.3 x 43.5 x 20.0] mm)
[17:02:22]   MAGI_Assembly_URDF_HQpod_Tibia_Left: primitive (box [141.0 x 64.5 x 31.7] mm)
[17:02:22]   MAGI_Assembly_URDF_MG996R_servo_7: primitive (box [53.3 x 43.5 x 20.0] mm)
[17:02:22]   MAGI_Assembly_URDF_HQpod_Coxal_Left_v2_2: primitive (box [61.2 x 74.3 x 28.8] mm)
[17:02:22]   MAGI_Assembly_URDF_MG996R_servo_8: primitive (box [53.3 x 43.5 x 20.0] mm)
[17:02:22]   MAGI_Assembly_URDF_HQpod_Femur_2: primitive (box [85.0 x 26.0 x 56.1] mm)
[17:02:22]   MAGI_Assembly_URDF_MG996R_servo_9: primitive (box [53.3 x 43.5 x 20.0] mm)
[17:02:22]   MAGI_Assembly_URDF_HQpod_Tibia_Left_2: primitive (box [141.0 x 64.5 x 31.7] mm)
[17:02:22]   MAGI_Assembly_URDF_HQpod_Coxal_Right_v2_2: primitive (box [138.1 x 73.9 x 33.9] mm)
[17:02:22]   HQpod_Tibia_Right: primitive (box [110.3 x 104.5 x 28.8] mm)
[17:02:22]   MAGI_Assembly_URDF_MG996R_servo_2: primitive (box [53.3 x 43.5 x 20.0] mm)
[17:02:22]   MAGI_Assembly_URDF_HQpod_Femur_3: primitive (box [85.0 x 26.0 x 56.1] mm)
[17:02:22]   MAGI_Assembly_URDF_MG996R_servo_3: primitive (box [53.3 x 43.5 x 20.0] mm)
[17:02:23]   MAGI_Assembly_URDF_HQpod_Coxal_Right_v2_3: primitive (box [61.2 x 74.3 x 28.8] mm)
[17:02:23]   MAGI_Assembly_URDF_MG996R_servo_4: primitive (box [53.3 x 43.5 x 20.0] mm)
[17:02:23]   MAGI_Assembly_URDF_HQpod_Coxal_Right_v2: primitive (box [61.2 x 74.3 x 28.8] mm)
[17:02:23] 
  Collision summary:
[17:02:23]     Explicit:        0
[17:02:23]     Primitive (STL): 23
[17:02:23]     Convex hull STL: 0
[17:02:23]     Visual reuse:    0
[17:02:23]     Visual fallback: 0
[17:02:23] 
=== COLLISION: GENERATE STL ===
[17:02:23]   base_link: box -> 12 tris (0.7 KB)
[17:02:23]   HexapodV3Mid: box -> 12 tris (0.7 KB)
[17:02:23]   HexapodV3Top: box -> 12 tris (0.7 KB)
[17:02:23]   MAGI_Assembly_URDF_MG996R_servo: box -> 12 tris (0.7 KB)
[17:02:23]   MAGI_Assembly_URDF_HQpod_Coxal_Left_v2: box -> 12 tris (0.7 KB)
[17:02:23]   MAGI_Assembly_URDF_MG996R_servo_5: box -> 12 tris (0.7 KB)
[17:02:23]   MAGI_Assembly_URDF_HQpod_Femur: box -> 12 tris (0.7 KB)
[17:02:23]   MAGI_Assembly_URDF_MG996R_servo_6: box -> 12 tris (0.7 KB)
[17:02:23]   MAGI_Assembly_URDF_HQpod_Tibia_Left: box -> 12 tris (0.7 KB)
[17:02:23]   MAGI_Assembly_URDF_MG996R_servo_7: box -> 12 tris (0.7 KB)
[17:02:23]   MAGI_Assembly_URDF_HQpod_Coxal_Left_v2_2: box -> 12 tris (0.7 KB)
[17:02:23]   MAGI_Assembly_URDF_MG996R_servo_8: box -> 12 tris (0.7 KB)
[17:02:23]   MAGI_Assembly_URDF_HQpod_Femur_2: box -> 12 tris (0.7 KB)
[17:02:23]   MAGI_Assembly_URDF_MG996R_servo_9: box -> 12 tris (0.7 KB)
[17:02:23]   MAGI_Assembly_URDF_HQpod_Tibia_Left_2: box -> 12 tris (0.7 KB)
[17:02:23]   MAGI_Assembly_URDF_HQpod_Coxal_Right_v2_2: box -> 12 tris (0.7 KB)
[17:02:23]   HQpod_Tibia_Right: box -> 12 tris (0.7 KB)
[17:02:23]   MAGI_Assembly_URDF_MG996R_servo_2: box -> 12 tris (0.7 KB)
[17:02:23]   MAGI_Assembly_URDF_HQpod_Femur_3: box -> 12 tris (0.7 KB)
[17:02:23]   MAGI_Assembly_URDF_MG996R_servo_3: box -> 12 tris (0.7 KB)
[17:02:23]   MAGI_Assembly_URDF_HQpod_Coxal_Right_v2_3: box -> 12 tris (0.7 KB)
[17:02:23]   MAGI_Assembly_URDF_MG996R_servo_4: box -> 12 tris (0.7 KB)
[17:02:23]   MAGI_Assembly_URDF_HQpod_Coxal_Right_v2: box -> 12 tris (0.7 KB)
[17:02:23] 
  Generated 23 collision STL files
[17:02:23] 
=== PACKAGE: FRAMES ===
[17:02:23]   -> debug/frame_model.json (pre-frame cache)
[17:02:23]   Frame convention: ros
[17:02:23]   Frame overrides:  config/frame_overrides.csv
[17:02:23]   Rebased links:    9/23
[17:02:23] 
=== PACKAGE: XACRO ===
[17:02:23]   → urdf/MAGI_Assembly_URDF.urdf.xacro
[17:02:23]   → urdf/assemblies/MAGI_Assembly_URDF.urdf.xacro
[17:02:23] 
=== PACKAGE: URDF (flat, for validation) ===
[17:02:23]   → urdf/MAGI_Assembly_URDF.urdf
[17:02:23] 
=== PACKAGE: ROS2 FILES ===
[17:02:23]   → package.xml
[17:02:23]   → CMakeLists.txt
[17:02:23]   → launch/display.launch.py
[17:02:23]   → rviz/display.rviz
[17:02:23]   → config/joint_state.yaml
[17:02:23]   → config/ros2_controllers.yaml
[17:02:23] 
=== PACKAGE: SUPPLEMENTARY DATA ===
[17:02:23]   → robot_data.yaml
[17:02:23]   -> docs/transforms.md
[17:02:23] 
=== PACKAGE: README ===
[17:02:23]   → README.md
[17:02:23]   Cleaned up 46 retained OBJ/MTL files
[17:02:23] 
=== PACKAGE: COMPLETE ===
[17:02:23]   Package generated: D:/Paras/MAGI/URDF\MAGI_Assembly_URDF_description
[17:02:23]   Xacro: urdf/MAGI_Assembly_URDF.urdf.xacro (+ 1 assembly macros)
[17:02:23]   URDF:  urdf/MAGI_Assembly_URDF.urdf (flat, for validation)
[17:02:23]   Launch: ros2 launch MAGI_Assembly_URDF_description display.launch.py
[17:02:23] 
=== EXPORT COMPLETE ===
```
