paraspective/MAGI-v2/archive/urdf_iterations/URDF_v1/debug/export_log.md

# Export Log: MAGI_Assemblyy v2

**Generated:** 2026-09-03T14:58:18.931514

```
[14:57:27] fusion2URDF v3.1.0
[14:57:27] Time: 2026-09-03T14:57:27.313095
[14:57:27] Design: MAGI_Assemblyy v2
[14:57:27] Components: 10
[14:57:27] 
=== PHASE 1: EXTRACTION ===
[14:57:27]   Document unit: mm
[14:57:27] 
=== EXTRACTION: OCCURRENCES ===
[14:57:27]   [LEAF] d=0 base_link
[14:57:27]     path: base_link v3:1
[14:57:27]     global_pos: (0.000000, 0.000000, 0.000000) m
[14:57:27]     mass: 0.461432 kg, bodies: 1
[14:57:27]     com_global: (0.188950, 1.012566, 0.124814) m
[14:57:27]     com_component_local: (0.188950, 1.012566, 0.124814) m
[14:57:27]     inertia@origin: ixx=4.810833e-01 iyy=2.548777e-02 izz=4.921769e-01 kg·m²
[14:57:27]     inertia@com:    ixx=7.929840e-04 iyy=1.825252e-03 izz=2.601024e-03 kg·m²
[14:57:27]     material: Steel
[14:57:27]     color: RGB(0.63, 0.63, 0.63) [Steel_Satin]
[14:57:27]     bbox: (0.2195 x 0.1449 x 0.0270) m
[14:57:27]   [LEAF] d=0 HexapodV3Mid
[14:57:27]     path: HexapodV3Mid v5:1
[14:57:27]     global_pos: (0.113207, 1.351156, -0.242000) m
[14:57:27]     mass: 0.430715 kg, bodies: 1
[14:57:27]     com_global: (0.170142, 1.012498, 0.150833) m
[14:57:27]     com_component_local: (0.056935, -0.338657, 0.392833) m
[14:57:27]     inertia@origin: ixx=1.162344e-01 iyy=6.948798e-02 izz=5.277708e-02 kg·m²
[14:57:27]     inertia@com:    ixx=3.691505e-04 iyy=1.624727e-03 izz=1.982639e-03 kg·m²
[14:57:27]     material: Steel
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
[14:57:27]   [REGULAR in MAGI_Assemblyy] Rigid_1
[14:57:27]     parent(occ2): base_link path=base_link v3:1
[14:57:27]     child(occ1):  HexapodV3Mid path=HexapodV3Mid v5:1
[14:57:27]     geometryOrOriginOne: (9.7026, 105.3896, 14.8500) cm
[14:57:27]     geometryOrOriginTwo: (9.7026, 105.3896, 14.8500) cm
[14:57:27]     occ1.transform: (11.3207, 135.1156, -24.2000) cm (ctx_depth=0)
[14:57:27]     occ1.global:    (11.3207, 135.1156, -24.2000) cm
[14:57:27]     occ2.transform: (0.0000, 0.0000, 0.0000) cm (ctx_depth=0)
[14:57:27]     occ2.global:    (0.0000, 0.0000, 0.0000) cm
[14:57:27]  -> origin_global: (0.097026, 1.053896, 0.148500) m [via geometryOrOriginOne]
[14:57:27]     motion: rigid, axis: (0.000, 0.000, 1.000)
[14:57:27]   WARNING:   regular joint in component 'MAGI_Assemblyy v2': failed to read geometry: 'Joint' object has no attribute 'geometry'
[14:57:27]   [REGULAR in MAGI_Assemblyy] Rigid_2
[14:57:27]     parent(occ2): HexapodV3Mid path=HexapodV3Mid v5:1
[14:57:27]     child(occ1):  HexapodV3Top path=HexapodV3Top v3:1
[14:57:27]     geometryOrOriginOne: (9.7026, 97.1290, 15.1498) cm
[14:57:27]     geometryOrOriginTwo: (9.7026, 97.1290, 15.1498) cm
[14:57:27]     occ1.transform: (3.8772, -150.0410, -8.9852) cm (ctx_depth=0)
[14:57:27]     occ1.global:    (3.8772, -150.0410, -8.9852) cm
[14:57:27]     occ2.transform: (11.3207, 135.1156, -24.2000) cm (ctx_depth=0)
[14:57:27]     occ2.global:    (11.3207, 135.1156, -24.2000) cm
[14:57:27]  -> origin_global: (0.097026, 0.971290, 0.151498) m [via geometryOrOriginOne]
[14:57:27]     motion: rigid, axis: (0.000, 0.000, 1.000)
[14:57:27]   WARNING:   regular joint in component 'MAGI_Assemblyy v2': failed to read geometry: 'Joint' object has no attribute 'geometry'
[14:57:27]   [REGULAR in MAGI_Assemblyy] Rigid_4
[14:57:27]     parent(occ2): HexapodV3Top path=HexapodV3Top v3:1
[14:57:27]     child(occ1):  MG996R_servo path=MG996R_servo v1:1
[14:57:27]     geometryOrOriginOne: (12.8698, 96.4906, 15.1498) cm
[14:57:27]     geometryOrOriginTwo: (12.8698, 96.4906, 15.1498) cm
[14:57:27]     occ1.transform: (9.3697, 93.6976, 12.1750) cm (ctx_depth=0)
[14:57:27]     occ1.global:    (9.3697, 93.6976, 12.1750) cm
[14:57:27]     occ2.transform: (3.8772, -150.0410, -8.9852) cm (ctx_depth=0)
[14:57:27]     occ2.global:    (3.8772, -150.0410, -8.9852) cm
[14:57:27]  -> origin_global: (0.128698, 0.964906, 0.151498) m [via geometryOrOriginOne]
[14:57:27]     motion: rigid, axis: (0.000, 0.000, 1.000)
[14:57:27]   WARNING:   regular joint in component 'MAGI_Assemblyy v2': failed to read geometry: 'Joint' object has no attribute 'geometry'
[14:57:27]   [REGULAR in MAGI_Assemblyy] Revolute_5
[14:57:27]     parent(occ2): MG996R_servo path=MG996R_servo v1:1
[14:57:27]     child(occ1):  HQpod_Coxal_Left_v2 path=HQpod_Coxal_Left_v2 v2:2
[14:57:27]     geometryOrOriginOne: (10.1015, 94.4294, 16.1744) cm
[14:57:27]     geometryOrOriginTwo: (10.1015, 94.4294, 16.1744) cm
[14:57:27]     occ1.transform: (-40.4878, 65.4014, 79.1767) cm (ctx_depth=0)
[14:57:27]     occ1.global:    (-40.4878, 65.4014, 79.1767) cm
[14:57:27]     occ2.transform: (9.3697, 93.6976, 12.1750) cm (ctx_depth=0)
[14:57:27]     occ2.global:    (9.3697, 93.6976, 12.1750) cm
[14:57:27]  -> origin_global: (0.101015, 0.944294, 0.161744) m [via geometryOrOriginOne]
[14:57:27]     motion: revolute, axis: (0.000, 0.000, 1.000)
[14:57:27]     rotation limits: [-0.5934, 1.5708] rad
[14:57:27]   WARNING:   regular joint in component 'MAGI_Assemblyy v2': failed to read geometry: 'Joint' object has no attribute 'geometry'
[14:57:27]   [REGULAR in MAGI_Assemblyy] Rigid_6
[14:57:27]     parent(occ2): HQpod_Coxal_Left_v2 path=HQpod_Coxal_Left_v2 v2:2
[14:57:27]     child(occ1):  MG996R_servo path=MG996R_servo v1:2
[14:57:27]     geometryOrOriginOne: (6.0709, 91.4894, 16.1843) cm
[14:57:27]     geometryOrOriginTwo: (6.0709, 91.4894, 16.1843) cm
[14:57:27]     occ1.transform: (8.5017, 89.7030, 11.7344) cm (ctx_depth=0)
[14:57:27]     occ1.global:    (8.5017, 89.7030, 11.7344) cm
[14:57:27]     occ2.transform: (-40.4878, 65.4014, 79.1767) cm (ctx_depth=0)
[14:57:27]     occ2.global:    (-40.4878, 65.4014, 79.1767) cm
[14:57:27]  -> origin_global: (0.060709, 0.914894, 0.161843) m [via geometryOrOriginOne]
[14:57:27]     motion: rigid, axis: (0.000, 0.000, 1.000)
[14:57:27]   WARNING:   regular joint in component 'MAGI_Assemblyy v2': failed to read geometry: 'Joint' object has no attribute 'geometry'
[14:57:27]   [REGULAR in MAGI_Assemblyy] Revolute_7
[14:57:27]     parent(occ2): MG996R_servo path=MG996R_servo v1:2
[14:57:27]     child(occ1):  HQpod_Femur path=HQpod_Femur v3:1
[14:57:27]     geometryOrOriginOne: (5.7161, 92.5728, 12.7693) cm
[14:57:27]     geometryOrOriginTwo: (5.7161, 92.5728, 12.7693) cm
[14:57:27]     occ1.transform: (39.7256, 47.9610, 82.9249) cm (ctx_depth=0)
[14:57:27]     occ1.global:    (39.7256, 47.9610, 82.9249) cm
[14:57:27]     occ2.transform: (8.5017, 89.7030, 11.7344) cm (ctx_depth=0)
[14:57:27]     occ2.global:    (8.5017, 89.7030, 11.7344) cm
[14:57:27]  -> origin_global: (0.057161, 0.925728, 0.127693) m [via geometryOrOriginOne]
[14:57:27]     motion: revolute, axis: (-0.697, 0.718, -0.000)
[14:57:27]     rotation limits: [-1.3963, 0.9599] rad
[14:57:27]   WARNING:   regular joint in component 'MAGI_Assemblyy v2': failed to read geometry: 'Joint' object has no attribute 'geometry'
[14:57:27]   [REGULAR in MAGI_Assemblyy] Revolute_8
[14:57:27]     parent(occ2): HQpod_Femur path=HQpod_Femur v3:1
[14:57:27]     child(occ1):  MG996R_servo path=MG996R_servo v1:3
[14:57:27]     geometryOrOriginOne: (2.0842, 89.0475, 9.8354) cm
[14:57:27]     geometryOrOriginTwo: (2.0842, 89.0475, 9.8354) cm
[14:57:27]     occ1.transform: (5.5129, 86.8019, 10.3529) cm (ctx_depth=0)
[14:57:27]     occ1.global:    (5.5129, 86.8019, 10.3529) cm
[14:57:27]     occ2.transform: (39.7256, 47.9610, 82.9249) cm (ctx_depth=0)
[14:57:27]     occ2.global:    (39.7256, 47.9610, 82.9249) cm
[14:57:27]  -> origin_global: (0.020842, 0.890475, 0.098354) m [via geometryOrOriginOne]
[14:57:27]     motion: revolute, axis: (-0.697, 0.718, -0.000)
[14:57:27]     rotation limits: [-1.5708, 1.5708] rad
[14:57:27]   WARNING:   regular joint in component 'MAGI_Assemblyy v2': failed to read geometry: 'Joint' object has no attribute 'geometry'
[14:57:27]   [REGULAR in MAGI_Assemblyy] Rigid_10
[14:57:27]     parent(occ2): HexapodV3Top path=HexapodV3Top v3:1
[14:57:27]     child(occ1):  MG996R_servo path=MG996R_servo v1:4
[14:57:27]     geometryOrOriginOne: (24.7686, 106.0302, 15.1498) cm
[14:57:27]     geometryOrOriginTwo: (24.7686, 106.0302, 15.1498) cm
[14:57:27]     occ1.transform: (28.2688, 108.8232, 12.1750) cm (ctx_depth=0)
[14:57:27]     occ1.global:    (28.2688, 108.8232, 12.1750) cm
[14:57:27]     occ2.transform: (3.8772, -150.0410, -8.9852) cm (ctx_depth=0)
[14:57:27]     occ2.global:    (3.8772, -150.0410, -8.9852) cm
[14:57:27]  -> origin_global: (0.247686, 1.060302, 0.151498) m [via geometryOrOriginOne]
[14:57:27]     motion: rigid, axis: (0.000, 0.000, 1.000)
[14:57:27]   WARNING:   regular joint in component 'MAGI_Assemblyy v2': failed to read geometry: 'Joint' object has no attribute 'geometry'
[14:57:27]   [REGULAR in MAGI_Assemblyy] Revolute_12
[14:57:27]     parent(occ2): MG996R_servo path=MG996R_servo v1:4
[14:57:27]     child(occ1):  HQpod_Coxal_Left_v2 path=HQpod_Coxal_Left_v2 v2:3
[14:57:27]     geometryOrOriginOne: (27.5370, 108.0914, 16.1744) cm
[14:57:27]     geometryOrOriginTwo: (27.5370, 108.0914, 16.1744) cm
[14:57:27]     occ1.transform: (78.1262, 137.1194, 79.1767) cm (ctx_depth=0)
[14:57:27]     occ1.global:    (78.1262, 137.1194, 79.1767) cm
[14:57:27]     occ2.transform: (28.2688, 108.8232, 12.1750) cm (ctx_depth=0)
[14:57:27]     occ2.global:    (28.2688, 108.8232, 12.1750) cm
[14:57:27]  -> origin_global: (0.275370, 1.080914, 0.161744) m [via geometryOrOriginOne]
[14:57:27]     motion: revolute, axis: (-0.000, 0.000, 1.000)
[14:57:27]     rotation limits: [-0.3840, 1.5708] rad
[14:57:27]   WARNING:   regular joint in component 'MAGI_Assemblyy v2': failed to read geometry: 'Joint' object has no attribute 'geometry'
[14:57:27]   [REGULAR in MAGI_Assemblyy] Rigid_13
[14:57:27]     parent(occ2): HQpod_Coxal_Left_v2 path=HQpod_Coxal_Left_v2 v2:3
[14:57:27]     child(occ1):  MG996R_servo path=MG996R_servo v1:6
[14:57:27]     geometryOrOriginOne: (31.5796, 111.0432, 11.3445) cm
[14:57:27]     geometryOrOriginTwo: (31.5796, 111.0432, 11.3445) cm
[14:57:27]     occ1.transform: (29.1039, 112.8759, 11.7246) cm (ctx_depth=0)
[14:57:27]     occ1.global:    (29.1039, 112.8759, 11.7246) cm
[14:57:27]     occ2.transform: (78.1262, 137.1194, 79.1767) cm (ctx_depth=0)
[14:57:27]     occ2.global:    (78.1262, 137.1194, 79.1767) cm
[14:57:27]  -> origin_global: (0.315796, 1.110432, 0.113445) m [via geometryOrOriginOne]
[14:57:27]     motion: rigid, axis: (0.000, 0.000, 1.000)
[14:57:27]   WARNING:   regular joint in component 'MAGI_Assemblyy v2': failed to read geometry: 'Joint' object has no attribute 'geometry'
[14:57:27]   [REGULAR in MAGI_Assemblyy] Revolute_14
[14:57:27]     parent(occ2): MG996R_servo path=MG996R_servo v1:6
[14:57:27]     child(occ1):  HQpod_Femur path=HQpod_Femur v3:2
[14:57:27]     geometryOrOriginOne: (31.8895, 110.0061, 12.7595) cm
[14:57:27]     geometryOrOriginTwo: (31.8895, 110.0061, 12.7595) cm
[14:57:27]     occ1.transform: (-8.0593, 148.8554, -60.3287) cm (ctx_depth=0)
[14:57:27]     occ1.global:    (-8.0593, 148.8554, -60.3287) cm
[14:57:27]     occ2.transform: (29.1039, 112.8759, 11.7246) cm (ctx_depth=0)
[14:57:27]     occ2.global:    (29.1039, 112.8759, 11.7246) cm
[14:57:27]  -> origin_global: (0.318895, 1.100061, 0.127595) m [via geometryOrOriginOne]
[14:57:27]     motion: revolute, axis: (0.697, -0.718, -0.000)
[14:57:27]     rotation limits: [-1.3963, 0.9599] rad
[14:57:27]   WARNING:   regular joint in component 'MAGI_Assemblyy v2': failed to read geometry: 'Joint' object has no attribute 'geometry'
[14:57:27]   [REGULAR in MAGI_Assemblyy] Revolute_15
[14:57:27]     parent(occ2): HQpod_Femur path=HQpod_Femur v3:2
[14:57:27]     child(occ1):  MG996R_servo path=MG996R_servo v1:7
[14:57:27]     geometryOrOriginOne: (35.5213, 113.5315, 9.8256) cm
[14:57:27]     geometryOrOriginTwo: (35.5213, 113.5315, 9.8256) cm
[14:57:27]     occ1.transform: (32.0926, 115.7770, 10.3431) cm (ctx_depth=0)
[14:57:27]     occ1.global:    (32.0926, 115.7770, 10.3431) cm
[14:57:27]     occ2.transform: (-8.0593, 148.8554, -60.3287) cm (ctx_depth=0)
[14:57:27]     occ2.global:    (-8.0593, 148.8554, -60.3287) cm
[14:57:27]  -> origin_global: (0.355213, 1.135315, 0.098256) m [via geometryOrOriginOne]
[14:57:27]     motion: revolute, axis: (0.697, -0.718, -0.000)
[14:57:27]     rotation limits: [-1.5708, 1.5708] rad
[14:57:27]   WARNING:   regular joint in component 'MAGI_Assemblyy v2': failed to read geometry: 'Joint' object has no attribute 'geometry'
[14:57:27]   [REGULAR in MAGI_Assemblyy] Rigid_17
[14:57:27]     parent(occ2): HexapodV3Top path=HexapodV3Top v3:1
[14:57:27]     child(occ1):  MG996R_servo path=MG996R_servo v1:8
[14:57:27]     geometryOrOriginOne: (28.9019, 93.7603, 15.1498) cm
[14:57:27]     geometryOrOriginTwo: (28.9019, 93.7603, 15.1498) cm
[14:57:27]     occ1.transform: (28.2795, 93.6755, 12.1104) cm (ctx_depth=0)
[14:57:27]     occ1.global:    (28.2795, 93.6755, 12.1104) cm
[14:57:27]     occ2.transform: (3.8772, -150.0410, -8.9852) cm (ctx_depth=0)
[14:57:27]     occ2.global:    (3.8772, -150.0410, -8.9852) cm
[14:57:27]  -> origin_global: (0.289019, 0.937603, 0.151498) m [via geometryOrOriginOne]
[14:57:27]     motion: rigid, axis: (0.000, 0.000, 1.000)
[14:57:27]   WARNING:   regular joint in component 'MAGI_Assemblyy v2': failed to read geometry: 'Joint' object has no attribute 'geometry'
[14:57:27]   [REGULAR in MAGI_Assemblyy] Revolute_18
[14:57:27]     parent(occ2): MG996R_servo path=MG996R_servo v1:8
[14:57:27]     child(occ1):  HQpod_Coxal_Right_v2 path=HQpod_Coxal_Right_v2 v2:2
[14:57:27]     geometryOrOriginOne: (27.5477, 94.4073, 16.1098) cm
[14:57:27]     geometryOrOriginTwo: (27.5477, 94.4073, 16.1098) cm
[14:57:27]     occ1.transform: (55.1768, 87.8564, 79.3126) cm (ctx_depth=0)
[14:57:27]     occ1.global:    (55.1768, 87.8564, 79.3126) cm
[14:57:27]     occ2.transform: (28.2795, 93.6755, 12.1104) cm (ctx_depth=0)
[14:57:27]     occ2.global:    (28.2795, 93.6755, 12.1104) cm
[14:57:27]  -> origin_global: (0.275477, 0.944073, 0.161098) m [via geometryOrOriginOne]
[14:57:27]     motion: revolute, axis: (-0.000, 0.000, 1.000)
[14:57:27]     rotation limits: [-1.5708, 0.3840] rad
[14:57:27]   WARNING:   regular joint in component 'MAGI_Assemblyy v2': failed to read geometry: 'Joint' object has no attribute 'geometry'
[14:57:27]   [REGULAR in MAGI_Assemblyy] Rigid_19
[14:57:27]     parent(occ2): HQpod_Coxal_Right_v2 path=HQpod_Coxal_Right_v2 v2:2
[14:57:27]     child(occ1):  MG996R_servo path=MG996R_servo v1:9
[14:57:27]     geometryOrOriginOne: (31.5948, 91.4900, 16.1198) cm
[14:57:27]     geometryOrOriginTwo: (31.5948, 91.4900, 16.1198) cm
[14:57:27]     occ1.transform: (29.1741, 89.6900, 11.6699) cm (ctx_depth=0)
[14:57:27]     occ1.global:    (29.1741, 89.6900, 11.6699) cm
[14:57:27]     occ2.transform: (55.1768, 87.8564, 79.3126) cm (ctx_depth=0)
[14:57:27]     occ2.global:    (55.1768, 87.8564, 79.3126) cm
[14:57:27]  -> origin_global: (0.315948, 0.914900, 0.161198) m [via geometryOrOriginOne]
[14:57:27]     motion: rigid, axis: (0.000, 0.000, 1.000)
[14:57:27]   WARNING:   regular joint in component 'MAGI_Assemblyy v2': failed to read geometry: 'Joint' object has no attribute 'geometry'
[14:57:27]   [REGULAR in MAGI_Assemblyy] Revolute_20
[14:57:27]     parent(occ2): MG996R_servo path=MG996R_servo v1:9
[14:57:27]     child(occ1):  HQpod_Femur path=HQpod_Femur v3:3
[14:57:27]     geometryOrOriginOne: (31.9435, 92.5754, 12.7048) cm
[14:57:27]     geometryOrOriginTwo: (31.9435, 92.5754, 12.7048) cm
[14:57:27]     occ1.transform: (38.4606, 9.1160, 50.6403) cm (ctx_depth=0)
[14:57:27]     occ1.global:    (38.4606, 9.1160, 50.6403) cm
[14:57:27]     occ2.transform: (29.1741, 89.6900, 11.6699) cm (ctx_depth=0)
[14:57:27]     occ2.global:    (29.1741, 89.6900, 11.6699) cm
[14:57:27]  -> origin_global: (0.319435, 0.925754, 0.127048) m [via geometryOrOriginOne]
[14:57:27]     motion: revolute, axis: (0.692, 0.721, -0.000)
[14:57:27]     rotation limits: [-0.9599, 1.3963] rad
[14:57:27]   WARNING:   regular joint in component 'MAGI_Assemblyy v2': failed to read geometry: 'Joint' object has no attribute 'geometry'
[14:57:27]   [REGULAR in MAGI_Assemblyy] Revolute_21
[14:57:27]     parent(occ2): HQpod_Femur path=HQpod_Femur v3:3
[14:57:27]     child(occ1):  MG996R_servo path=MG996R_servo v1:10
[14:57:27]     geometryOrOriginOne: (35.6024, 89.0636, 9.7883) cm
[14:57:27]     geometryOrOriginTwo: (35.6024, 89.0636, 9.7883) cm
[14:57:27]     occ1.transform: (32.1864, 86.7988, 10.3058) cm (ctx_depth=0)
[14:57:27]     occ1.global:    (32.1864, 86.7988, 10.3058) cm
[14:57:27]     occ2.transform: (38.4606, 9.1160, 50.6403) cm (ctx_depth=0)
[14:57:27]     occ2.global:    (38.4606, 9.1160, 50.6403) cm
[14:57:27]  -> origin_global: (0.356024, 0.890636, 0.097883) m [via geometryOrOriginOne]
[14:57:27]     motion: revolute, axis: (0.692, 0.721, -0.000)
[14:57:27]     rotation limits: [-1.5708, 1.5708] rad
[14:57:27]   WARNING:   regular joint in component 'MAGI_Assemblyy v2': failed to read geometry: 'Joint' object has no attribute 'geometry'
[14:57:27]   [REGULAR in MAGI_Assemblyy] Revolute_24
[14:57:27]     parent(occ2): MG996R_servo path=MG996R_servo v1:13
[14:57:27]     child(occ1):  HQpod_Coxal_Right_v2 path=HQpod_Coxal_Right_v2 v2:3
[14:57:27]     geometryOrOriginOne: (10.0830, 108.0819, 16.1098) cm
[14:57:27]     geometryOrOriginTwo: (10.0830, 108.0819, 16.1098) cm
[14:57:27]     occ1.transform: (-17.5460, 114.6328, 79.3126) cm (ctx_depth=0)
[14:57:27]     occ1.global:    (-17.5460, 114.6328, 79.3126) cm
[14:57:27]     occ2.transform: (9.3512, 108.8137, 12.1104) cm (ctx_depth=0)
[14:57:27]     occ2.global:    (9.3512, 108.8137, 12.1104) cm
[14:57:27]  -> origin_global: (0.100830, 1.080819, 0.161098) m [via geometryOrOriginOne]
[14:57:27]     motion: revolute, axis: (-0.000, 0.000, 1.000)
[14:57:27]     rotation limits: [-1.5708, 0.5934] rad
[14:57:27]   WARNING:   regular joint in component 'MAGI_Assemblyy v2': failed to read geometry: 'Joint' object has no attribute 'geometry'
[14:57:27]   [REGULAR in MAGI_Assemblyy] Rigid_25
[14:57:27]     parent(occ2): HQpod_Coxal_Right_v2 path=HQpod_Coxal_Right_v2 v2:3
[14:57:27]     child(occ1):  MG996R_servo path=MG996R_servo v1:12
[14:57:27]     geometryOrOriginOne: (6.7563, 110.3078, 16.1163) cm
[14:57:27]     geometryOrOriginTwo: (6.7563, 110.3078, 16.1163) cm
[14:57:27]     occ1.transform: (8.4555, 112.8003, 11.6664) cm (ctx_depth=0)
[14:57:27]     occ1.global:    (8.4555, 112.8003, 11.6664) cm
[14:57:27]     occ2.transform: (-17.5460, 114.6328, 79.3126) cm (ctx_depth=0)
[14:57:27]     occ2.global:    (-17.5460, 114.6328, 79.3126) cm
[14:57:27]  -> origin_global: (0.067563, 1.103078, 0.161163) m [via geometryOrOriginOne]
[14:57:27]     motion: rigid, axis: (0.000, 0.000, 1.000)
[14:57:27]   WARNING:   regular joint in component 'MAGI_Assemblyy v2': failed to read geometry: 'Joint' object has no attribute 'geometry'
[14:57:27]   [REGULAR in MAGI_Assemblyy] Revolute_26
[14:57:27]     parent(occ2): MG996R_servo path=MG996R_servo v1:12
[14:57:27]     child(occ1):  HQpod_Femur path=HQpod_Femur v3:4
[14:57:27]     geometryOrOriginOne: (5.6861, 109.9148, 12.7013) cm
[14:57:27]     geometryOrOriginTwo: (5.6861, 109.9148, 12.7013) cm
[14:57:27]     occ1.transform: (-0.8310, 193.3742, 50.6368) cm (ctx_depth=0)
[14:57:27]     occ1.global:    (-0.8310, 193.3742, 50.6368) cm
[14:57:27]     occ2.transform: (8.4555, 112.8003, 11.6664) cm (ctx_depth=0)
[14:57:27]     occ2.global:    (8.4555, 112.8003, 11.6664) cm
[14:57:27]  -> origin_global: (0.056861, 1.099148, 0.127013) m [via geometryOrOriginOne]
[14:57:27]     motion: revolute, axis: (-0.692, -0.721, -0.000)
[14:57:27]     rotation limits: [-0.9599, 1.3963] rad
[14:57:27]   WARNING:   regular joint in component 'MAGI_Assemblyy v2': failed to read geometry: 'Joint' object has no attribute 'geometry'
[14:57:27]   [REGULAR in MAGI_Assemblyy] Revolute_27
[14:57:27]     parent(occ2): HQpod_Femur path=HQpod_Femur v3:4
[14:57:27]     child(occ1):  MG996R_servo path=MG996R_servo v1:11
[14:57:27]     geometryOrOriginOne: (2.0272, 113.4266, 9.7848) cm
[14:57:27]     geometryOrOriginTwo: (2.0272, 113.4266, 9.7848) cm
[14:57:27]     occ1.transform: (5.4432, 115.6914, 10.3023) cm (ctx_depth=0)
[14:57:27]     occ1.global:    (5.4432, 115.6914, 10.3023) cm
[14:57:27]     occ2.transform: (-0.8310, 193.3742, 50.6368) cm (ctx_depth=0)
[14:57:27]     occ2.global:    (-0.8310, 193.3742, 50.6368) cm
[14:57:27]  -> origin_global: (0.020272, 1.134266, 0.097848) m [via geometryOrOriginOne]
[14:57:27]     motion: revolute, axis: (-0.692, -0.721, -0.000)
[14:57:27]     rotation limits: [-1.5708, 1.5708] rad
[14:57:27]   WARNING:   regular joint in component 'MAGI_Assemblyy v2': failed to read geometry: 'Joint' object has no attribute 'geometry'
[14:57:27]   [REGULAR in MAGI_Assemblyy] Rigid_29
[14:57:27]     parent(occ2): HexapodV3Top path=HexapodV3Top v3:1
[14:57:27]     child(occ1):  MG996R_servo path=MG996R_servo v1:13
[14:57:27]     geometryOrOriginOne: (9.4360, 109.4360, 15.1498) cm
[14:57:27]     geometryOrOriginTwo: (9.4360, 109.4360, 15.1498) cm
[14:57:27]     occ1.transform: (9.3512, 108.8137, 12.1104) cm (ctx_depth=0)
[14:57:27]     occ1.global:    (9.3512, 108.8137, 12.1104) cm
[14:57:27]     occ2.transform: (3.8772, -150.0410, -8.9852) cm (ctx_depth=0)
[14:57:27]     occ2.global:    (3.8772, -150.0410, -8.9852) cm
[14:57:27]  -> origin_global: (0.094360, 1.094360, 0.151498) m [via geometryOrOriginOne]
[14:57:27]     motion: rigid, axis: (0.000, 0.000, 1.000)
[14:57:27]   WARNING:   regular joint in component 'MAGI_Assemblyy v2': failed to read geometry: 'Joint' object has no attribute 'geometry'
[14:57:27]   [REGULAR in MAGI_Assemblyy] Rigid_31
[14:57:27]     parent(occ2): MG996R_servo path=MG996R_servo v1:7
[14:57:27]     child(occ1):  HQpod_Tibia_Left_New path=HQpod_Tibia_Left_New v2:1
[14:57:27]     geometryOrOriginOne: (37.1092, 116.5007, 8.5511) cm
[14:57:27]     geometryOrOriginTwo: (37.1092, 116.5007, 8.5511) cm
[14:57:27]     occ1.transform: (57.4222, 117.2531, 65.4013) cm (ctx_depth=0)
[14:57:27]     occ1.global:    (57.4222, 117.2531, 65.4013) cm
[14:57:27]     occ2.transform: (32.0926, 115.7770, 10.3431) cm (ctx_depth=0)
[14:57:27]     occ2.global:    (32.0926, 115.7770, 10.3431) cm
[14:57:27]  -> origin_global: (0.371092, 1.165007, 0.085511) m [via geometryOrOriginOne]
[14:57:27]     motion: rigid, axis: (0.000, 0.000, 1.000)
[14:57:27]   WARNING:   regular joint in component 'MAGI_Assemblyy v2': failed to read geometry: 'Joint' object has no attribute 'geometry'
[14:57:27]   [REGULAR in MAGI_Assemblyy] Rigid_32
[14:57:27]     parent(occ2): MG996R_servo path=MG996R_servo v1:3
[14:57:27]     child(occ1):  HQpod_Tibia_Left_New path=HQpod_Tibia_Left_New v2:2
[14:57:27]     geometryOrOriginOne: (0.8551, 86.4265, 7.6949) cm
[14:57:27]     geometryOrOriginTwo: (0.8551, 86.4265, 7.6949) cm
[14:57:27]     occ1.transform: (-19.8182, 85.3242, 65.4080) cm (ctx_depth=0)
[14:57:27]     occ1.global:    (-19.8182, 85.3242, 65.4080) cm
[14:57:27]     occ2.transform: (5.5129, 86.8019, 10.3529) cm (ctx_depth=0)
[14:57:27]     occ2.global:    (5.5129, 86.8019, 10.3529) cm
[14:57:27]  -> origin_global: (0.008551, 0.864265, 0.076949) m [via geometryOrOriginOne]
[14:57:27]     motion: rigid, axis: (0.000, 0.000, 1.000)
[14:57:27]   WARNING:   regular joint in component 'MAGI_Assemblyy v2': failed to read geometry: 'Joint' object has no attribute 'geometry'
[14:57:27]   [REGULAR in MAGI_Assemblyy] Rigid_33
[14:57:27]     parent(occ2): MG996R_servo path=MG996R_servo v1:11
[14:57:27]     child(occ1):  HQpod_Tibia_Right_New path=HQpod_Tibia_Right_New v2:1
[14:57:27]     geometryOrOriginOne: (0.7833, 116.0407, 7.6443) cm
[14:57:27]     geometryOrOriginTwo: (0.7833, 116.0407, 7.6443) cm
[14:57:27]     occ1.transform: (-30.5381, 127.2417, 90.9079) cm (ctx_depth=0)
[14:57:27]     occ1.global:    (-30.5381, 127.2417, 90.9079) cm
[14:57:27]     occ2.transform: (5.4432, 115.6914, 10.3023) cm (ctx_depth=0)
[14:57:27]     occ2.global:    (5.4432, 115.6914, 10.3023) cm
[14:57:27]  -> origin_global: (0.007833, 1.160407, 0.076443) m [via geometryOrOriginOne]
[14:57:27]     motion: rigid, axis: (0.000, 0.000, 1.000)
[14:57:27]   WARNING:   regular joint in component 'MAGI_Assemblyy v2': failed to read geometry: 'Joint' object has no attribute 'geometry'
[14:57:27]   [REGULAR in MAGI_Assemblyy] Rigid_34
[14:57:27]     parent(occ2): MG996R_servo path=MG996R_servo v1:10
[14:57:27]     child(occ1):  HQpod_Tibia_Right_New path=HQpod_Tibia_Right_New v2:2
[14:57:27]     geometryOrOriginOne: (37.2070, 86.1034, 8.5138) cm
[14:57:27]     geometryOrOriginTwo: (37.2070, 86.1034, 8.5138) cm
[14:57:27]     occ1.transform: (68.1661, 75.2502, 90.9144) cm (ctx_depth=0)
[14:57:27]     occ1.global:    (68.1661, 75.2502, 90.9144) cm
[14:57:27]     occ2.transform: (32.1864, 86.7988, 10.3058) cm (ctx_depth=0)
[14:57:27]     occ2.global:    (32.1864, 86.7988, 10.3058) cm
[14:57:27]  -> origin_global: (0.372070, 0.861034, 0.085138) m [via geometryOrOriginOne]
[14:57:27]     motion: rigid, axis: (0.000, 0.000, 1.000)
[14:57:27]   Extracted 26 unique joints
[14:57:27] 
=== EXTRACTION: RIGID GROUPS ===
[14:57:27]   No rigid groups found
[14:57:27] 
=== EXTRACTION SUMMARY ===
[14:57:27]   Occurrences: 27 (0 subassemblies, 27 leaf components)
[14:57:27]   Joints: 26 (0 as-built, 26 regular)
[14:57:27]   Max nesting depth: 0
[14:58:01] 
=== PHASE 1: DEBUG DATA ===
[14:58:01]   extraction_report.md
[14:58:01]   snapshot.json
[14:58:01]   fusion_transforms.json
[14:58:01] 
=== PHASE 2: BUILD ROBOT MODEL ===
[14:58:01] 
=== MODEL: ASSEMBLY HIERARCHY ===
[14:58:01]   Assembly: MAGI_Assemblyy (synthetic root, wraps design-root leaves so phase 2 has a macro to xacro:include)
[14:58:01]   base_link → MAGI_Assemblyy
[14:58:01]   HexapodV3Mid → MAGI_Assemblyy
[14:58:01]   HexapodV3Top → MAGI_Assemblyy
[14:58:01]   MG996R_servo → MAGI_Assemblyy
[14:58:01]   HQpod_Coxal_Left_v2 → MAGI_Assemblyy
[14:58:01]   MG996R_servo → MAGI_Assemblyy
[14:58:01]   HQpod_Femur → MAGI_Assemblyy
[14:58:01]   MG996R_servo → MAGI_Assemblyy
[14:58:01]   MG996R_servo → MAGI_Assemblyy
[14:58:01]   HQpod_Coxal_Left_v2 → MAGI_Assemblyy
[14:58:01]   MG996R_servo → MAGI_Assemblyy
[14:58:01]   HQpod_Femur → MAGI_Assemblyy
[14:58:01]   MG996R_servo → MAGI_Assemblyy
[14:58:01]   MG996R_servo → MAGI_Assemblyy
[14:58:01]   HQpod_Coxal_Right_v2 → MAGI_Assemblyy
[14:58:01]   MG996R_servo → MAGI_Assemblyy
[14:58:01]   HQpod_Femur → MAGI_Assemblyy
[14:58:01]   MG996R_servo → MAGI_Assemblyy
[14:58:01]   MG996R_servo → MAGI_Assemblyy
[14:58:01]   HQpod_Femur → MAGI_Assemblyy
[14:58:01]   MG996R_servo → MAGI_Assemblyy
[14:58:01]   HQpod_Coxal_Right_v2 → MAGI_Assemblyy
[14:58:01]   MG996R_servo → MAGI_Assemblyy
[14:58:01]   HQpod_Tibia_Left_New → MAGI_Assemblyy
[14:58:01]   HQpod_Tibia_Left_New → MAGI_Assemblyy
[14:58:01]   HQpod_Tibia_Right_New → MAGI_Assemblyy
[14:58:01]   HQpod_Tibia_Right_New → MAGI_Assemblyy
[14:58:01] 
=== MODEL: RIGID GROUP MERGE ===
[14:58:01]   No explicit rigid groups to merge
[14:58:01]   No auto rigid islands found
[14:58:01]   No rigid groups or auto rigid islands produced merged links
[14:58:01] 
=== MODEL: RESOLVE JOINT PATHS ===
[14:58:01]   Rigid_1              MAGI_Assemblyy/base_link → MAGI_Assemblyy/HexapodV3Mid  [rigid] internal
[14:58:01]   Rigid_2              MAGI_Assemblyy/HexapodV3Mid → MAGI_Assemblyy/HexapodV3Top  [rigid] internal
[14:58:01]   Rigid_4              MAGI_Assemblyy/HexapodV3Top → MAGI_Assemblyy/MG996R_servo  [rigid] internal
[14:58:01]   Revolute_5           MAGI_Assemblyy/MG996R_servo → MAGI_Assemblyy/HQpod_Coxal_Left_v2  [revolute] internal
[14:58:01]   Rigid_6              MAGI_Assemblyy/HQpod_Coxal_Left_v2 → MAGI_Assemblyy/MG996R_servo  [rigid] internal
[14:58:01]   Revolute_7           MAGI_Assemblyy/MG996R_servo → MAGI_Assemblyy/HQpod_Femur  [revolute] internal
[14:58:01]   Revolute_8           MAGI_Assemblyy/HQpod_Femur → MAGI_Assemblyy/MG996R_servo  [revolute] internal
[14:58:01]   Rigid_10             MAGI_Assemblyy/HexapodV3Top → MAGI_Assemblyy/MG996R_servo  [rigid] internal
[14:58:01]   Revolute_12          MAGI_Assemblyy/MG996R_servo → MAGI_Assemblyy/HQpod_Coxal_Left_v2  [revolute] internal
[14:58:01]   Rigid_13             MAGI_Assemblyy/HQpod_Coxal_Left_v2 → MAGI_Assemblyy/MG996R_servo  [rigid] internal
[14:58:01]   Revolute_14          MAGI_Assemblyy/MG996R_servo → MAGI_Assemblyy/HQpod_Femur  [revolute] internal
[14:58:01]   Revolute_15          MAGI_Assemblyy/HQpod_Femur → MAGI_Assemblyy/MG996R_servo  [revolute] internal
[14:58:01]   Rigid_17             MAGI_Assemblyy/HexapodV3Top → MAGI_Assemblyy/MG996R_servo  [rigid] internal
[14:58:01]   Revolute_18          MAGI_Assemblyy/MG996R_servo → MAGI_Assemblyy/HQpod_Coxal_Right_v2  [revolute] internal
[14:58:01]   Rigid_19             MAGI_Assemblyy/HQpod_Coxal_Right_v2 → MAGI_Assemblyy/MG996R_servo  [rigid] internal
[14:58:01]   Revolute_20          MAGI_Assemblyy/MG996R_servo → MAGI_Assemblyy/HQpod_Femur  [revolute] internal
[14:58:01]   Revolute_21          MAGI_Assemblyy/HQpod_Femur → MAGI_Assemblyy/MG996R_servo  [revolute] internal
[14:58:01]   Revolute_24          MAGI_Assemblyy/MG996R_servo → MAGI_Assemblyy/HQpod_Coxal_Right_v2  [revolute] internal
[14:58:01]   Rigid_25             MAGI_Assemblyy/HQpod_Coxal_Right_v2 → MAGI_Assemblyy/MG996R_servo  [rigid] internal
[14:58:01]   Revolute_26          MAGI_Assemblyy/MG996R_servo → MAGI_Assemblyy/HQpod_Femur  [revolute] internal
[14:58:01]   Revolute_27          MAGI_Assemblyy/HQpod_Femur → MAGI_Assemblyy/MG996R_servo  [revolute] internal
[14:58:01]   Rigid_29             MAGI_Assemblyy/HexapodV3Top → MAGI_Assemblyy/MG996R_servo  [rigid] internal
[14:58:01]   Rigid_31             MAGI_Assemblyy/MG996R_servo → MAGI_Assemblyy/HQpod_Tibia_Left_New  [rigid] internal
[14:58:01]   Rigid_32             MAGI_Assemblyy/MG996R_servo → MAGI_Assemblyy/HQpod_Tibia_Left_New  [rigid] internal
[14:58:01]   Rigid_33             MAGI_Assemblyy/MG996R_servo → MAGI_Assemblyy/HQpod_Tibia_Right_New  [rigid] internal
[14:58:01]   Rigid_34             MAGI_Assemblyy/MG996R_servo → MAGI_Assemblyy/HQpod_Tibia_Right_New  [rigid] internal
[14:58:01] 
=== MODEL: DETECT ROOT ===
[14:58:01]   Parent-only nodes: 1
[14:58:01]     MAGI_Assemblyy/base_link
[14:58:01]   → Root: MAGI_Assemblyy/base_link
[14:58:01] 
=== MODEL: RESOLVE NAMES ===
[14:58:01]   Name collisions: {'HQpod_Femur', 'HQpod_Tibia_Right_New', 'HQpod_Coxal_Left_v2', 'MG996R_servo', 'HQpod_Tibia_Left_New', 'HQpod_Coxal_Right_v2'}
[14:58:01]   HQpod_Coxal_Left_v2 (MAGI_Assemblyy) → MAGI_Assemblyy_HQpod_Coxal_Left_v2
[14:58:01]   HQpod_Coxal_Left_v2 (MAGI_Assemblyy) → MAGI_Assemblyy_HQpod_Coxal_Left_v2_2
[14:58:01]   HQpod_Coxal_Right_v2 (MAGI_Assemblyy) → MAGI_Assemblyy_HQpod_Coxal_Right_v2
[14:58:01]   HQpod_Coxal_Right_v2 (MAGI_Assemblyy) → MAGI_Assemblyy_HQpod_Coxal_Right_v2_2
[14:58:01]   HQpod_Femur (MAGI_Assemblyy) → MAGI_Assemblyy_HQpod_Femur
[14:58:01]   HQpod_Femur (MAGI_Assemblyy) → MAGI_Assemblyy_HQpod_Femur_2
[14:58:01]   HQpod_Femur (MAGI_Assemblyy) → MAGI_Assemblyy_HQpod_Femur_3
[14:58:01]   HQpod_Femur (MAGI_Assemblyy) → MAGI_Assemblyy_HQpod_Femur_4
[14:58:01]   HQpod_Tibia_Left_New (MAGI_Assemblyy) → MAGI_Assemblyy_HQpod_Tibia_Left_New
[14:58:01]   HQpod_Tibia_Left_New (MAGI_Assemblyy) → MAGI_Assemblyy_HQpod_Tibia_Left_New_2
[14:58:01]   HQpod_Tibia_Right_New (MAGI_Assemblyy) → MAGI_Assemblyy_HQpod_Tibia_Right_New
[14:58:01]   HQpod_Tibia_Right_New (MAGI_Assemblyy) → MAGI_Assemblyy_HQpod_Tibia_Right_New_2
[14:58:01]   HexapodV3Mid (MAGI_Assemblyy) → HexapodV3Mid
[14:58:01]   HexapodV3Top (MAGI_Assemblyy) → HexapodV3Top
[14:58:01]   MG996R_servo (MAGI_Assemblyy) → MAGI_Assemblyy_MG996R_servo
[14:58:01]   MG996R_servo (MAGI_Assemblyy) → MAGI_Assemblyy_MG996R_servo_2
[14:58:01]   MG996R_servo (MAGI_Assemblyy) → MAGI_Assemblyy_MG996R_servo_3
[14:58:01]   MG996R_servo (MAGI_Assemblyy) → MAGI_Assemblyy_MG996R_servo_4
[14:58:01]   MG996R_servo (MAGI_Assemblyy) → MAGI_Assemblyy_MG996R_servo_5
[14:58:01]   MG996R_servo (MAGI_Assemblyy) → MAGI_Assemblyy_MG996R_servo_6
[14:58:01]   MG996R_servo (MAGI_Assemblyy) → MAGI_Assemblyy_MG996R_servo_7
[14:58:01]   MG996R_servo (MAGI_Assemblyy) → MAGI_Assemblyy_MG996R_servo_8
[14:58:01]   MG996R_servo (MAGI_Assemblyy) → MAGI_Assemblyy_MG996R_servo_9
[14:58:01]   MG996R_servo (MAGI_Assemblyy) → MAGI_Assemblyy_MG996R_servo_10
[14:58:01]   MG996R_servo (MAGI_Assemblyy) → MAGI_Assemblyy_MG996R_servo_11
[14:58:01]   MG996R_servo (MAGI_Assemblyy) → MAGI_Assemblyy_MG996R_servo_12
[14:58:01]   base_link (MAGI_Assemblyy) → base_link
[14:58:01]   Root link URDF name: base_link
[14:58:01] 
=== MODEL: BUILD LINKS ===
[14:58:01]   Built 27 links
[14:58:01] 
=== MODEL: BUILD JOINTS ===
[14:58:01]   NOTE: joint origin rpy derived from child occurrence's transform2 rotation (was hardcoded 0,0,0 pre-2026-04-13)
[14:58:01]   Rigid_1: base_link → HexapodV3Mid [fixed]
[14:58:01]     origin_xyz: (0.113207, 1.351156, -0.242000) m [child_minus_parent]
[14:58:01]     origin_global: (0.210233, 2.405051, -0.093500) m
[14:58:01]   Rigid_2: HexapodV3Mid → HexapodV3Top [fixed]
[14:58:01]     origin_xyz: (-0.074434, -2.851566, 0.152148) m [child_minus_parent]
[14:58:01]     origin_global: (0.135798, -0.529120, 0.061646) m
[14:58:01]   Rigid_4: joint origin rpy = (1.570796, 0.000000, 0.785398) rad (+90.00°, +0.00°, +45.00°) [from child transform2 rotation]
[14:58:01]   Rigid_4: HexapodV3Top → MAGI_Assemblyy_MG996R_servo [fixed]
[14:58:01]     origin_xyz: (0.054925, 2.437386, 0.211602) m [child_minus_parent]
[14:58:01]     origin_global: (0.291826, 0.920854, 1.086656) m
[14:58:01]   Rigid_10: joint origin rpy = (1.570796, 0.000000, -2.356194) rad (+90.00°, +0.00°, -135.00°) [from child transform2 rotation]
[14:58:01]   Rigid_10: HexapodV3Top → MAGI_Assemblyy_MG996R_servo_8 [fixed]
[14:58:01]     origin_xyz: (0.243915, 2.588642, 0.211602) m [child_minus_parent]
[14:58:01]     origin_global: (0.000422, 1.020217, 1.182052) m
[14:58:01]   Rigid_17: joint origin rpy = (1.570796, -0.000000, 2.356194) rad (+90.00°, -0.00°, +135.00°) [from child transform2 rotation]
[14:58:01]   Rigid_17: HexapodV3Top → MAGI_Assemblyy_MG996R_servo_11 [fixed]
[14:58:01]     origin_xyz: (0.244023, 2.437165, 0.210956) m [child_minus_parent]
[14:58:01]     origin_global: (0.185554, 1.248248, 1.058707) m
[14:58:01]   Rigid_29: joint origin rpy = (1.570796, -0.000000, -0.785398) rad (+90.00°, -0.00°, -45.00°) [from child transform2 rotation]
[14:58:01]   Rigid_29: HexapodV3Top → MAGI_Assemblyy_MG996R_servo_5 [fixed]
[14:58:01]     origin_xyz: (0.054739, 2.588547, 0.210956) m [child_minus_parent]
[14:58:01]     origin_global: (0.053109, 0.914289, 1.215464) m
[14:58:01]   Revolute_5: mesh bake offset = (-101.01, -944.29, -161.74) mm [child-local frame]
[14:58:01]   Revolute_5: joint origin rpy = (0.014889, -0.000012, -1.570790) rad (+0.85°, -0.00°, -90.00°) [from child transform2 rotation]
[14:58:01]   Revolute_5: origin_xyz rotated into parent-local frame: (0.291665, 0.258679, 0.569011) → (0.389152, 0.569011, 0.023325) m
[14:58:01]  Revolute_5: axis remapped world -> joint/child frame: (0.000, 0.000, 1.000) -> (-1.000, 0.000, 0.000)
[14:58:01]   Revolute_5: MAGI_Assemblyy_MG996R_servo → MAGI_Assemblyy_HQpod_Coxal_Left_v2 [revolute]
[14:58:01]     origin_xyz: (0.389152, 0.569011, 0.023325) m [joint_minus_parent]
[14:58:01]     origin_global: (0.385362, 1.195655, 0.690761) m
[14:58:01]   Revolute_12: mesh bake offset = (-275.37, -1080.91, -161.74) mm [child-local frame]
[14:58:01]   Revolute_12: joint origin rpy = (0.014889, -0.000012, -1.570790) rad (+0.85°, -0.00°, -90.00°) [from child transform2 rotation]
[14:58:01]   Revolute_12: origin_xyz rotated into parent-local frame: (-0.389700, -0.353834, 0.394657) → (0.525758, 0.394657, 0.025361) m
[14:58:01]  Revolute_12: axis remapped world -> joint/child frame: (-0.000, 0.000, 1.000) -> (-1.000, 0.000, 0.000)
[14:58:01]   Revolute_12: MAGI_Assemblyy_MG996R_servo_8 → MAGI_Assemblyy_HQpod_Coxal_Left_v2_2 [revolute]
[14:58:01]     origin_xyz: (0.525758, 0.394657, 0.025361) m [joint_minus_parent]
[14:58:01]     origin_global: (-0.107012, 0.734398, 0.516407) m
[14:58:01]   Revolute_18: mesh bake offset = (-275.48, -944.07, -161.10) mm [child-local frame]
[14:58:01]   Revolute_18: joint origin rpy = (3.121082, 0.000002, -1.570793) rad (+178.82°, +0.00°, -90.00°) [from child transform2 rotation]
[14:58:01]   Revolute_18: origin_xyz rotated into parent-local frame: (0.838529, -0.828145, 0.396542) → (-1.178517, 0.396542, 0.007343) m
[14:58:01]  Revolute_18: axis remapped world -> joint/child frame: (-0.000, 0.000, 1.000) -> (-1.000, -0.000, 0.000)
[14:58:01]   Revolute_18: MAGI_Assemblyy_MG996R_servo_11 → MAGI_Assemblyy_HQpod_Coxal_Right_v2 [revolute]
[14:58:01]     origin_xyz: (-1.178517, 0.396542, 0.007343) m [joint_minus_parent]
[14:58:01]     origin_global: (1.121325, 0.108610, 0.517646) m
[14:58:01]   Revolute_24: mesh bake offset = (-100.83, -1080.82, -161.10) mm [child-local frame]
[14:58:01]   Revolute_24: joint origin rpy = (3.121082, 0.000002, -1.570793) rad (+178.82°, +0.00°, -90.00°) [from child transform2 rotation]
[14:58:01]   Revolute_24: origin_xyz rotated into parent-local frame: (-0.937187, 0.922836, 0.571189) → (-1.315235, 0.571189, 0.010147) m
[14:58:01]  Revolute_24: axis remapped world -> joint/child frame: (-0.000, 0.000, 1.000) -> (-1.000, -0.000, 0.000)
[14:58:01]   Revolute_24: MAGI_Assemblyy_MG996R_servo_5 → MAGI_Assemblyy_HQpod_Coxal_Right_v2_2 [revolute]
[14:58:01]     origin_xyz: (-1.315235, 0.571189, 0.010147) m [joint_minus_parent]
[14:58:01]     origin_global: (-0.843675, 2.010973, 0.692293) m
[14:58:01]   Rigid_6: parent bake correction += (-790.24, -541.64, 101.01) mm [world frame]
[14:58:01]   Rigid_6: joint origin rpy = (-1.570796, 0.000001, -3.141593) rad (-90.00°, +0.00°, -180.00°) [from child transform2 rotation]
[14:58:01]   Rigid_6: origin_xyz rotated into parent-local frame: (-0.300345, -0.298625, -0.573417) → (0.573414, -0.423511, 0.005083) m
[14:58:01]   Rigid_6: MAGI_Assemblyy_HQpod_Coxal_Left_v2 → MAGI_Assemblyy_MG996R_servo_6 [fixed]
[14:58:01]     origin_xyz: (0.573414, -0.423511, 0.005083) m [child_minus_parent]
[14:58:01]     origin_global: (-0.668339, 1.440794, 0.178041) m
[14:58:01]   Rigid_13: parent bake correction += (888.27, 636.80, 275.36) mm [world frame]
[14:58:01]   Rigid_13: joint origin rpy = (-1.570796, 0.000001, -3.141593) rad (-90.00°, +0.00°, -180.00°) [from child transform2 rotation]
[14:58:01]   Rigid_13: origin_xyz rotated into parent-local frame: (0.398051, 0.394361, -0.399161) → (0.399157, -0.560299, 0.005729) m
[14:58:01]   Rigid_13: MAGI_Assemblyy_HQpod_Coxal_Left_v2_2 → MAGI_Assemblyy_MG996R_servo_9 [fixed]
[14:58:01]     origin_xyz: (0.399157, -0.560299, 0.005729) m [child_minus_parent]
[14:58:01]     origin_global: (1.145863, 0.410975, 0.433028) m
[14:58:01]   Rigid_19: parent bake correction += (-569.56, 769.95, 275.48) mm [world frame]
[14:58:01]   Rigid_19: joint origin rpy = (-1.570795, 0.000001, -3.141593) rad (-90.00°, +0.00°, -180.00°) [from child transform2 rotation]
[14:58:01]   Rigid_19: origin_xyz rotated into parent-local frame: (-0.829584, 0.788290, -0.400947) → (0.400950, -1.144367, 0.005729) m
[14:58:01]   Rigid_19: MAGI_Assemblyy_HQpod_Coxal_Right_v2 → MAGI_Assemblyy_MG996R_servo_12 [fixed]
[14:58:01]     origin_xyz: (0.400950, -1.144367, 0.005729) m [child_minus_parent]
[14:58:01]     origin_global: (0.808971, 1.668587, 0.432645) m
[14:58:01]   Rigid_25: parent bake correction += (668.21, -864.64, 100.83) mm [world frame]
[14:58:01]   Rigid_25: joint origin rpy = (-1.570795, 0.000001, -3.141593) rad (-90.00°, +0.00°, -180.00°) [from child transform2 rotation]
[14:58:01]   Rigid_25: origin_xyz rotated into parent-local frame: (0.928230, -0.882970, -0.575629) → (0.575633, -1.281097, 0.005729) m
[14:58:01]   Rigid_25: MAGI_Assemblyy_HQpod_Coxal_Right_v2_2 → MAGI_Assemblyy_MG996R_servo_4 [fixed]
[14:58:01]     origin_xyz: (0.575633, -1.281097, 0.005729) m [child_minus_parent]
[14:58:01]     origin_global: (-0.563005, 0.220576, 0.184225) m
[14:58:01]   Revolute_7: mesh bake offset = (-57.16, -925.73, -127.69) mm [child-local frame]
[14:58:01]   Revolute_7: joint origin rpy = (-1.570796, 1.047198, 0.000000) rad (-90.00°, +60.00°, +0.00°) [from child transform2 rotation]
[14:58:01]   Revolute_7: origin_xyz rotated into parent-local frame: (0.590963, 0.031068, -0.061216) → (-0.061224, -0.389313, -0.445687) m
[14:58:01]  Revolute_7: axis remapped world -> joint/child frame: (-0.697, 0.718, -0.000) -> (-0.000, 0.000, 1.000)
[14:58:01]   Revolute_7: MAGI_Assemblyy_MG996R_servo_6 → MAGI_Assemblyy_HQpod_Femur [revolute]
[14:58:01]     origin_xyz: (-0.061224, -0.389313, -0.445687) m [joint_minus_parent]
[14:58:01]     origin_global: (0.675981, 0.928098, 0.056128) m
[14:58:01]   Revolute_14: mesh bake offset = (-318.89, -1100.06, -127.59) mm [child-local frame]
[14:58:01]   Revolute_14: joint origin rpy = (1.570796, -1.047198, 3.141593) rad (+90.00°, -60.00°, +180.00°) [from child transform2 rotation]
[14:58:01]   Revolute_14: origin_xyz rotated into parent-local frame: (0.310094, 0.843685, 0.072694) → (0.072694, -0.389411, 0.810137) m
[14:58:01]  Revolute_14: axis remapped world -> joint/child frame: (0.697, -0.718, -0.000) -> (0.000, -0.000, 1.000)
[14:58:01]   Revolute_14: MAGI_Assemblyy_MG996R_servo_9 → MAGI_Assemblyy_HQpod_Femur_2 [revolute]
[14:58:01]     origin_xyz: (0.072694, -0.389411, 0.810137) m [joint_minus_parent]
[14:58:01]     origin_global: (0.601133, 1.972444, 0.189940) m
[14:58:01]   Revolute_20: mesh bake offset = (-319.44, -925.75, -127.05) mm [child-local frame]
[14:58:01]   Revolute_20: joint origin rpy = (1.570796, 1.047198, -3.141593) rad (+90.00°, +60.00°, -180.00°) [from child transform2 rotation]
[14:58:01]   Revolute_20: origin_xyz rotated into parent-local frame: (0.046473, -0.585117, -0.571740) → (-0.571739, -0.389958, -0.438697) m
[14:58:01]  Revolute_20: axis remapped world -> joint/child frame: (0.692, 0.721, -0.000) -> (-0.000, -0.000, 1.000)
[14:58:01]   Revolute_20: MAGI_Assemblyy_MG996R_servo_12 → MAGI_Assemblyy_HQpod_Femur_3 [revolute]
[14:58:01]     origin_xyz: (-0.571739, -0.389958, -0.438697) m [joint_minus_parent]
[14:58:01]     origin_global: (0.338214, 0.311783, -0.455041) m
[14:58:01]   Revolute_26: mesh bake offset = (-56.86, -1099.15, -127.01) mm [child-local frame]
[14:58:01]   Revolute_26: joint origin rpy = (1.570796, 1.047198, -3.141593) rad (+90.00°, +60.00°, -180.00°) [from child transform2 rotation]
[14:58:01]   Revolute_26: origin_xyz rotated into parent-local frame: (0.180158, 0.367647, -0.590615) → (-0.590615, -0.389993, -0.124604) m
[14:58:01]  Revolute_26: axis remapped world -> joint/child frame: (-0.692, -0.721, -0.000) -> (-0.000, -0.000, 1.000)
[14:58:01]   Revolute_26: MAGI_Assemblyy_MG996R_servo_4 → MAGI_Assemblyy_HQpod_Femur_4 [revolute]
[14:58:01]     origin_xyz: (-0.590615, -0.389993, -0.124604) m [joint_minus_parent]
[14:58:01]     origin_global: (0.264713, 1.495650, -0.473951) m
[14:58:01]   Revolute_8: mesh bake offset = (-20.84, -890.47, -98.35) mm [child-local frame]
[14:58:01]   Revolute_8: parent bake correction += (-278.72, -448.49, 773.12) mm [world frame]
[14:58:01]   Revolute_8: joint origin rpy = (1.570796, 0.000000, 3.141593) rad (+90.00°, +0.00°, +180.00°) [from child transform2 rotation]
[14:58:01]   Revolute_8: origin_xyz rotated into parent-local frame: (-1.218731, 0.600566, -0.048208) → (-0.419186, -0.186374, 1.279788) m
[14:58:01]  Revolute_8: axis remapped world -> joint/child frame: (-0.697, 0.718, -0.000) -> (-0.000, 1.000, 0.000)
[14:58:01]   Revolute_8: MAGI_Assemblyy_HQpod_Femur → MAGI_Assemblyy_MG996R_servo_7 [revolute]
[14:58:01]     origin_xyz: (-0.419186, -0.186374, 1.279788) m [joint_minus_parent]
[14:58:01]     origin_global: (-0.542750, 1.528664, 0.007920) m
[14:58:01]   Revolute_15: mesh bake offset = (-355.21, -1135.31, -98.26) mm [child-local frame]
[14:58:01]   Revolute_15: parent bake correction += (-681.73, -483.89, -793.23) mm [world frame]
[14:58:01]   Revolute_15: joint origin rpy = (1.570796, -0.000000, -0.000000) rad (+90.00°, -0.00°, -0.00°) [from child transform2 rotation]
[14:58:01]   Revolute_15: origin_xyz rotated into parent-local frame: (0.696023, -1.449282, -0.349223) → (-0.267059, -0.557417, 1.524726) m
[14:58:01]  Revolute_15: axis remapped world -> joint/child frame: (0.697, -0.718, -0.000) -> (0.000, 1.000, 0.000)
[14:58:01]   Revolute_15: MAGI_Assemblyy_HQpod_Femur_2 → MAGI_Assemblyy_MG996R_servo_10 [revolute]
[14:58:01]     origin_xyz: (-0.267059, -0.557417, 1.524726) m [joint_minus_parent]
[14:58:01]     origin_global: (1.297156, 0.523162, -0.159284) m
[14:58:01]   Revolute_21: mesh bake offset = (-356.02, -890.64, -97.88) mm [child-local frame]
[14:58:01]   Revolute_21: parent bake correction += (46.39, -220.62, 961.44) mm [world frame]
[14:58:01]   Revolute_21: joint origin rpy = (1.570796, 0.000000, 0.000000) rad (+90.00°, +0.00°, +0.00°) [from child transform2 rotation]
[14:58:01]   Revolute_21: origin_xyz rotated into parent-local frame: (0.858130, 0.951373, 0.464852) → (-0.266789, -0.382737, 1.280594) m
[14:58:01]  Revolute_21: axis remapped world -> joint/child frame: (0.692, 0.721, -0.000) -> (-0.000, 1.000, 0.000)
[14:58:01]   Revolute_21: MAGI_Assemblyy_HQpod_Femur_3 → MAGI_Assemblyy_MG996R_servo_2 [revolute]
[14:58:01]     origin_xyz: (-0.266789, -0.382737, 1.280594) m [joint_minus_parent]
[14:58:01]     origin_global: (1.196344, 1.263156, 0.009812) m
[14:58:01]   Revolute_27: mesh bake offset = (-20.27, -1134.27, -97.85) mm [child-local frame]
[14:58:01]   Revolute_27: parent bake correction += (-273.02, 438.09, 980.32) mm [world frame]
[14:58:01]   Revolute_27: joint origin rpy = (1.570796, 0.000000, 0.000000) rad (+90.00°, +0.00°, +0.00°) [from child transform2 rotation]
[14:58:01]   Revolute_27: origin_xyz rotated into parent-local frame: (-1.043672, -1.111030, 0.651574) → (-0.339967, -0.556097, 1.524259) m
[14:58:01]  Revolute_27: axis remapped world -> joint/child frame: (-0.692, -0.721, -0.000) -> (-0.000, 1.000, 0.000)
[14:58:01]   Revolute_27: MAGI_Assemblyy_HQpod_Femur_4 → MAGI_Assemblyy_MG996R_servo_3 [revolute]
[14:58:01]     origin_xyz: (-0.339967, -0.556097, 1.524259) m [joint_minus_parent]
[14:58:01]     origin_global: (-0.778959, 0.384620, 0.177623) m
[14:58:01]   Rigid_32: parent bake correction += (597.88, -660.64, 95.61) mm [world frame]
[14:58:01]   Rigid_32: joint origin rpy = (-3.141590, -1.570795, -1.570796) rad (-180.00°, -90.00°, -90.00°) [from child transform2 rotation]
[14:58:01]   Rigid_32: origin_xyz rotated into parent-local frame: (0.344568, -0.675422, 0.646160) → (-0.129796, -0.724653, -0.671175) m
[14:58:01]   Rigid_32: MAGI_Assemblyy_MG996R_servo_7 → MAGI_Assemblyy_HQpod_Tibia_Left_New_2 [fixed]
[14:58:01]     origin_xyz: (-0.129796, -0.724653, -0.671175) m [child_minus_parent]
[14:58:01]     origin_global: (0.395549, 1.322319, 1.078813) m
[14:58:01]   Rigid_31: parent bake correction += (-976.23, 634.61, 262.71) mm [world frame]
[14:58:01]   Rigid_31: joint origin rpy = (-3.141590, -1.570795, -1.570796) rad (-180.00°, -90.00°, -90.00°) [from child transform2 rotation]
[14:58:01]   Rigid_31: origin_xyz rotated into parent-local frame: (-0.722934, 0.649369, 0.813296) → (-0.464202, -0.969493, -0.671092) m
[14:58:01]   Rigid_31: MAGI_Assemblyy_MG996R_servo_10 → MAGI_Assemblyy_HQpod_Tibia_Left_New [fixed]
[14:58:01]     origin_xyz: (-0.464202, -0.969493, -0.671092) m [child_minus_parent]
[14:58:01]     origin_global: (-0.342435, 0.401941, 0.915150) m
[14:58:01]   Rigid_34: parent bake correction += (-874.48, -395.17, 93.25) mm [world frame]
[14:58:01]   Rigid_34: joint origin rpy = (0.000002, -1.570795, 1.570796) rad (+0.00°, -90.00°, +90.00°) [from child transform2 rotation]
[14:58:01]   Rigid_34: origin_xyz rotated into parent-local frame: (-0.514683, -0.510655, 0.899333) → (-0.465013, -0.724814, 0.769983) m
[14:58:01]   Rigid_34: MAGI_Assemblyy_MG996R_servo_2 → MAGI_Assemblyy_HQpod_Tibia_Right_New_2 [fixed]
[14:58:01]     origin_xyz: (-0.465013, -0.724814, 0.769983) m [child_minus_parent]
[14:58:01]     origin_global: (0.218948, 1.078603, 1.661885) m
[14:58:01]   Rigid_33: parent bake correction += (833.39, 772.29, -74.60) mm [world frame]
[14:58:01]   Rigid_33: joint origin rpy = (0.000002, -1.570795, 1.570796) rad (+0.00°, -90.00°, +90.00°) [from child transform2 rotation]
[14:58:01]   Rigid_33: origin_xyz rotated into parent-local frame: (0.473579, 0.887797, 0.731455) → (-0.129226, -0.968444, 0.770002) m
[14:58:01]   Rigid_33: MAGI_Assemblyy_MG996R_servo_3 → MAGI_Assemblyy_HQpod_Tibia_Right_New [fixed]
[14:58:01]     origin_xyz: (-0.129226, -0.968444, 0.770002) m [child_minus_parent]
[14:58:01]     origin_global: (0.469753, 0.634405, 1.496069) m
[14:58:01]   Built 26 joints
[14:58:01] 
=== MODEL: VALIDATE ===
[14:58:01]   Validation passed (0 warnings)
[14:58:01] 
[14:58:01] Kinematic tree:
[14:58:01]   base_link (461g)
[14:58:01]     ─── Rigid_1 [fixed]
[14:58:01]       HexapodV3Mid (431g)
[14:58:01]         ─── Rigid_2 [fixed]
[14:58:01]           HexapodV3Top (1329g)
[14:58:01]             ─── Rigid_4 [fixed]
[14:58:01]               MAGI_Assemblyy_MG996R_servo (240g)
[14:58:01]                 ─⟳─ Revolute_5 [revolute]
[14:58:01]                   MAGI_Assemblyy_HQpod_Coxal_Left_v2 (266g)
[14:58:01]                     ─── Rigid_6 [fixed]
[14:58:01]                       MAGI_Assemblyy_MG996R_servo_6 (240g)
[14:58:01]                         ─⟳─ Revolute_7 [revolute]
[14:58:01]                           MAGI_Assemblyy_HQpod_Femur (176g)
[14:58:01]                             ─⟳─ Revolute_8 [revolute]
[14:58:01]                               MAGI_Assemblyy_MG996R_servo_7 (240g)
[14:58:01]                                 ─── Rigid_32 [fixed]
[14:58:01]                                   MAGI_Assemblyy_HQpod_Tibia_Left_New_2 (251g)
[14:58:01]             ─── Rigid_10 [fixed]
[14:58:01]               MAGI_Assemblyy_MG996R_servo_8 (240g)
[14:58:01]                 ─⟳─ Revolute_12 [revolute]
[14:58:01]                   MAGI_Assemblyy_HQpod_Coxal_Left_v2_2 (266g)
[14:58:01]                     ─── Rigid_13 [fixed]
[14:58:01]                       MAGI_Assemblyy_MG996R_servo_9 (240g)
[14:58:01]                         ─⟳─ Revolute_14 [revolute]
[14:58:01]                           MAGI_Assemblyy_HQpod_Femur_2 (176g)
[14:58:01]                             ─⟳─ Revolute_15 [revolute]
[14:58:01]                               MAGI_Assemblyy_MG996R_servo_10 (240g)
[14:58:01]                                 ─── Rigid_31 [fixed]
[14:58:01]                                   MAGI_Assemblyy_HQpod_Tibia_Left_New (251g)
[14:58:01]             ─── Rigid_17 [fixed]
[14:58:01]               MAGI_Assemblyy_MG996R_servo_11 (240g)
[14:58:01]                 ─⟳─ Revolute_18 [revolute]
[14:58:01]                   MAGI_Assemblyy_HQpod_Coxal_Right_v2 (266g)
[14:58:01]                     ─── Rigid_19 [fixed]
[14:58:01]                       MAGI_Assemblyy_MG996R_servo_12 (240g)
[14:58:01]                         ─⟳─ Revolute_20 [revolute]
[14:58:01]                           MAGI_Assemblyy_HQpod_Femur_3 (176g)
[14:58:01]                             ─⟳─ Revolute_21 [revolute]
[14:58:01]                               MAGI_Assemblyy_MG996R_servo_2 (240g)
[14:58:01]                                 ─── Rigid_34 [fixed]
[14:58:01]                                   MAGI_Assemblyy_HQpod_Tibia_Right_New_2 (252g)
[14:58:01]             ─── Rigid_29 [fixed]
[14:58:01]               MAGI_Assemblyy_MG996R_servo_5 (240g)
[14:58:01]                 ─⟳─ Revolute_24 [revolute]
[14:58:01]                   MAGI_Assemblyy_HQpod_Coxal_Right_v2_2 (266g)
[14:58:01]                     ─── Rigid_25 [fixed]
[14:58:01]                       MAGI_Assemblyy_MG996R_servo_4 (240g)
[14:58:01]                         ─⟳─ Revolute_26 [revolute]
[14:58:01]                           MAGI_Assemblyy_HQpod_Femur_4 (176g)
[14:58:01]                             ─⟳─ Revolute_27 [revolute]
[14:58:01]                               MAGI_Assemblyy_MG996R_servo_3 (240g)
[14:58:01]                                 ─── Rigid_33 [fixed]
[14:58:01]                                   MAGI_Assemblyy_HQpod_Tibia_Right_New (252g)
[14:58:01] 
=== MODEL SUMMARY ===
[14:58:01]   Robot: MAGI_Assemblyy
[14:58:01]   Root link: base_link
[14:58:01]   Links: 27
[14:58:01]   Joints: 26
[14:58:01]   Assemblies: 1
[14:58:01]   Warnings: 0
[14:58:01]   Errors: 0
[14:58:05] 
=== MESH EXPORT ===
[14:58:05]   base_link:
[14:58:06]     OBJ exported (297898 bytes)
[14:58:06]     MTL preserved from Fusion (multi-material)
[14:58:06]     DAE written → meshes/MAGI_Assemblyy/base_link.dae (OBJ retained for collision fit)
[14:58:06]   HexapodV3Mid:
[14:58:06]     OBJ exported (579702 bytes)
[14:58:06]     MTL preserved from Fusion (multi-material)
[14:58:06]     DAE written → meshes/MAGI_Assemblyy/HexapodV3Mid.dae (OBJ retained for collision fit)
[14:58:06]   HexapodV3Top:
[14:58:07]     OBJ exported (2912889 bytes)
[14:58:07]     MTL preserved from Fusion (multi-material)
[14:58:07]     DAE written → meshes/MAGI_Assemblyy/HexapodV3Top.dae (OBJ retained for collision fit)
[14:58:07]   MAGI_Assemblyy_MG996R_servo:
[14:58:07]     OBJ exported (2515766 bytes)
[14:58:07]     MTL preserved from Fusion (multi-material)
[14:58:08]     DAE written → meshes/MAGI_Assemblyy/MAGI_Assemblyy_MG996R_servo.dae (OBJ retained for collision fit)
[14:58:08]   MAGI_Assemblyy_HQpod_Coxal_Left_v2:
[14:58:08]     OBJ exported (1125351 bytes)
[14:58:08]     MTL preserved from Fusion (multi-material)
[14:58:08]     DAE written → meshes/MAGI_Assemblyy/MAGI_Assemblyy_HQpod_Coxal_Left_v2.dae (OBJ retained for collision fit)
[14:58:08]   MAGI_Assemblyy_MG996R_servo_6:
[14:58:09]     OBJ exported (2515768 bytes)
[14:58:09]     MTL preserved from Fusion (multi-material)
[14:58:09]     DAE written → meshes/MAGI_Assemblyy/MAGI_Assemblyy_MG996R_servo_6.dae (OBJ retained for collision fit)
[14:58:09]   MAGI_Assemblyy_HQpod_Femur:
[14:58:09]     OBJ exported (153933 bytes)
[14:58:09]     MTL preserved from Fusion (multi-material)
[14:58:09]     DAE written → meshes/MAGI_Assemblyy/MAGI_Assemblyy_HQpod_Femur.dae (OBJ retained for collision fit)
[14:58:09]   MAGI_Assemblyy_MG996R_servo_7:
[14:58:09]     OBJ exported (2515768 bytes)
[14:58:09]     MTL preserved from Fusion (multi-material)
[14:58:10]     DAE written → meshes/MAGI_Assemblyy/MAGI_Assemblyy_MG996R_servo_7.dae (OBJ retained for collision fit)
[14:58:10]   MAGI_Assemblyy_MG996R_servo_8:
[14:58:10]     OBJ exported (2515768 bytes)
[14:58:10]     MTL preserved from Fusion (multi-material)
[14:58:10]     DAE written → meshes/MAGI_Assemblyy/MAGI_Assemblyy_MG996R_servo_8.dae (OBJ retained for collision fit)
[14:58:10]   MAGI_Assemblyy_HQpod_Coxal_Left_v2_2:
[14:58:10]     OBJ exported (1125353 bytes)
[14:58:10]     MTL preserved from Fusion (multi-material)
[14:58:10]     DAE written → meshes/MAGI_Assemblyy/MAGI_Assemblyy_HQpod_Coxal_Left_v2_2.dae (OBJ retained for collision fit)
[14:58:10]   MAGI_Assemblyy_MG996R_servo_9:
[14:58:11]     OBJ exported (2515768 bytes)
[14:58:11]     MTL preserved from Fusion (multi-material)
[14:58:11]     DAE written → meshes/MAGI_Assemblyy/MAGI_Assemblyy_MG996R_servo_9.dae (OBJ retained for collision fit)
[14:58:11]   MAGI_Assemblyy_HQpod_Femur_2:
[14:58:11]     OBJ exported (153935 bytes)
[14:58:11]     MTL preserved from Fusion (multi-material)
[14:58:11]     DAE written → meshes/MAGI_Assemblyy/MAGI_Assemblyy_HQpod_Femur_2.dae (OBJ retained for collision fit)
[14:58:11]   MAGI_Assemblyy_MG996R_servo_10:
[14:58:11]     OBJ exported (2515769 bytes)
[14:58:11]     MTL preserved from Fusion (multi-material)
[14:58:12]     DAE written → meshes/MAGI_Assemblyy/MAGI_Assemblyy_MG996R_servo_10.dae (OBJ retained for collision fit)
[14:58:12]   MAGI_Assemblyy_MG996R_servo_11:
[14:58:12]     OBJ exported (2515769 bytes)
[14:58:12]     MTL preserved from Fusion (multi-material)
[14:58:12]     DAE written → meshes/MAGI_Assemblyy/MAGI_Assemblyy_MG996R_servo_11.dae (OBJ retained for collision fit)
[14:58:12]   MAGI_Assemblyy_HQpod_Coxal_Right_v2:
[14:58:13]     OBJ exported (988067 bytes)
[14:58:13]     MTL preserved from Fusion (multi-material)
[14:58:13]     DAE written → meshes/MAGI_Assemblyy/MAGI_Assemblyy_HQpod_Coxal_Right_v2.dae (OBJ retained for collision fit)
[14:58:13]   MAGI_Assemblyy_MG996R_servo_12:
[14:58:13]     OBJ exported (2515769 bytes)
[14:58:13]     MTL preserved from Fusion (multi-material)
[14:58:13]     DAE written → meshes/MAGI_Assemblyy/MAGI_Assemblyy_MG996R_servo_12.dae (OBJ retained for collision fit)
[14:58:13]   MAGI_Assemblyy_HQpod_Femur_3:
[14:58:13]     OBJ exported (153935 bytes)
[14:58:13]     MTL preserved from Fusion (multi-material)
[14:58:13]     DAE written → meshes/MAGI_Assemblyy/MAGI_Assemblyy_HQpod_Femur_3.dae (OBJ retained for collision fit)
[14:58:13]   MAGI_Assemblyy_MG996R_servo_2:
[14:58:14]     OBJ exported (2515768 bytes)
[14:58:14]     MTL preserved from Fusion (multi-material)
[14:58:14]     DAE written → meshes/MAGI_Assemblyy/MAGI_Assemblyy_MG996R_servo_2.dae (OBJ retained for collision fit)
[14:58:14]   MAGI_Assemblyy_MG996R_servo_3:
[14:58:14]     OBJ exported (2515768 bytes)
[14:58:14]     MTL preserved from Fusion (multi-material)
[14:58:14]     DAE written → meshes/MAGI_Assemblyy/MAGI_Assemblyy_MG996R_servo_3.dae (OBJ retained for collision fit)
[14:58:14]   MAGI_Assemblyy_HQpod_Femur_4:
[14:58:15]     OBJ exported (153935 bytes)
[14:58:15]     MTL preserved from Fusion (multi-material)
[14:58:15]     DAE written → meshes/MAGI_Assemblyy/MAGI_Assemblyy_HQpod_Femur_4.dae (OBJ retained for collision fit)
[14:58:15]   MAGI_Assemblyy_MG996R_servo_4:
[14:58:15]     OBJ exported (2515768 bytes)
[14:58:15]     MTL preserved from Fusion (multi-material)
[14:58:15]     DAE written → meshes/MAGI_Assemblyy/MAGI_Assemblyy_MG996R_servo_4.dae (OBJ retained for collision fit)
[14:58:15]   MAGI_Assemblyy_HQpod_Coxal_Right_v2_2:
[14:58:15]     OBJ exported (988069 bytes)
[14:58:15]     MTL preserved from Fusion (multi-material)
[14:58:15]     DAE written → meshes/MAGI_Assemblyy/MAGI_Assemblyy_HQpod_Coxal_Right_v2_2.dae (OBJ retained for collision fit)
[14:58:15]   MAGI_Assemblyy_MG996R_servo_5:
[14:58:16]     OBJ exported (2515768 bytes)
[14:58:16]     MTL preserved from Fusion (multi-material)
[14:58:16]     DAE written → meshes/MAGI_Assemblyy/MAGI_Assemblyy_MG996R_servo_5.dae (OBJ retained for collision fit)
[14:58:16]   MAGI_Assemblyy_HQpod_Tibia_Left_New:
[14:58:16]     OBJ exported (459885 bytes)
[14:58:16]     MTL preserved from Fusion (multi-material)
[14:58:16]     DAE written → meshes/MAGI_Assemblyy/MAGI_Assemblyy_HQpod_Tibia_Left_New.dae (OBJ retained for collision fit)
[14:58:16]   MAGI_Assemblyy_HQpod_Tibia_Left_New_2:
[14:58:16]     OBJ exported (459887 bytes)
[14:58:17]     MTL preserved from Fusion (multi-material)
[14:58:17]     DAE written → meshes/MAGI_Assemblyy/MAGI_Assemblyy_HQpod_Tibia_Left_New_2.dae (OBJ retained for collision fit)
[14:58:17]   MAGI_Assemblyy_HQpod_Tibia_Right_New:
[14:58:17]     OBJ exported (469012 bytes)
[14:58:17]     MTL preserved from Fusion (multi-material)
[14:58:17]     DAE written → meshes/MAGI_Assemblyy/MAGI_Assemblyy_HQpod_Tibia_Right_New.dae (OBJ retained for collision fit)
[14:58:17]   MAGI_Assemblyy_HQpod_Tibia_Right_New_2:
[14:58:17]     OBJ exported (469014 bytes)
[14:58:17]     MTL preserved from Fusion (multi-material)
[14:58:17]     DAE written → meshes/MAGI_Assemblyy/MAGI_Assemblyy_HQpod_Tibia_Right_New_2.dae (OBJ retained for collision fit)
[14:58:17] 
  Mesh export summary:
[14:58:17]     Visual (OBJ+MTL):              27
[14:58:17]     Collision sub-component (STL):  0
[14:58:17]     Collision body + warning (STL): 0
[14:58:17]     Skipped (no Fusion ref):        0
[14:58:17] 
=== PHASE 3: SCREENSHOT ===
[14:58:18]   → images/robot.png
[14:58:18] 
=== PACKAGE: GENERATE ===
[14:58:18]   Package: MAGI_Assemblyy_description
[14:58:18]   Output:  D:/Paras/MAGI/URDF_NEW_2\MAGI_Assemblyy_description
[14:58:18] 
=== COLLISION: RESOLVE ===
[14:58:18]   base_link: primitive (box [219.5 x 144.9 x 27.0] mm)
[14:58:18]   HexapodV3Mid: primitive (box [220.5 x 119.3 x 25.0] mm)
[14:58:18]   HexapodV3Top: primitive (box [240.0 x 197.4 x 28.8] mm)
[14:58:18]   MAGI_Assemblyy_MG996R_servo: primitive (box [53.3 x 43.5 x 20.0] mm)
[14:58:18]   MAGI_Assemblyy_HQpod_Coxal_Left_v2: primitive (box [61.2 x 74.3 x 28.8] mm)
[14:58:18]   MAGI_Assemblyy_MG996R_servo_6: primitive (box [53.3 x 43.5 x 20.0] mm)
[14:58:18]   MAGI_Assemblyy_HQpod_Femur: primitive (box [85.0 x 26.0 x 56.1] mm)
[14:58:18]   MAGI_Assemblyy_MG996R_servo_7: primitive (box [53.3 x 43.5 x 20.0] mm)
[14:58:18]   MAGI_Assemblyy_MG996R_servo_8: primitive (box [53.3 x 43.5 x 20.0] mm)
[14:58:18]   MAGI_Assemblyy_HQpod_Coxal_Left_v2_2: primitive (box [61.2 x 74.3 x 28.8] mm)
[14:58:18]   MAGI_Assemblyy_MG996R_servo_9: primitive (box [53.3 x 43.5 x 20.0] mm)
[14:58:18]   MAGI_Assemblyy_HQpod_Femur_2: primitive (box [85.0 x 26.0 x 56.1] mm)
[14:58:18]   MAGI_Assemblyy_MG996R_servo_10: primitive (box [53.3 x 43.5 x 20.0] mm)
[14:58:18]   MAGI_Assemblyy_MG996R_servo_11: primitive (box [53.3 x 43.5 x 20.0] mm)
[14:58:18]   MAGI_Assemblyy_HQpod_Coxal_Right_v2: primitive (box [61.2 x 74.3 x 28.8] mm)
[14:58:18]   MAGI_Assemblyy_MG996R_servo_12: primitive (box [53.3 x 43.5 x 20.0] mm)
[14:58:18]   MAGI_Assemblyy_HQpod_Femur_3: primitive (box [85.0 x 26.0 x 56.1] mm)
[14:58:18]   MAGI_Assemblyy_MG996R_servo_2: primitive (box [53.3 x 43.5 x 20.0] mm)
[14:58:18]   MAGI_Assemblyy_MG996R_servo_3: primitive (box [53.3 x 43.5 x 20.0] mm)
[14:58:18]   MAGI_Assemblyy_HQpod_Femur_4: primitive (box [85.0 x 26.0 x 56.1] mm)
[14:58:18]   MAGI_Assemblyy_MG996R_servo_4: primitive (box [53.3 x 43.5 x 20.0] mm)
[14:58:18]   MAGI_Assemblyy_HQpod_Coxal_Right_v2_2: primitive (box [61.2 x 74.3 x 28.8] mm)
[14:58:18]   MAGI_Assemblyy_MG996R_servo_5: primitive (box [53.3 x 43.5 x 20.0] mm)
[14:58:18]   MAGI_Assemblyy_HQpod_Tibia_Left_New: primitive (cylinder r=53.8 h=28.8 mm)
[14:58:18]   MAGI_Assemblyy_HQpod_Tibia_Left_New_2: primitive (cylinder r=53.8 h=28.8 mm)
[14:58:18]   MAGI_Assemblyy_HQpod_Tibia_Right_New: primitive (cylinder r=53.7 h=28.8 mm)
[14:58:18]   MAGI_Assemblyy_HQpod_Tibia_Right_New_2: primitive (cylinder r=53.7 h=28.8 mm)
[14:58:18] 
  Collision summary:
[14:58:18]     Explicit:        0
[14:58:18]     Primitive (STL): 27
[14:58:18]     Convex hull STL: 0
[14:58:18]     Visual reuse:    0
[14:58:18]     Visual fallback: 0
[14:58:18] 
=== COLLISION: GENERATE STL ===
[14:58:18]   base_link: box -> 12 tris (0.7 KB)
[14:58:18]   HexapodV3Mid: box -> 12 tris (0.7 KB)
[14:58:18]   HexapodV3Top: box -> 12 tris (0.7 KB)
[14:58:18]   MAGI_Assemblyy_MG996R_servo: box -> 12 tris (0.7 KB)
[14:58:18]   MAGI_Assemblyy_HQpod_Coxal_Left_v2: box -> 12 tris (0.7 KB)
[14:58:18]   MAGI_Assemblyy_MG996R_servo_6: box -> 12 tris (0.7 KB)
[14:58:18]   MAGI_Assemblyy_HQpod_Femur: box -> 12 tris (0.7 KB)
[14:58:18]   MAGI_Assemblyy_MG996R_servo_7: box -> 12 tris (0.7 KB)
[14:58:18]   MAGI_Assemblyy_MG996R_servo_8: box -> 12 tris (0.7 KB)
[14:58:18]   MAGI_Assemblyy_HQpod_Coxal_Left_v2_2: box -> 12 tris (0.7 KB)
[14:58:18]   MAGI_Assemblyy_MG996R_servo_9: box -> 12 tris (0.7 KB)
[14:58:18]   MAGI_Assemblyy_HQpod_Femur_2: box -> 12 tris (0.7 KB)
[14:58:18]   MAGI_Assemblyy_MG996R_servo_10: box -> 12 tris (0.7 KB)
[14:58:18]   MAGI_Assemblyy_MG996R_servo_11: box -> 12 tris (0.7 KB)
[14:58:18]   MAGI_Assemblyy_HQpod_Coxal_Right_v2: box -> 12 tris (0.7 KB)
[14:58:18]   MAGI_Assemblyy_MG996R_servo_12: box -> 12 tris (0.7 KB)
[14:58:18]   MAGI_Assemblyy_HQpod_Femur_3: box -> 12 tris (0.7 KB)
[14:58:18]   MAGI_Assemblyy_MG996R_servo_2: box -> 12 tris (0.7 KB)
[14:58:18]   MAGI_Assemblyy_MG996R_servo_3: box -> 12 tris (0.7 KB)
[14:58:18]   MAGI_Assemblyy_HQpod_Femur_4: box -> 12 tris (0.7 KB)
[14:58:18]   MAGI_Assemblyy_MG996R_servo_4: box -> 12 tris (0.7 KB)
[14:58:18]   MAGI_Assemblyy_HQpod_Coxal_Right_v2_2: box -> 12 tris (0.7 KB)
[14:58:18]   MAGI_Assemblyy_MG996R_servo_5: box -> 12 tris (0.7 KB)
[14:58:18]   MAGI_Assemblyy_HQpod_Tibia_Left_New: cylinder -> 96 tris (4.8 KB)
[14:58:18]   MAGI_Assemblyy_HQpod_Tibia_Left_New_2: cylinder -> 96 tris (4.8 KB)
[14:58:18]   MAGI_Assemblyy_HQpod_Tibia_Right_New: cylinder -> 96 tris (4.8 KB)
[14:58:18]   MAGI_Assemblyy_HQpod_Tibia_Right_New_2: cylinder -> 96 tris (4.8 KB)
[14:58:18] 
  Generated 27 collision STL files
[14:58:18] 
=== PACKAGE: FRAMES ===
[14:58:18]   -> debug/frame_model.json (pre-frame cache)
[14:58:18]   Frame convention: ros
[14:58:18]   Frame overrides:  config/frame_overrides.csv
[14:58:18]   Rebased links:    12/27
[14:58:18] 
=== PACKAGE: XACRO ===
[14:58:18]   → urdf/MAGI_Assemblyy.urdf.xacro
[14:58:18]   → urdf/assemblies/MAGI_Assemblyy.urdf.xacro
[14:58:18] 
=== PACKAGE: URDF (flat, for validation) ===
[14:58:18]   → urdf/MAGI_Assemblyy.urdf
[14:58:18] 
=== PACKAGE: ROS2 FILES ===
[14:58:18]   → package.xml
[14:58:18]   → CMakeLists.txt
[14:58:18]   → launch/display.launch.py
[14:58:18]   → rviz/display.rviz
[14:58:18]   → config/joint_state.yaml
[14:58:18]   → config/ros2_controllers.yaml
[14:58:18] 
=== PACKAGE: SUPPLEMENTARY DATA ===
[14:58:18]   → robot_data.yaml
[14:58:18]   -> docs/transforms.md
[14:58:18] 
=== PACKAGE: README ===
[14:58:18]   → README.md
[14:58:18]   Cleaned up 54 retained OBJ/MTL files
[14:58:18] 
=== PACKAGE: COMPLETE ===
[14:58:18]   Package generated: D:/Paras/MAGI/URDF_NEW_2\MAGI_Assemblyy_description
[14:58:18]   Xacro: urdf/MAGI_Assemblyy.urdf.xacro (+ 1 assembly macros)
[14:58:18]   URDF:  urdf/MAGI_Assemblyy.urdf (flat, for validation)
[14:58:18]   Launch: ros2 launch MAGI_Assemblyy_description display.launch.py
[14:58:18] 
=== EXPORT COMPLETE ===
```
