paraspective/MAGI-v2/hardware/urdf/MAGI_Assembly_URDF_description/urdf/assemblies/MAGI_Assembly_URDF.urdf.xacro

<?xml version="1.0"?>
<robot xmlns:xacro="http://www.ros.org/wiki/xacro" name="MAGI_Assembly_URDF_macro">

  <xacro:macro name="MAGI_Assembly_URDF" params="prefix">

    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
    <link name="${prefix}base_link">
      <inertial>
        <origin xyz="0.188950 1.012566 0.124814" rpy="0 0 0"/>
        <mass value="0.461432"/>
        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
      </inertial>
      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
    </link>

    <link name="${prefix}HexapodV3Mid">
      <inertial>
        <origin xyz="0.056935 -0.338657 0.392833" rpy="0 0 0"/>
        <mass value="0.430715"/>
        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
      </inertial>
      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
    </link>

    <link name="${prefix}HexapodV3Top">
      <inertial>
        <origin xyz="0.148577 2.513000 0.237965" rpy="0 0 0"/>
        <mass value="1.329055"/>
        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
      </inertial>
      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
    </link>

    <link name="${prefix}MAGI_Assembly_URDF_MG996R_servo">
      <inertial>
        <origin xyz="0.020183 0.019509 0.000018" rpy="0 0 0"/>
        <mass value="0.240073"/>
        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
      </inertial>
      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
    </link>

    <link name="${prefix}MAGI_Assembly_URDF_MG996R_servo_9">
      <inertial>
        <origin xyz="0.020183 0.019509 0.000018" rpy="0 0 0"/>
        <mass value="0.240073"/>
        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
      </inertial>
      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
    </link>

    <link name="${prefix}MAGI_Assembly_URDF_MG996R_servo_12">
      <inertial>
        <origin xyz="0.020183 0.019509 0.000018" rpy="0 0 0"/>
        <mass value="0.240073"/>
        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
      </inertial>
      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
    </link>

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
      </inertial>
      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
    </link>

    <link name="${prefix}MAGI_Assembly_URDF_HQpod_Tibia_Left_2">
      <inertial>
        <origin xyz="0.000000 0.000000 0.000000" rpy="0 0 0"/>
        <mass value="0.001000"/>
        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
      </inertial>
      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
    </link>

    <link name="${prefix}MAGI_Assembly_URDF_HQpod_Tibia_Right_2">
      <inertial>
        <origin xyz="0.000000 0.000000 0.000000" rpy="0 0 0"/>
        <mass value="0.001000"/>
        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
      </inertial>
      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
    </link>

    <link name="${prefix}MAGI_Assembly_URDF_HQpod_Tibia_Right">
      <inertial>
        <origin xyz="0.000000 0.000000 0.000000" rpy="0 0 0"/>
        <mass value="0.001000"/>
        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
      </inertial>
      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
    </link>

    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
    <joint name="${prefix}Rigid_1" type="fixed">
      <parent link="${prefix}base_link"/>
      <child link="${prefix}HexapodV3Mid"/>
      <origin xyz="0.113207 1.351156 -0.242000" rpy="-0.000000 0.000000 0.000000"/>
    </joint>

    <joint name="${prefix}Rigid_2" type="fixed">
      <parent link="${prefix}HexapodV3Mid"/>
      <child link="${prefix}HexapodV3Top"/>
      <origin xyz="-0.074434 -2.851566 0.152148" rpy="0.000000 0.000000 0.000000"/>
    </joint>

    <joint name="${prefix}Rigid_4" type="fixed">
      <parent link="${prefix}HexapodV3Top"/>
      <child link="${prefix}MAGI_Assembly_URDF_MG996R_servo"/>
      <origin xyz="0.054925 2.437386 0.211602" rpy="1.570796 0.000000 0.785398"/>
    </joint>

    <joint name="${prefix}Rigid_10" type="fixed">
      <parent link="${prefix}HexapodV3Top"/>
      <child link="${prefix}MAGI_Assembly_URDF_MG996R_servo_9"/>
      <origin xyz="0.243915 2.588642 0.211602" rpy="1.570796 0.000000 -2.356194"/>
    </joint>

    <joint name="${prefix}Rigid_17" type="fixed">
      <parent link="${prefix}HexapodV3Top"/>
      <child link="${prefix}MAGI_Assembly_URDF_MG996R_servo_12"/>
      <origin xyz="0.244023 2.437165 0.210956" rpy="1.570796 0.000000 2.356194"/>
    </joint>

    <joint name="${prefix}Rigid_29" type="fixed">
      <parent link="${prefix}HexapodV3Top"/>
      <child link="${prefix}MAGI_Assembly_URDF_MG996R_servo_4"/>
      <origin xyz="0.054739 2.588547 0.210956" rpy="1.570796 0.000000 -0.785398"/>
    </joint>

    <joint name="${prefix}Revolute_5" type="revolute">
      <parent link="${prefix}MAGI_Assembly_URDF_MG996R_servo"/>
      <child link="${prefix}MAGI_Assembly_URDF_HQpod_Coxal_Left_v2"/>
      <origin xyz="0.389152 0.569011 0.023325" rpy="-1.570796 -0.785398 0.000000"/>
      <axis xyz="0.000000 0.000000 1.000000"/>
      <limit lower="-0.593412" upper="1.570796" effort="100.0" velocity="1.00"/>
    </joint>

    <joint name="${prefix}Revolute_12" type="revolute">
      <parent link="${prefix}MAGI_Assembly_URDF_MG996R_servo_9"/>
      <child link="${prefix}MAGI_Assembly_URDF_HQpod_Coxal_Left_v2_2"/>
      <origin xyz="0.525758 0.394657 0.025361" rpy="1.570796 0.785398 -3.141593"/>
      <axis xyz="0.000000 0.000000 1.000000"/>
      <limit lower="-0.383972" upper="1.570796" effort="100.0" velocity="1.00"/>
    </joint>

    <joint name="${prefix}Revolute_31" type="revolute">
      <parent link="${prefix}MAGI_Assembly_URDF_MG996R_servo_12"/>
      <child link="${prefix}MAGI_Assembly_URDF_HQpod_Coxal_Right_v2_2"/>
      <origin xyz="-1.178517 0.396542 0.007343" rpy="1.570796 -0.785398 3.141593"/>
      <axis xyz="0.000000 0.000000 1.000000"/>
      <limit lower="-1.570796" upper="0.383972" effort="100.0" velocity="1.00"/>
    </joint>

    <joint name="${prefix}Revolute_24" type="revolute">
      <parent link="${prefix}MAGI_Assembly_URDF_MG996R_servo_4"/>
      <child link="${prefix}MAGI_Assembly_URDF_HQpod_Coxal_Right_v2"/>
      <origin xyz="-1.315235 0.571189 0.010147" rpy="-1.570796 0.785398 0.000000"/>
      <axis xyz="0.000000 0.000000 1.000000"/>
      <limit lower="-1.570796" upper="0.593412" effort="100.0" velocity="1.00"/>
    </joint>

    <joint name="${prefix}Rigid_6" type="fixed">
      <parent link="${prefix}MAGI_Assembly_URDF_HQpod_Coxal_Left_v2"/>
      <child link="${prefix}MAGI_Assembly_URDF_MG996R_servo_7"/>
      <origin xyz="-0.300345 -0.298625 -0.573417" rpy="-2.077761 -1.570782 2.848271"/>
    </joint>

    <joint name="${prefix}Rigid_13" type="fixed">
      <parent link="${prefix}MAGI_Assembly_URDF_HQpod_Coxal_Left_v2_2"/>
      <child link="${prefix}MAGI_Assembly_URDF_MG996R_servo_10"/>
      <origin xyz="0.398051 0.394361 -0.399161" rpy="-2.077761 -1.570782 -0.293322"/>
    </joint>

    <joint name="${prefix}Rigid_35" type="fixed">
      <parent link="${prefix}MAGI_Assembly_URDF_HQpod_Coxal_Right_v2_2"/>
      <child link="${prefix}MAGI_Assembly_URDF_MG996R_servo_5"/>
      <origin xyz="-0.829584 0.788290 -0.400947" rpy="-0.545389 -1.570792 -0.219497"/>
    </joint>

    <joint name="${prefix}Rigid_25" type="fixed">
      <parent link="${prefix}MAGI_Assembly_URDF_HQpod_Coxal_Right_v2"/>
      <child link="${prefix}MAGI_Assembly_URDF_MG996R_servo_3"/>
      <origin xyz="0.928230 -0.882970 -0.575629" rpy="-0.545389 -1.570792 2.922096"/>
    </joint>

    <joint name="${prefix}Revolute_7" type="revolute">
      <parent link="${prefix}MAGI_Assembly_URDF_MG996R_servo_7"/>
      <child link="${prefix}MAGI_Assembly_URDF_HQpod_Femur"/>
      <origin xyz="-0.061224 -0.389313 -0.445687" rpy="1.570796 1.570777 -3.141593"/>
      <axis xyz="0.000000 0.000000 1.000000"/>
      <limit lower="-1.396263" upper="0.959931" effort="100.0" velocity="1.00"/>
    </joint>

    <joint name="${prefix}Revolute_14" type="revolute">
      <parent link="${prefix}MAGI_Assembly_URDF_MG996R_servo_10"/>
      <child link="${prefix}MAGI_Assembly_URDF_HQpod_Femur_2"/>
      <origin xyz="0.072694 -0.389411 0.810137" rpy="-1.570796 -1.570777 -0.000000"/>
      <axis xyz="0.000000 0.000000 1.000000"/>
      <limit lower="-1.396263" upper="0.959931" effort="100.0" velocity="1.00"/>
    </joint>

    <joint name="${prefix}Revolute_32" type="revolute">
      <parent link="${prefix}MAGI_Assembly_URDF_MG996R_servo_5"/>
      <child link="${prefix}MAGI_Assembly_URDF_HQpod_Femur_4"/>
      <origin xyz="-0.571739 -0.389958 -0.438697" rpy="-1.570796 1.570791 -0.000000"/>
      <axis xyz="0.000000 0.000000 1.000000"/>
      <limit lower="-0.959931" upper="1.396263" effort="100.0" velocity="1.00"/>
    </joint>

    <joint name="${prefix}Revolute_26" type="revolute">
      <parent link="${prefix}MAGI_Assembly_URDF_MG996R_servo_3"/>
      <child link="${prefix}MAGI_Assembly_URDF_HQpod_Femur_3"/>
      <origin xyz="-0.590615 -0.389993 -0.124604" rpy="1.570796 -1.570791 3.141593"/>
      <axis xyz="0.000000 0.000000 1.000000"/>
      <limit lower="-0.959931" upper="1.396263" effort="100.0" velocity="1.00"/>
    </joint>

    <joint name="${prefix}Revolute_8" type="revolute">
      <parent link="${prefix}MAGI_Assembly_URDF_HQpod_Femur"/>
      <child link="${prefix}MAGI_Assembly_URDF_MG996R_servo_8"/>
      <origin xyz="-0.456212 0.048197 1.279788" rpy="0.000000 0.000000 0.000000"/>
      <axis xyz="0.000000 0.000000 1.000000"/>
      <limit lower="-1.570796" upper="1.570796" effort="100.0" velocity="1.00"/>
    </joint>

    <joint name="${prefix}Revolute_15" type="revolute">
      <parent link="${prefix}MAGI_Assembly_URDF_HQpod_Femur_2"/>
      <child link="${prefix}MAGI_Assembly_URDF_MG996R_servo_11"/>
      <origin xyz="-0.509995 -0.349198 1.524726" rpy="0.000000 0.000000 0.000000"/>
      <axis xyz="0.000000 0.000000 1.000000"/>
      <limit lower="-1.570796" upper="1.570796" effort="100.0" velocity="1.00"/>
    </joint>

    <joint name="${prefix}Revolute_33" type="revolute">
      <parent link="${prefix}MAGI_Assembly_URDF_HQpod_Femur_4"/>
      <child link="${prefix}MAGI_Assembly_URDF_MG996R_servo_6"/>
      <origin xyz="-0.039675 -0.464855 1.280594" rpy="0.000000 0.000000 0.000000"/>
      <axis xyz="0.000000 0.000000 1.000000"/>
      <limit lower="-1.570796" upper="1.570796" effort="100.0" velocity="1.00"/>
    </joint>

    <joint name="${prefix}Revolute_27" type="revolute">
      <parent link="${prefix}MAGI_Assembly_URDF_HQpod_Femur_3"/>
      <child link="${prefix}MAGI_Assembly_URDF_MG996R_servo_2"/>
      <origin xyz="0.016368 0.651577 1.524259" rpy="0.000000 0.000000 0.000000"/>
      <axis xyz="0.000000 0.000000 1.000000"/>
      <limit lower="-1.570796" upper="1.570796" effort="100.0" velocity="1.00"/>
    </joint>

    <joint name="${prefix}Rigid_9" type="fixed">
      <parent link="${prefix}MAGI_Assembly_URDF_MG996R_servo_8"/>
      <child link="${prefix}MAGI_Assembly_URDF_HQpod_Tibia_Left"/>
      <origin xyz="0.053166 -0.665761 -0.837464" rpy="3.141593 0.000000 1.047179"/>
    </joint>

    <joint name="${prefix}Rigid_16" type="fixed">
      <parent link="${prefix}MAGI_Assembly_URDF_MG996R_servo_11"/>
      <child link="${prefix}MAGI_Assembly_URDF_HQpod_Tibia_Left_2"/>
      <origin xyz="-0.342786 0.832867 -1.082304" rpy="-3.141593 0.000000 -2.094414"/>
    </joint>

    <joint name="${prefix}Rigid_34" type="fixed">
      <parent link="${prefix}MAGI_Assembly_URDF_MG996R_servo_6"/>
      <child link="${prefix}MAGI_Assembly_URDF_HQpod_Tibia_Right_2"/>
      <origin xyz="-0.017717 -0.899331 -0.724813" rpy="-3.141589 -0.000003 -1.047192"/>
    </joint>

    <joint name="${prefix}Rigid_30" type="fixed">
      <parent link="${prefix}MAGI_Assembly_URDF_MG996R_servo_2"/>
      <child link="${prefix}MAGI_Assembly_URDF_HQpod_Tibia_Right"/>
      <origin xyz="-0.273455 0.731255 -0.968443" rpy="-3.141589 -0.000003 2.094400"/>
    </joint>

    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
    <ros2_control name="${prefix}MAGI_Assembly_URDF_system" type="system">
      <hardware>
        <plugin>mock_components/GenericSystem</plugin>
        <param name="cmd_topic">sim/MAGI_Assembly_URDF_system/cmd</param>
        <param name="state_topic">sim/MAGI_Assembly_URDF_system/state</param>
      </hardware>

      <joint name="${prefix}Revolute_12">
        <command_interface name="position"/>
        <command_interface name="velocity"/>
        <state_interface name="position">
          <param name="initial_value">0.0</param>
        </state_interface>
        <state_interface name="velocity"/>
        <state_interface name="effort"/>
      </joint>
      <joint name="${prefix}Revolute_14">
        <command_interface name="position"/>
        <command_interface name="velocity"/>
        <state_interface name="position">
          <param name="initial_value">0.0</param>
        </state_interface>
        <state_interface name="velocity"/>
        <state_interface name="effort"/>
      </joint>
      <joint name="${prefix}Revolute_15">
        <command_interface name="position"/>
        <command_interface name="velocity"/>
        <state_interface name="position">
          <param name="initial_value">0.0</param>
        </state_interface>
        <state_interface name="velocity"/>
        <state_interface name="effort"/>
      </joint>
      <joint name="${prefix}Revolute_24">
        <command_interface name="position"/>
        <command_interface name="velocity"/>
        <state_interface name="position">
          <param name="initial_value">0.0</param>
        </state_interface>
        <state_interface name="velocity"/>
        <state_interface name="effort"/>
      </joint>
      <joint name="${prefix}Revolute_26">
        <command_interface name="position"/>
        <command_interface name="velocity"/>
        <state_interface name="position">
          <param name="initial_value">0.0</param>
        </state_interface>
        <state_interface name="velocity"/>
        <state_interface name="effort"/>
      </joint>
      <joint name="${prefix}Revolute_27">
        <command_interface name="position"/>
        <command_interface name="velocity"/>
        <state_interface name="position">
          <param name="initial_value">0.0</param>
        </state_interface>
        <state_interface name="velocity"/>
        <state_interface name="effort"/>
      </joint>
      <joint name="${prefix}Revolute_31">
        <command_interface name="position"/>
        <command_interface name="velocity"/>
        <state_interface name="position">
          <param name="initial_value">0.0</param>
        </state_interface>
        <state_interface name="velocity"/>
        <state_interface name="effort"/>
      </joint>
      <joint name="${prefix}Revolute_32">
        <command_interface name="position"/>
        <command_interface name="velocity"/>
        <state_interface name="position">
          <param name="initial_value">0.0</param>
        </state_interface>
        <state_interface name="velocity"/>
        <state_interface name="effort"/>
      </joint>
      <joint name="${prefix}Revolute_33">
        <command_interface name="position"/>
        <command_interface name="velocity"/>
        <state_interface name="position">
          <param name="initial_value">0.0</param>
        </state_interface>
        <state_interface name="velocity"/>
        <state_interface name="effort"/>
      </joint>
      <joint name="${prefix}Revolute_5">
        <command_interface name="position"/>
        <command_interface name="velocity"/>
        <state_interface name="position">
          <param name="initial_value">0.0</param>
        </state_interface>
        <state_interface name="velocity"/>
        <state_interface name="effort"/>
      </joint>
      <joint name="${prefix}Revolute_7">
        <command_interface name="position"/>
        <command_interface name="velocity"/>
        <state_interface name="position">
          <param name="initial_value">0.0</param>
        </state_interface>
        <state_interface name="velocity"/>
        <state_interface name="effort"/>
      </joint>
      <joint name="${prefix}Revolute_8">
        <command_interface name="position"/>
        <command_interface name="velocity"/>
        <state_interface name="position">
          <param name="initial_value">0.0</param>
        </state_interface>
        <state_interface name="velocity"/>
        <state_interface name="effort"/>
      </joint>
    </ros2_control>

  </xacro:macro>

</robot>
