paraspective/MAGI-v2/simulation/models/urdf/SpiderQ.urdf

<?xml version="1.0" encoding="UTF-8"?>
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

<robot name="SpiderQ">

  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
  <link name="base_link">
    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
    <inertial>
      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
      <mass value="0.150"/>
      <origin xyz="0.0 0.106 0.0" rpy="0 0 0"/>
      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
    </inertial>
  </link>

  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
  <joint name="coxa_joint_0" type="revolute">
    <parent link="base_link"/>
    <child link="coxa_link_0"/>
    <origin xyz="-0.050 0.077 -0.041" rpy="0 0 0"/>
    <axis xyz="0 1 0"/>   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
    <limit lower="-1.5708" upper="1.5708" effort="1.8" velocity="6.28"/>
    <dynamics damping="0.01" friction="0.001"/>
  </joint>

  <link name="coxa_link_0">
    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
    <inertial>
      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
      <mass value="0.008"/>
      <origin xyz="0 0 0" rpy="0 0 0"/>
      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
    </inertial>
  </link>

  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
  <joint name="femur_joint_0" type="revolute">
    <parent link="coxa_link_0"/>
    <child link="femur_link_0"/>
    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
    <origin xyz="-0.030 -0.008 -0.028" rpy="0 0 0"/>
    <axis xyz="0 0 1"/>   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
    <limit lower="-1.5708" upper="1.5708" effort="1.8" velocity="6.28"/>
    <dynamics damping="0.01" friction="0.001"/>
  </joint>

  <link name="femur_link_0">
    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
    <inertial>
      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
      <mass value="0.015"/>
      <origin xyz="0 0 0" rpy="0 0 0"/>
      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
    </inertial>
  </link>

  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
  <joint name="tibia_joint_0" type="revolute">
    <parent link="femur_link_0"/>
    <child link="tibia_link_0"/>
    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
    <origin xyz="-0.010 -0.0005 -0.011" rpy="0 0 0"/>
    <axis xyz="0 0 1"/>
    <limit lower="-2.0944" upper="0.1745" effort="1.8" velocity="6.28"/>
    <dynamics damping="0.01" friction="0.001"/>
  </joint>

  <link name="tibia_link_0">
    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
    <inertial>
      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
      <mass value="0.010"/>
      <origin xyz="0 0 0" rpy="0 0 0"/>
      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
    </inertial>
  </link>

  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
  <joint name="foot_joint_0" type="fixed">
    <parent link="tibia_link_0"/>
    <child link="foot_link_0"/>
    <origin xyz="-0.090 0.0 -0.020" rpy="0 0 0"/>
  </joint>
  <link name="foot_link_0">
    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
    <inertial>
      <mass value="0.002"/>
      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
    </inertial>
  </link>

  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

  <joint name="coxa_joint_1" type="revolute">
    <parent link="base_link"/>
    <child link="coxa_link_1"/>
    <origin xyz="0.050 0.077 -0.041" rpy="0 0 0"/>
    <axis xyz="0 1 0"/>
    <limit lower="-1.5708" upper="1.5708" effort="1.8" velocity="6.28"/>
    <dynamics damping="0.01" friction="0.001"/>
  </joint>

  <link name="coxa_link_1">
    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
    <inertial>
      <mass value="0.008"/>
      <origin xyz="0 0 0" rpy="0 0 0"/>
      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
    </inertial>
  </link>

  <joint name="femur_joint_1" type="revolute">
    <parent link="coxa_link_1"/>
    <child link="femur_link_1"/>
    <origin xyz="0.032 -0.008 -0.029" rpy="0 0 0"/>
    <axis xyz="0 0 1"/>
    <limit lower="-1.5708" upper="1.5708" effort="1.8" velocity="6.28"/>
    <dynamics damping="0.01" friction="0.001"/>
  </joint>

  <link name="femur_link_1">
    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
    <inertial>
      <mass value="0.015"/>
      <origin xyz="0 0 0" rpy="0 0 0"/>
      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
    </inertial>
  </link>

  <joint name="tibia_joint_1" type="revolute">
    <parent link="femur_link_1"/>
    <child link="tibia_link_1"/>
    <origin xyz="0.028 -0.0005 -0.036" rpy="0 0 0"/>
    <axis xyz="0 0 1"/>
    <limit lower="-2.0944" upper="0.1745" effort="1.8" velocity="6.28"/>
    <dynamics damping="0.01" friction="0.001"/>
  </joint>

  <link name="tibia_link_1">
    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
    <inertial>
      <mass value="0.010"/>
      <origin xyz="0 0 0" rpy="0 0 0"/>
      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
    </inertial>
  </link>

  <joint name="foot_joint_1" type="fixed">
    <parent link="tibia_link_1"/>
    <child link="foot_link_1"/>
    <origin xyz="0.090 0.0 -0.020" rpy="0 0 0"/>
  </joint>
  <link name="foot_link_1">
    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
    <inertial>
      <mass value="0.002"/>
      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
    </inertial>
  </link>

  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

  <joint name="coxa_joint_2" type="revolute">
    <parent link="base_link"/>
    <child link="coxa_link_2"/>
    <origin xyz="-0.050 0.077 0.041" rpy="0 0 0"/>
    <axis xyz="0 1 0"/>
    <limit lower="-1.5708" upper="1.5708" effort="1.8" velocity="6.28"/>
    <dynamics damping="0.01" friction="0.001"/>
  </joint>

  <link name="coxa_link_2">
    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
    <inertial>
      <mass value="0.008"/>
      <origin xyz="0 0 0" rpy="0 0 0"/>
      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
    </inertial>
  </link>

  <joint name="femur_joint_2" type="revolute">
    <parent link="coxa_link_2"/>
    <child link="femur_link_2"/>
    <origin xyz="-0.032 -0.008 0.029" rpy="0 0 0"/>
    <axis xyz="0 0 1"/>
    <limit lower="-1.5708" upper="1.5708" effort="1.8" velocity="6.28"/>
    <dynamics damping="0.01" friction="0.001"/>
  </joint>

  <link name="femur_link_2">
    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
    <inertial>
      <mass value="0.015"/>
      <origin xyz="0 0 0" rpy="0 0 0"/>
      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
    </inertial>
  </link>

  <joint name="tibia_joint_2" type="revolute">
    <parent link="femur_link_2"/>
    <child link="tibia_link_2"/>
    <origin xyz="-0.040 -0.0005 0.030" rpy="0 0 0"/>
    <axis xyz="0 0 1"/>
    <limit lower="-2.0944" upper="0.1745" effort="1.8" velocity="6.28"/>
    <dynamics damping="0.01" friction="0.001"/>
  </joint>

  <link name="tibia_link_2">
    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
    <inertial>
      <mass value="0.010"/>
      <origin xyz="0 0 0" rpy="0 0 0"/>
      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
    </inertial>
  </link>

  <joint name="foot_joint_2" type="fixed">
    <parent link="tibia_link_2"/>
    <child link="foot_link_2"/>
    <origin xyz="-0.122 0.0 0.100" rpy="0 0 0"/>
  </joint>
  <link name="foot_link_2">
    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
    <inertial>
      <mass value="0.002"/>
      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
    </inertial>
  </link>

  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

  <joint name="coxa_joint_3" type="revolute">
    <parent link="base_link"/>
    <child link="coxa_link_3"/>
    <origin xyz="0.050 0.077 0.041" rpy="0 0 0"/>
    <axis xyz="0 1 0"/>
    <limit lower="-1.5708" upper="1.5708" effort="1.8" velocity="6.28"/>
    <dynamics damping="0.01" friction="0.001"/>
  </joint>

  <link name="coxa_link_3">
    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
    <inertial>
      <mass value="0.008"/>
      <origin xyz="0 0 0" rpy="0 0 0"/>
      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
    </inertial>
  </link>

  <joint name="femur_joint_3" type="revolute">
    <parent link="coxa_link_3"/>
    <child link="femur_link_3"/>
    <origin xyz="0.032 -0.008 0.029" rpy="0 0 0"/>
    <axis xyz="0 0 1"/>
    <limit lower="-1.5708" upper="1.5708" effort="1.8" velocity="6.28"/>
    <dynamics damping="0.01" friction="0.001"/>
  </joint>

  <link name="femur_link_3">
    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
    <inertial>
      <mass value="0.015"/>
      <origin xyz="0 0 0" rpy="0 0 0"/>
      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
    </inertial>
  </link>

  <joint name="tibia_joint_3" type="revolute">
    <parent link="femur_link_3"/>
    <child link="tibia_link_3"/>
    <origin xyz="0.040 -0.0005 0.030" rpy="0 0 0"/>
    <axis xyz="0 0 1"/>
    <limit lower="-2.0944" upper="0.1745" effort="1.8" velocity="6.28"/>
    <dynamics damping="0.01" friction="0.001"/>
  </joint>

  <link name="tibia_link_3">
    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
    <inertial>
      <mass value="0.010"/>
      <origin xyz="0 0 0" rpy="0 0 0"/>
      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
    </inertial>
  </link>

  <joint name="foot_joint_3" type="fixed">
    <parent link="tibia_link_3"/>
    <child link="foot_link_3"/>
    <origin xyz="0.122 0.0 0.100" rpy="0 0 0"/>
  </joint>
  <link name="foot_link_3">
    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
    <inertial>
      <mass value="0.002"/>
      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
    </inertial>
  </link>

</robot>
