paraspective/MAGI-v2/(commit log)

2026-09-03 feat(simulation): migrate and structure simulation development code
    [SpiderQ.urdf]
2026-10-24 feat(arch): restructure MAGI repository into Past, Present, and Future lifecycles
    - Present: Consolidate active production subsystems (hardware, firmware, OS, simulation, perception, tools)
    - Hardware: Standardize CAD, verified 3D print STLs, BOM, and official MAGI_Assembly_URDF ROS 2 package
    - Perception: Unify camera streaming, MLOps plant pathology pipeline, and spectral heatmaps
    - Past: Classify historical prototypes, deprecated CAD iterations, and attributed open-source references under archive/
    - Future: Establish comprehensive strategic roadmap (ROADMAP.md), technical backlog (TODO.md), and IEEE research paper (paper/)
    - Hygiene: Implement robust .gitignore, root MIT LICENSE, CONTRIBU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
    [1x_Back_cover.stl, 1x_Front_cover.stl, 1x_Mount_Buck_Converters.stl, 2x_Frame_large.stl, 2x_Frame_small.stl, 2x_Servo_mount_left.stl, 2x_Servo_mount_right.stl, 2x_Side_cover_1.stl]
2026-10-25 fix(os): import LifecycleNode in dashboard.py to resolve CI lint failure
    [dashboard.py]
2026-10-27 Add new files and folders
    [CarapaceBack_1.stl, CarapaceFront_1.stl, CarapaceMid_1.stl, ControllerPlate_1.stl, ElectronicsPlate_1.stl, FrameSideServoHolder_1 (2).stl, FrameSideServoHolder_1__1__1.stl, FrameSideServoHolder__1__1.stl]
2026-10-29 refactor: clean repository structure and documentation
    - Relocate MAGI_iti3_urdf into archive/urdf_iterations/MAGI_iteration3
    - Consolidate paper manuscript into docs/paper/
    - Remove legacy duplicate tools/ directory
    - Remove duplicate architectural and project report PDFs from OS/
    - Rewrite README, ROADMAP, TODO, and CONTRIBUTING in a clear, human engineering voice
    - Update .gitignore to exclude local dev directories
    [CarapaceBack_1.stl, CarapaceFront_1.stl, CarapaceMid_1.stl, ControllerPlate_1.stl, ElectronicsPlate_1.stl, FrameSideServoHolder_1 (2).stl, FrameSideServoHolder_1__1__1.stl, FrameSideServoHolder__1__1.stl]
