paraspective/MAGI-v2/(notices)

Notices in the files:
README.md:
License: MIT
